ducnguyen4993/-Dispersing-Chemical-Liquids/78160_1459436697335_PF.jpg

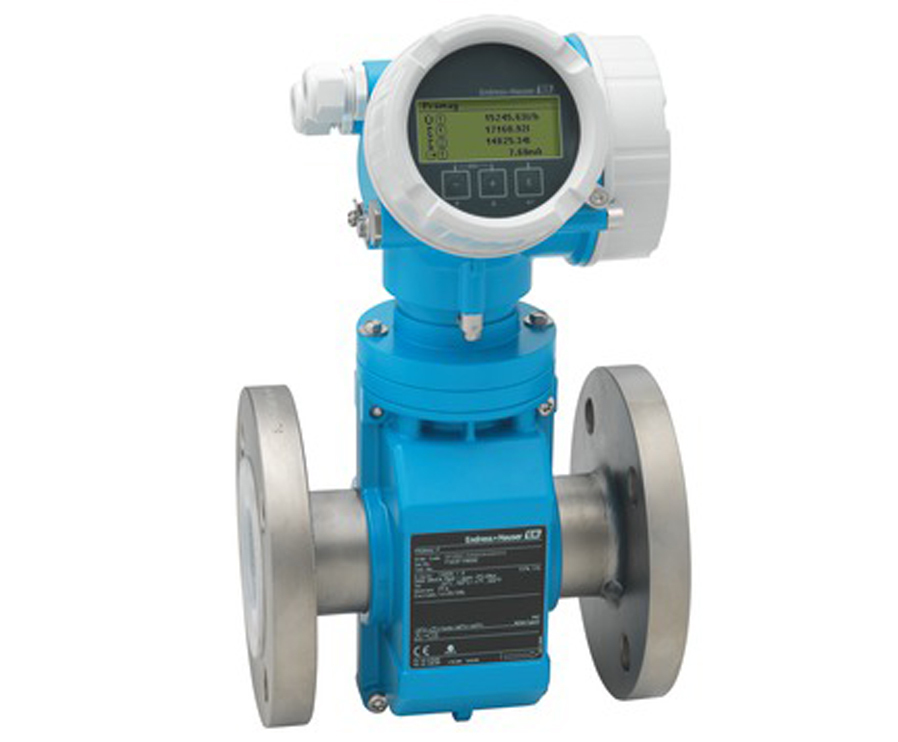
78160_1459436697335_PF.jpg
