ducnguyen4993/-Dispersing-Chemical-Liquids/axss1.jpg

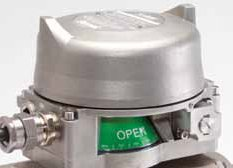
axss1.jpg
