ducnguyen4993/-Dispersing-Chemical-Liquids/IOtable.pdf

# I/O LOOP LIST

INSTRUMENTATION
PRELIMINARY
Date | Name | Change | Rev.
| Group 8: Duc Nguyen & Hieu Nguyen
Loop Tag | Loop Desc 1 | Loop Desc 2 | # | Device Tag | DCS Range | DCS Unit | Device Name | FBC slot | Card | I/O Address | AAI | AI | AO | BI | BO | Signal | Supply | Remarks | Rev.
HS-511 | MIXING TANK | NaOH VALVE | 1 | ZSO_511 | - | | OPEN LIMIT | 2 | 0 | 2.0.0.0 | | | | 1 | | NO
HS-511 | MIXING TANK | NaOH VALVE | 2 | ZSC_511 | - | | CLOSED LIMIT | 2 | 0 | 2.0.0.1 | | | | 1 | | NO
HS-511 | MIXING TANK | NaOH VALVE | 3 | GSV_511 | - | | SOLENOID VALVE | 2 | 3 | 2.0.3.0 | | | | | 1 | | 6 Bar
HS-510 | MIXING TANK | WATER VALVE | 1 | ZSO_510 | - | | OPEN LIMIT | 2 | 0 | 2.0.0.2 | | | | 1 | | NO
HS-510 | MIXING TANK | WATER VALVE | 2 | ZSC_510 | - | | CLOSED LIMIT | 2 | 0 | 2.0.0.3 | | | | 1 | | NO
HS-510 | MIXING TANK | WATER VALVE | 3 | GSV_510 | - | | SOLENOID VALVE | 2 | 3 | 2.0.3.1 | | | | | 1 | | 6 Bar
LI-512 | MIXING TANK | LEVEL | 1 | LT-512 | 0-2000 | mm | LEVEL SENSOR | 3 | 0 | 3.0.0.0 | | 1 | | | | 4-20mA
TI-517 | MIXING TANK | TEMPERATURE | 1 | TT-517 | 0-100 | °C | TEMPERATURE SENSOR | 3 | 0 | 3.0.0.1 | | 1 | | | | 4-20mA
HS-514 | STORAGE TANK | MIXING TANK | 1 | ZSO_514 | - | | OPEN LIMIT | 2 | 0 | 2.0.0.4 | | | | 1 | | NO
HS-514 | STORAGE TANK | MIXING TANK | 2 | ZSC_514 | - | | CLOSED LIMIT | 2 | 0 | 2.0.0.5 | | | | 1 | | NO
HS-514 | STORAGE TANK | MIXING TANK | 3 | GSV_514 | - | | SOLENOID VALVE | 2 | 3 | 2.0.3.2 | | | | | 1 | | 6 Bar
TI-518 | STORAGE TANK | TEMPERATURE | 1 | TT-518 | 0-100 | °C | TEMPERATURE SENSOR | 3 | 0 | 3.0.0.2 | | 1 | | | | 4-20mA
LI-515 | STORAGE TANK | LEVEL | 1 | LT-515 | 0-5000 | mm | LEVEL SENSOR | 3 | 0 | 3.0.0.3 | | 1 | | | | 4-20mA
LSA-513 | POWDER TANK | LEVEL | 1 | LT-513 | 0-100 | % | LEVEL SENSOR | 3 | 0 | 3.0.0.4 | | 1 | | | | 4-20mA
LSA-513 | POWDER TANK | LEVEL | 2 | LA-513 | - | - | LOW LEVEL ALARM | 2 | 2 | 2.0.2.0 | | | | 1 | | NO
HS-519 | PROCESS | PUMP | 1 | ZSO_519 | - | | OPEN LIMIT | 2 | 0 | 2.0.0.6 | | | | 1 | | NO
HS-519 | PROCESS | PUMP | 2 | ZSC_519 | - | | CLOSED LIMIT | 2 | 0 | 2.0.0.7 | | | | 1 | | NO
HS-519 | PROCESS | PUMP | 3 | GSV_519 | - | | SOLENOID VALVE | 2 | 3 | 2.0.3.3 | | | | | 1 | | 6 Bar
FIC-516 | PUMP | FLOW | 1 | FT-516 | 0.01-10 | m/s | FLOW SENSOR | 3 | 0 | 3.0.0.5 | | 1 | | | | 4-20mA
HIV-521 | STORAGE TANK | PUMP | 1 | CV_521 | 0-100 | % | CONTROL VALVE | 3 | 1 | 3.0.1.0 | | | 1 | | | 4-20mA
HIV-521 | STORAGE TANK | PUMP | 2 | PF_521 | 0-100 | % | POSITION FEEDBACK | 3 | 0 | 3.0.0.6 | | 1 | | | | 4-20mA
HIV-521 | STORAGE TANK | PUMP | 3 | ZSO_521 | - | | OPEN LIMIT | 2 | 1 | 2.0.1.0 | | | | 1 | | NO
HIV-521 | STORAGE TANK | PUMP | 4 | ZSC_521 | - | | CLOSED LIMIT | 2 | 1 | 2.0.1.1 | | | | 1 | | NO
HIV-521 | STORAGE TANK | PUMP | 5 | GSV_521 | - | | SOLENOID VALVE | 2 | 3 | 2.0.3.4 | | | | | 1 | | 6 Bar
M001 | MIXING TANK | POWDER FEED | 1 | M001_ST | | | M001 START | 2 | 3 | 2.0.3.6 | | | | | 1
Printed 5/5/2018 | IOtable.xlsx | 1 (1)
