ducnguyen4993/-Dispersing-Chemical-Liquids/projectwork.pdf

## PROJECT WORK

Dispersing Unit Design

Bachelor’s thesis

Valkeakoski Campus
Electrical and Automation Engineering

2018

Hieu Nguyen
Duc Nguyen

ABSTRACT

Electrical and Automation Engineering
Valkeakoski
Author | Nguyen Trung Hieu, Nguyen Quang Duc | Year 2018
Subject | Dispersing Unit Design
Supervisor(s) | Timo Väisänen

ABSTRACT

Based on the P&I diagram which was given by the supervisor, the objective of the project is to identify the symbols of components in the drawing and select the most suitable devices for the system of the project. In addition, the purpose of the project was also to design the cabinet for the control room, the wiring system, cable connection and software for PLC.

In the beginning, this project was instructed by the supervisor with the explanation and the plan to do the project. There are the computer tools supporting the project work which were taught and applied by the supervisor and other HAMK teachers. These tools were mainly for designing the system and software for PLC. Furthermore, the questions emerging during working on the project were answered or suggested by the supervisor. Other sources were electrical and automation manufacturers’ websites. These websites were used to choose the suitable devices and motors for the system.

In total, the project work was accomplished with fourteen types of documents such as the system drawings, cabinet layout, cable list, motor list, instruments list, etc. The design of the system met the requirement of the project and 95% of the project work could be used to build the real system in real life.

The project instructs and helps students to get familiar with real work in a professional environment and it is necessary to promote the students’ skills. These skills are suggested to be reinforced and tested more exactly by adding one more part to the project. That is to have a sample of a real system to test the students’ work in real life.
Keywords | Dispersing Unit Design, P&I diagram, cabinet, system design.
Pages | 37 pages including appendices 1 pages

CONTENTS

Appendices
Appendix 1 Name of appendix

1 INTRODUCTION

The project work’s purpose is to help students to get familiar and started with basic steps and ways of working in professional environment when implementing a small plant like an automation system and making its technical documentation. With the P&I diagram given from the supervisor, the project work was done with following documentation:
Hieu Nguyen:
- Motor list
- I/O list
- Circuit diagrams
- Cable list
- Description of circuit operation
- Definition of control circuit
- Cabinet layout
Duc Nguyen:
- Instrument list
- Loop Programming charts
- Description of Process operation
- Description of application software
- Hook-up drawings
- Table of name plates

2 TECHNICAL DOCUMENTATION

2.1 Pipe and Instrumentation diagram

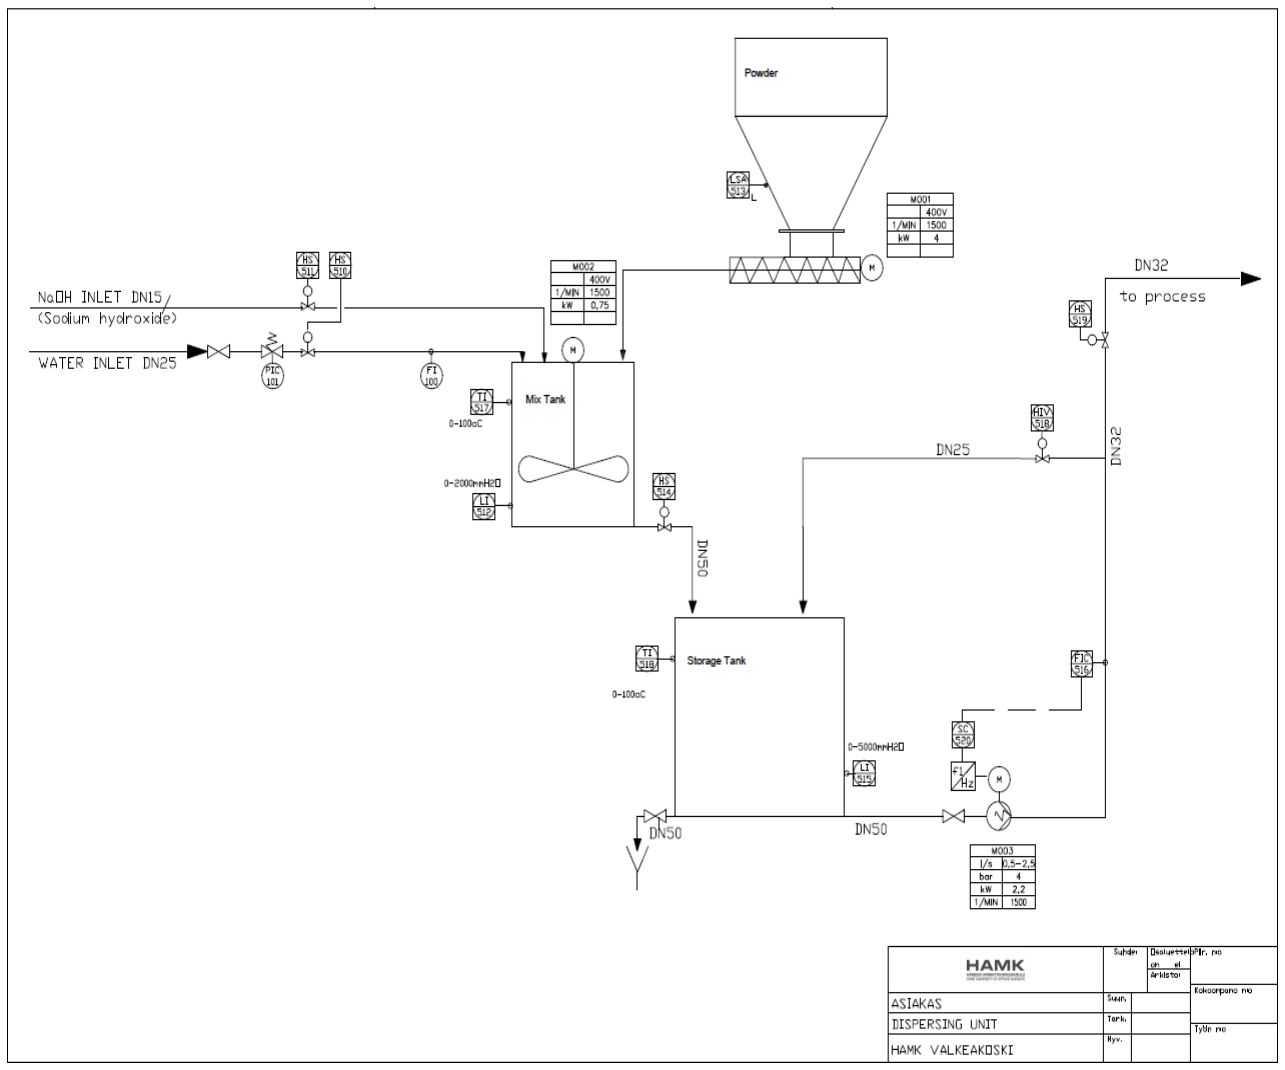
[picture p44: figure]

Figure 1. P&I diagram

2.2 Description of process operation

The operation of the dispersing unit process:
There are 4 main parts in this process:
- 1 powder distributing tank with the conveyor motor
- 1 mixing tank with the stirring motor
- 1 storage tank
- 1 pump with the speed drive

At the beginning, both the NaOH liquid and the water are conducted into the mixing tank simultaneously through the DN15 and DN25 alternately. To control the flow rate in each pipe, there are two hand valve HS-511 and HS-510 corresponded to DN15 and DN25 which are also managed in the control room. Besides that, the pressure relief valve with the pressure indicator PIC-101 and flow meter FI-100 are located on the pipe DN25 controlling on the field individually.

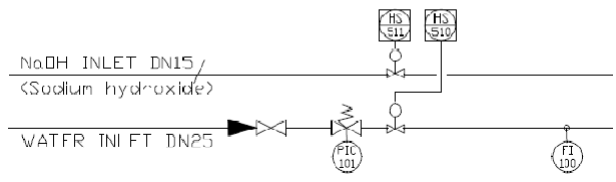
[picture p45: figure]

Figure 2. Beginning of the process

Concurrently the powder from the powder tank is dispatched by the conveyor motor MO-01 with the mixing liquid NaOH and water into the mixing tank. On the side of the power tank, the low-level switch alarm LSA-513 is adjusted for operating the powder level.

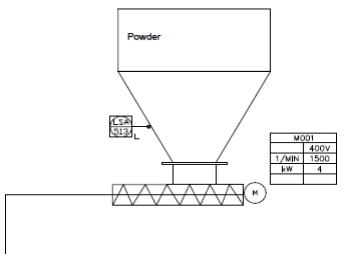
[picture p46: figure]

Figure 3. Powder tank with dispatching conveyor

The following stage of the process is all the materials is leaded into the mixing tank and stirred by the stirring motor MO-02. The temperature transmitter TI-517 for the set point range 0-100℃and the hydrostatic low-level transmitter LI-512 for the set point range 0-2000mmH2O are merged on the side of the tank indicating the temperature and level of the mixed liquid to the control room.

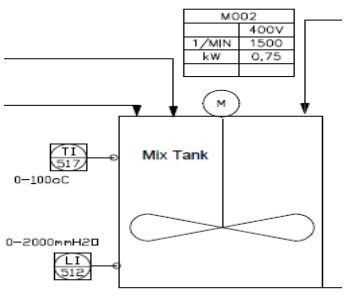
[picture p47: figure]

Figure 4. Mix tank with stirring motor

After the mixing stage, the result liquid is released into the storage tank via the pipe DN50 with the control of the hand valve HS-514. Concerning the storage tank, also the temperature transmitter for the set point range 0-100℃ TI-518 and hydrostatic low-level transmitter LI-515 for the set point range 0-5000mmH2O are attached on the side of the tank indicating the temperature and level of the liquid mixture to the control room.

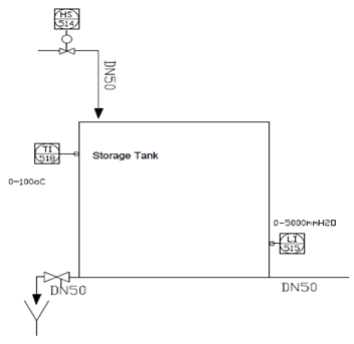
[picture p48: figure]

Figure 5. Storage tank

There is the pump motor MO-03 connected with the speed drive SC-520 drains the liquid mixture from the storage tank through the pipe DN50 to the pipe DN32. Based on the database signal from the FIC-516 flow transmitter measures the flow rate in the pipe DN32 indicating to the control room, the speed drive is adjusted to control the pump motor speed reasonably.

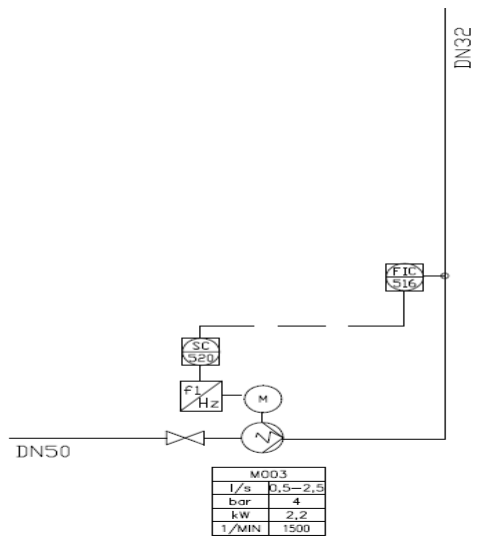
[picture p49: figure]

Figure 6. Pump motor with speed drive control

On the pipe DN32 to the next stage, the hand valve HS-519 commanded from the control room is combined. Another direction flow is the displacement of liquid back to the storage tank via the pipe DN25 and operated by the hand valve HIV-518.

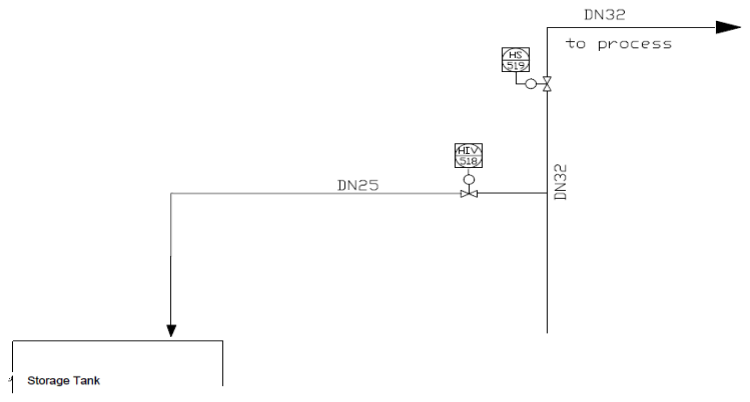
[picture p50: figure]

Figure 7. Mixture direction

2.3 Description of circuit operation

There are two main parts in the circuit operation: main power distribution circuit diagram (sheet 1, 2) and control circuit diagram (sheet 3, 4, 5). The first circuit supports power for the second circuit. The first circuit operates with a three-phase load with protection devices. Main power distribution circuit also has two power supply for 24VDC. The second circuit operates with 24VDC. The first 24VDC power supply gives power for PLC, all I/O cards and other instruments except sensors with the limit current not exceeding 5A. The other one gives power for all sensors.

2.4 Definition of control system

2.4.1 Transformer

These Schneider transformers (ABL8REM24030 and ABL8REM24050) from the manufacturer are designed for basic use in industrial applications. They provide a 24VDC power supply with different current (3A and 5A) for multiple purposes, especially when the PLC requires minimum 4A. With the input voltage from 100 to 240 V AC single phase, the transformers supply the output voltage 24VDC. Another advantage of these transformer is integrated fuse for more protection. Despite that advantage, two circuit breakers are also used to protect these transformers.

2.4.2 Protection circuit breaker

The Siemens protection devices (5SJ4108-7HG40) are miniature circuit breaker with current limiting. There are two different tripping mechanisms in these devices, the delayed thermal tripping mechanism for overload protection and the electro mechanic tripping mechanism for short circuit protection. The breaking capacity is up to 14kA at 230/400 VAC and rated currents up to 8A.

2.4.3 PLC CX5010

The PLC are Embedded PCs from the CX5000 series with Intel® Atom™ processors and differ only by the CPU version from Beckhoff manufacturer. With the installed TwinCAT runtime environment, the CX5010 can be programmed for implementation of PLC or Automation projects. With large program memory, the PLC satisfies demanding requirements:
1. For multisector automation tasks in the construction of series machines, special machines and plants.

2. Used as a central controller on production lines with central and distributed I/O.
3. High processing performance in binary and floating-point arithmetic.
4. PROFIBUS DP master/slave interface.
5. For extensive I/O configurations.
6. For setting up distributed I/O structures.
7. Comprehensive integrated system diagnosis.

2.4.4 Digital input EL1808

Manufacturer: Beckhoff
1. Digital input
2. 500V isolation
3. 8 inputs
4. 24VDC
5. Direct plug-in technique
6. IP20 protection class

2.4.5 Digital output EL2808

Manufacturer: Beckhoff
1. Digital output
2. 500V isolation
3. 8 outputs
4. 0.5 A max output current
5. 24VDC
6. Direct plug-in technique
7. IP20 protection class

2.4.6 Analog input EL3058

Manufacturer: Beckhoff
1. Analog input
2. 500V isolation
3. 8 inputs
4. 4…20 mA signal current
5. 24VDC
6. 1.25 ms
7. 12 bits resolution (16 bits including signal)
8. IP20 protection class

2.4.7 Analog Output EL4028

Manufacturer: Beckhoff
1. Analog output

2. 500V isolation
3. 8 outputs
4. 4…20 mA signal current
5. 24VDC
6. 400 µs
7. IP20 protection class

2.4.8 Motor 1: 3GAA112320-ADJ

Manufacturer: ABB
1. Power: 4kW at 400V/415V/690V 50 Hz
2. In: 8.6 A
3. Speed: 1451 rpm
4. Mounting: IM B3
5. Protection device Schneider: circuit breaker GV2-ME14, contactor LC1D09BD
a. 4 kW at 440 V AC 50/60 Hz, 4...5.5 kW at 500 V AC 50/60 Hz, 3...4 kW at 400/415 V AC 50/60 Hz
b. Magnetic Protection Adjustment Range (138 A).
c. Thermal Protection Adjustment Range (6…10 A).
d. Rated Breaking Capacity (Iq 50 kA at 400/415 V conforming to IEC60947-4-1, Iq 6 kA at 500 V conforming to IEC60947-4-1, Iq 15 kA at 440 V conforming to IEC60947-4-1).

2.4.9 Motor 2: 3GAA082614-BSJ

Manufacturer: ABB
1. Power: 0.75kW at 400V/415V/230V 50 Hz
2. In: 1.9 A
3. Speed: 1437 rpm
4. Mounting: IM V1
5. Protection device Schneider: circuit breaker GV2-ME10, contactor LC1D09BL
a. 2.2…3 kW at 440 V AC 50/60 Hz, 3 kW at 500 V AC 50/60 Hz, 2.2 kW at 400/415 V AC 50/60 Hz
b. Magnetic Protection Adjustment Range (78 A).
c. Thermal Protection Adjustment Range (4…6.3 A).
d. Rated Breaking Capacity (Iq 50 kA at 400/415 V conforming to IEC60947-4-1, Iq 50 kA at 500 V conforming to IEC60947-4-1, Iq 50 kA at 440 V conforming to IEC60947-4-1).

2.4.10 Motor 3: 3GAA102530-ASJ

Manufacturer: ABB
1. Power: 2.2kW at 400V/415V/230V 50 Hz

2. In: 4.6 A
3. Speed: 1455 rpm
4. Mounting: IM B3
5. Protection device Schneider: circuit breaker GV2-ME10, contactor LC1D09BL
a. 2.2…3 kW at 440 V AC 50/60 Hz, 3 kW at 500 V AC 50/60 Hz, 2.2 kW at 400/415 V AC 50/60 Hz
b. Magnetic Protection Adjustment Range (78 A).
c. Thermal Protection Adjustment Range (4…6.3 A).
d. Rated Breaking Capacity (Iq 50 kA at 400/415 V conforming to IEC60947-4-1, Iq 50 kA at 500 V conforming to IEC60947-4-1, Iq 50 kA at 440 V conforming to IEC60947-4-1).

2.4.11 Solenoid valve

NITRA pneumatic directional control solenoid valve, 5-port (4-way), 2-position, spool valve with aluminium body, optional manifold mounting, 1/8-inch NPT female ports, Cv=0.67, 24VDC double solenoid, 9.4mm DIN style wiring connector with LED indication

2.5 Description of application software

The process programs are designed for 2 level indicators, 2 temperature indicators, 1 flow indicator, 1 level switch alarm, 1 conveyor motor, 1 stirring motor, 1 pump motor, 1 speed drive and 4 hand valves.

Level indicators and temperature indicators measure the value via the hydrostatic level transmitter and the temperature transmitter thus shown on the screen in the control room. The program illustrates 1 analog input signal which is the measurement value.

The electro-magnetic flow transmitter adjusts the value which is also represented in the control room and simultaneously based on that to control speed drive. There is 1 analog input signal which is shown as the measurement value from the flow transmitter. Program gets 1 output into the speed drive and 1 output for the positioning state. Besides that, there is the binary signal for controlling mode.

The speed drive manages the pump motor frequency. It receives the binary input as the frequency unit on/off and another binary input is to set mode as manual/auto. The program obtains 1 binary output signal to adjust the start/stop of the speed drive.

The level switch alarm which has a level transmitter checks the level value inside the powder tank and alarm in case of lower level limit. The input signal is as the level value, 1 output signal for setting alarm off whenever the switch alarm is triggered and 1 output signal for positioning state.

Each hand valve controls the flow rate in its pipe. The open limit state and close limit state are displayed in the control room. The program reads 2 binary input signals as the state being used and 1 output to control the valve.

The control valve has a sensor in the field for characterizing and representing the state position of the valve to the control room. There is 1 input signal into the program as the sensing value of position, 1 output for managing the valve and 1 output for the position feedback.

The conveyor motor shifts the powder from the powder tank to the mixing tank, otherwise the stirring motor blends the mixture. There is 1 input as the run state and 1 input as the electric centre fault. Program sets 1 output to control motor and 1 output for manual/auto mode.

The pump motor is governed by the motor drive. There is also 1 input as the run state and 1 input as the electric centre fault. The other is the input of frequency from motor drive for operating motor speed.

2.6 Instrument list

Table 1. Valve list

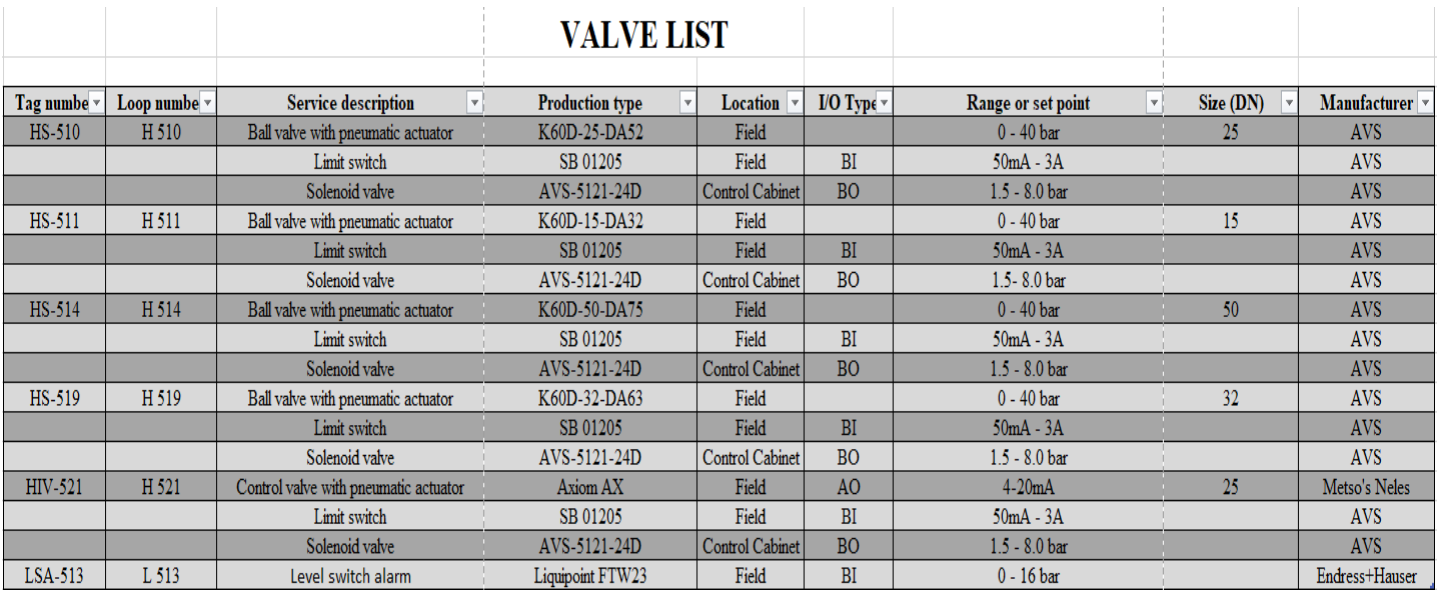
[picture p51: figure]
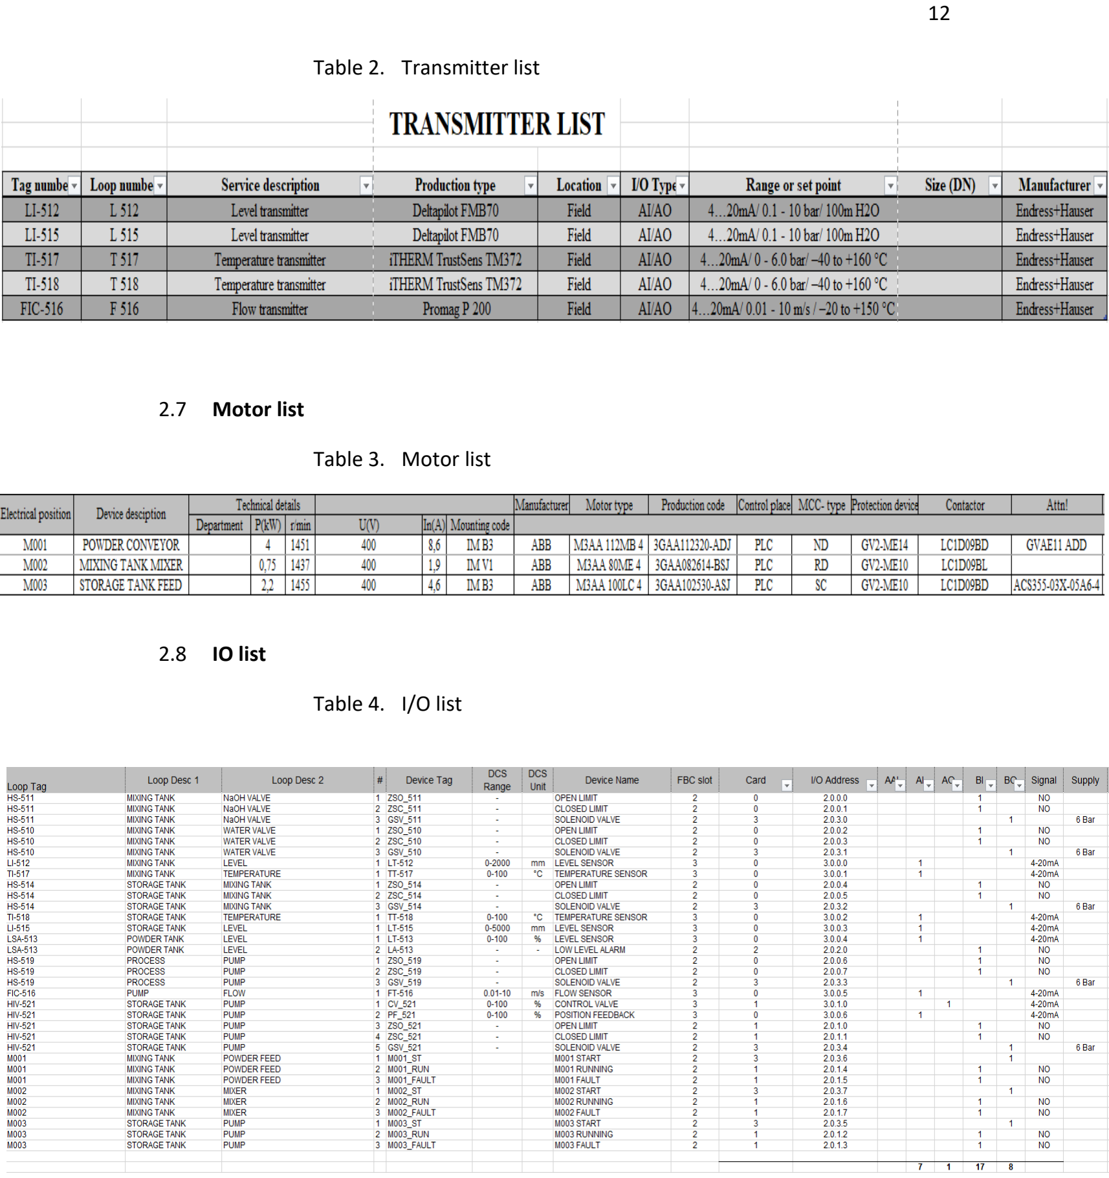
[picture p52: page 15]

Table 2. Transmitter list

2.7 Motor list

Table 3. Motor list

2.8 IO list

Table 4. I/O list

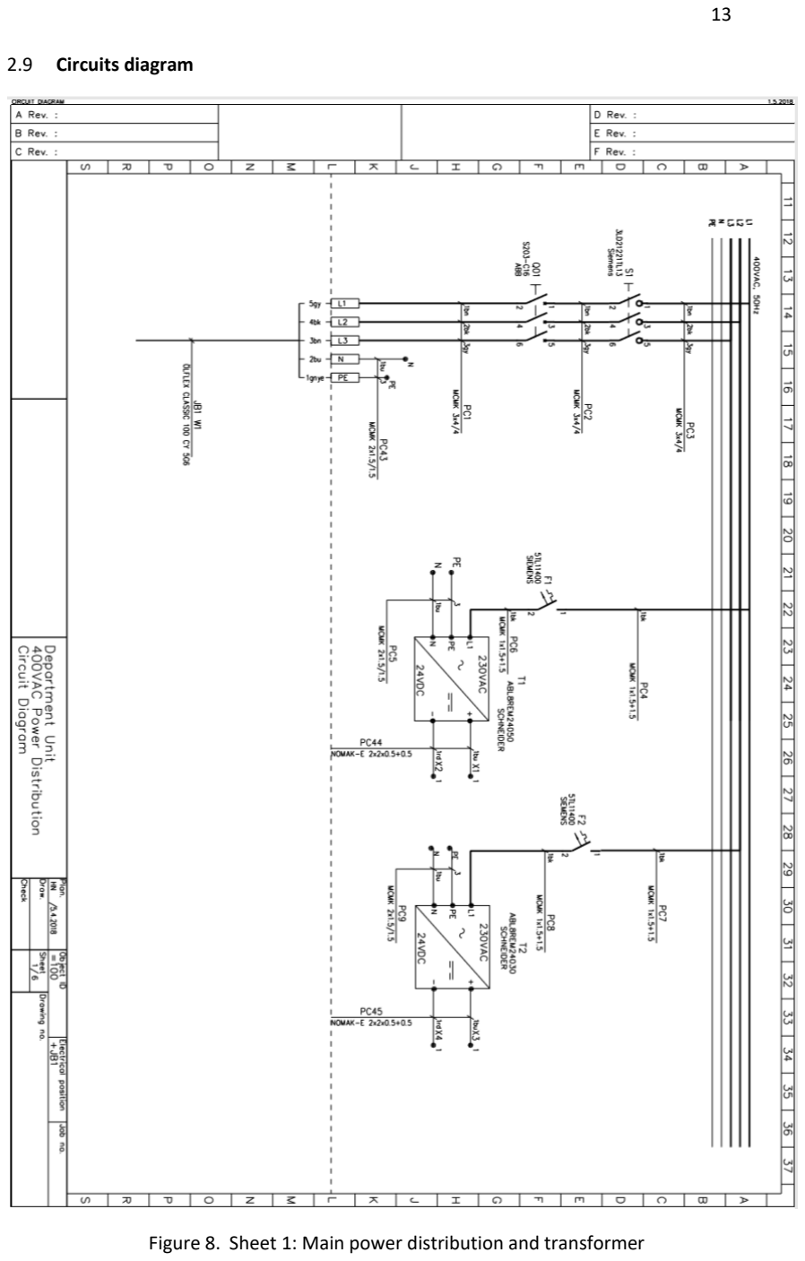
[picture p53: page 16]

2.9 Circuits diagram

Figure 8. Sheet 1: Main power distribution and transformer

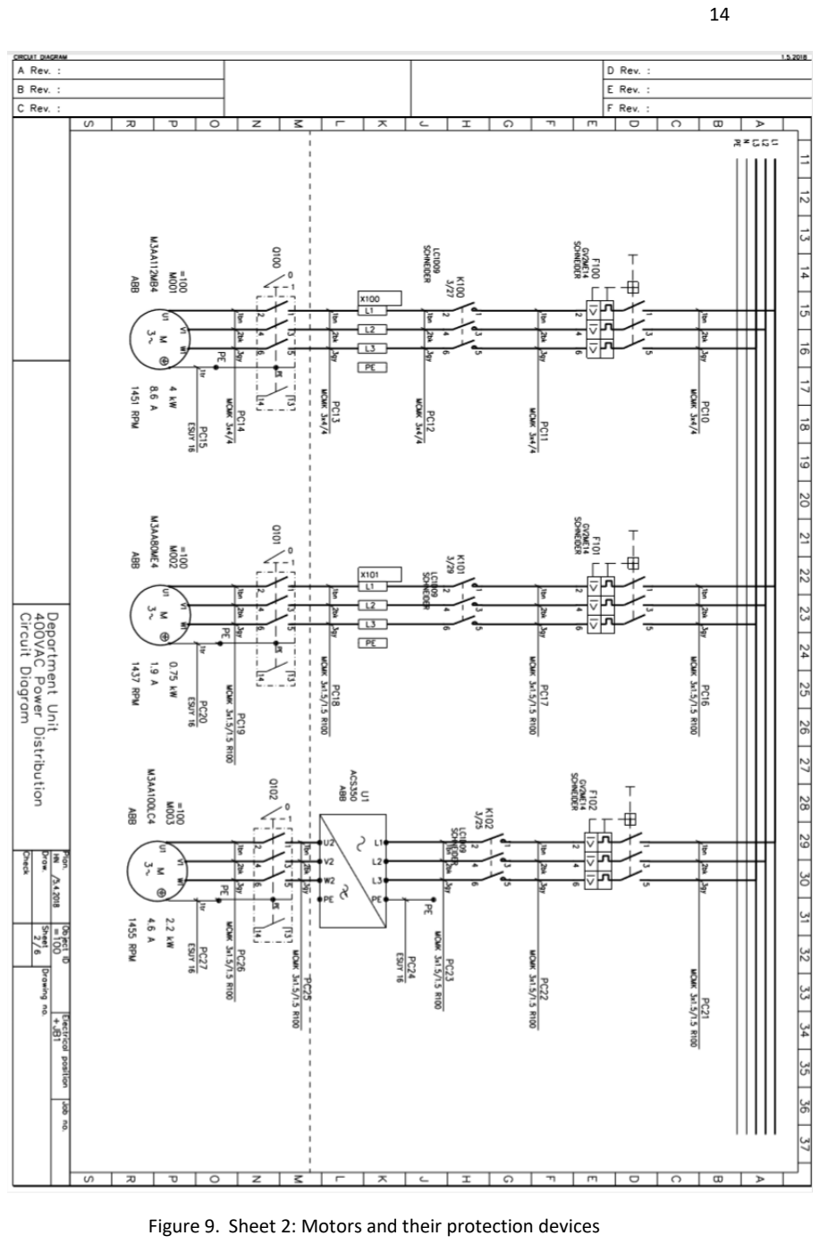
[picture p54: page 17]

Figure 9. Sheet 2: Motors and their protection devices

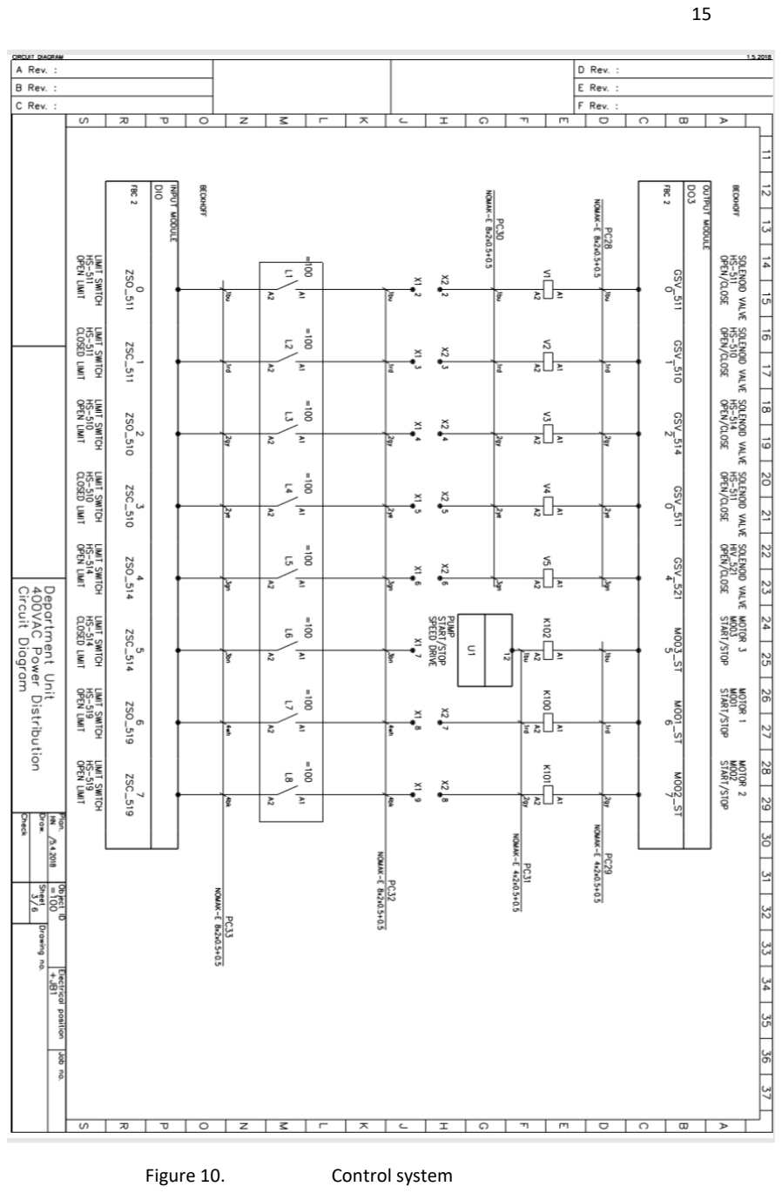
[picture p55: page 18]

Figure 10. | Control system

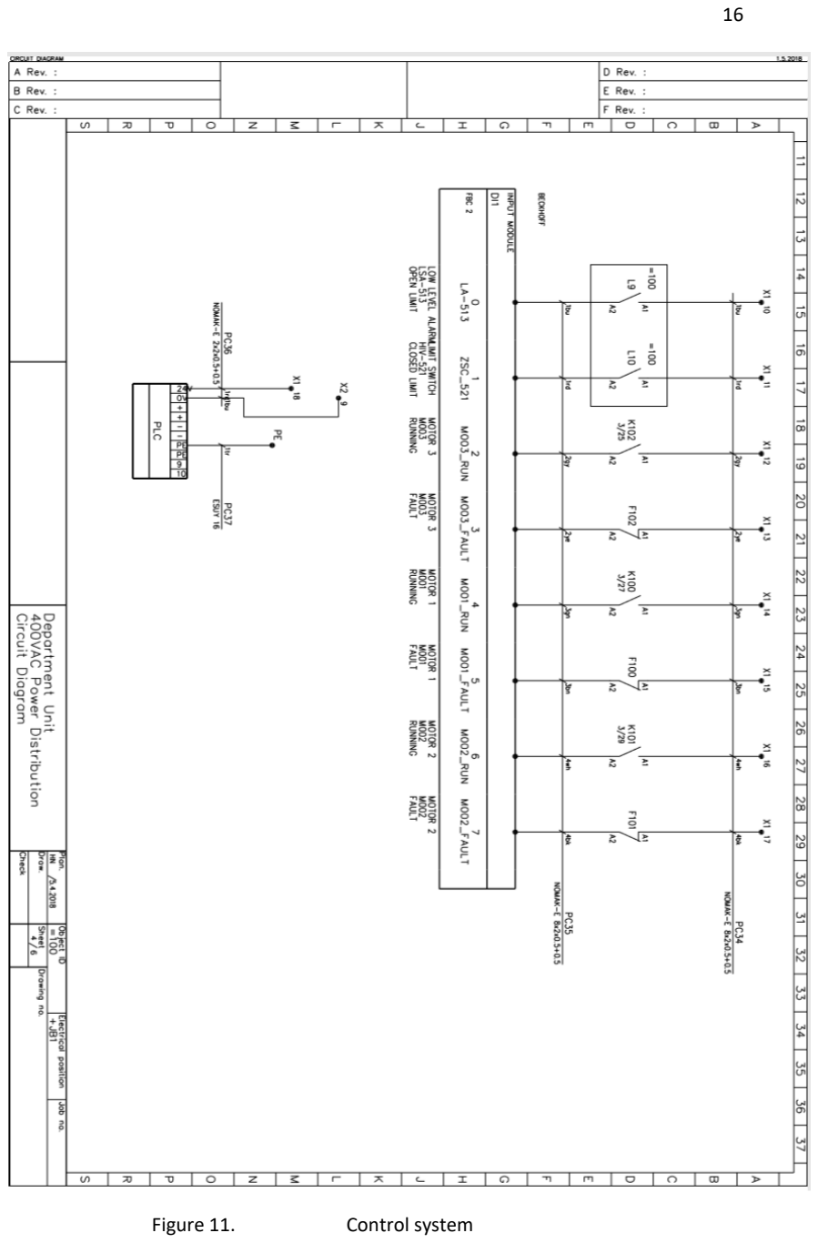
[picture p56: page 19]

Figure 11. | Control system

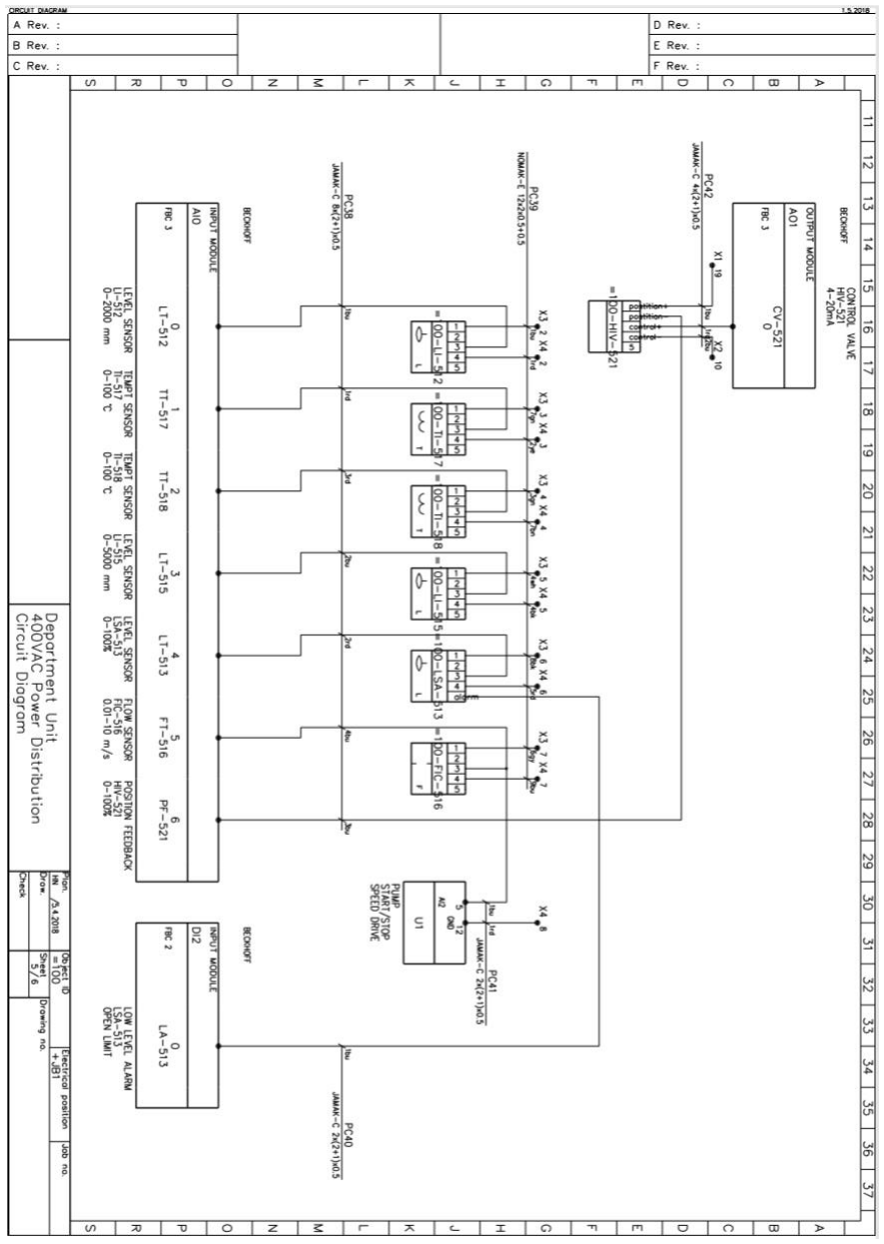
[picture p57: figure]

Figure 12. | Sensors

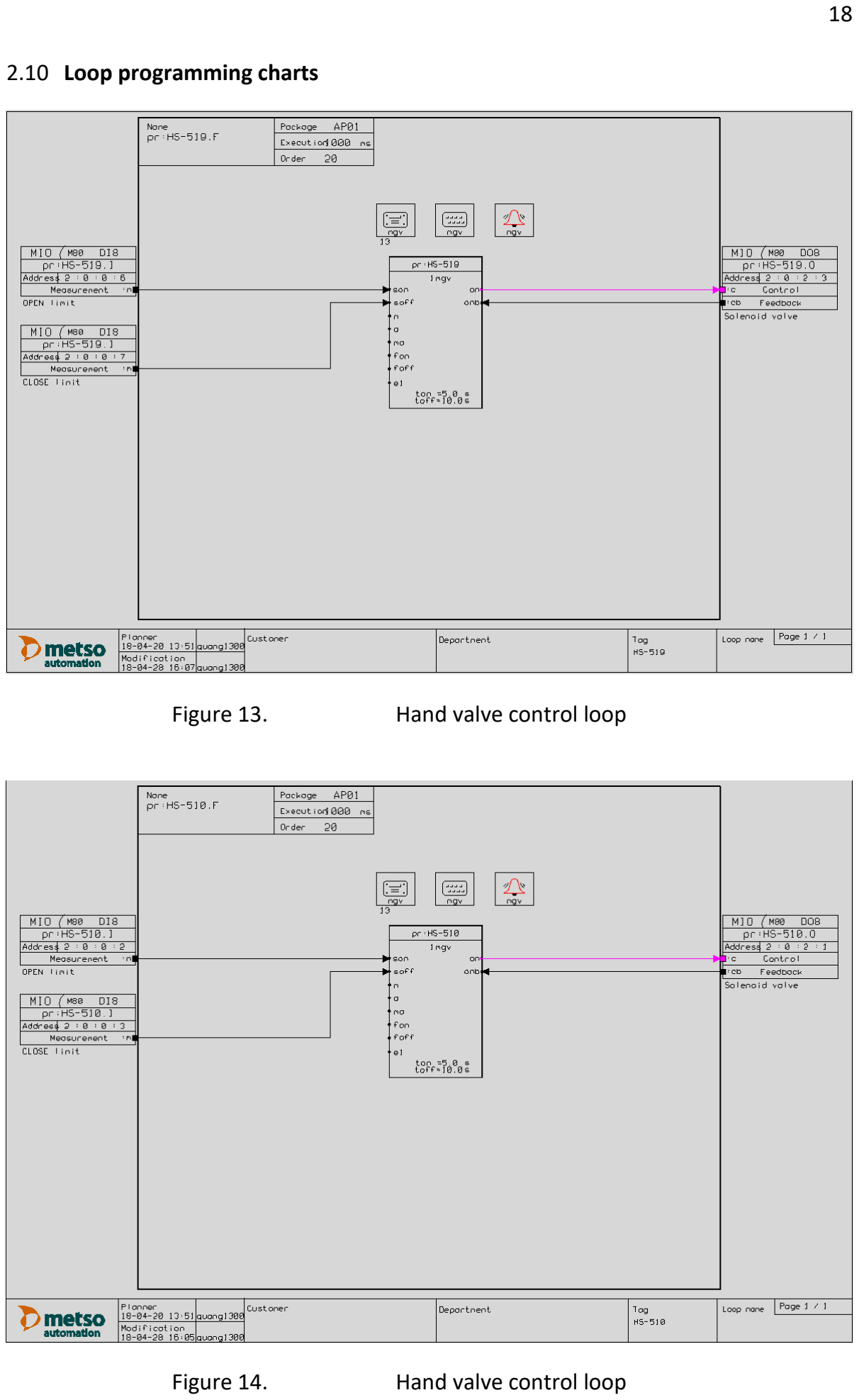
[picture p58: page 21]

2.10 Loop programming charts

Figure 13. | Hand valve control loop
Figure 14. | Hand valve control loop

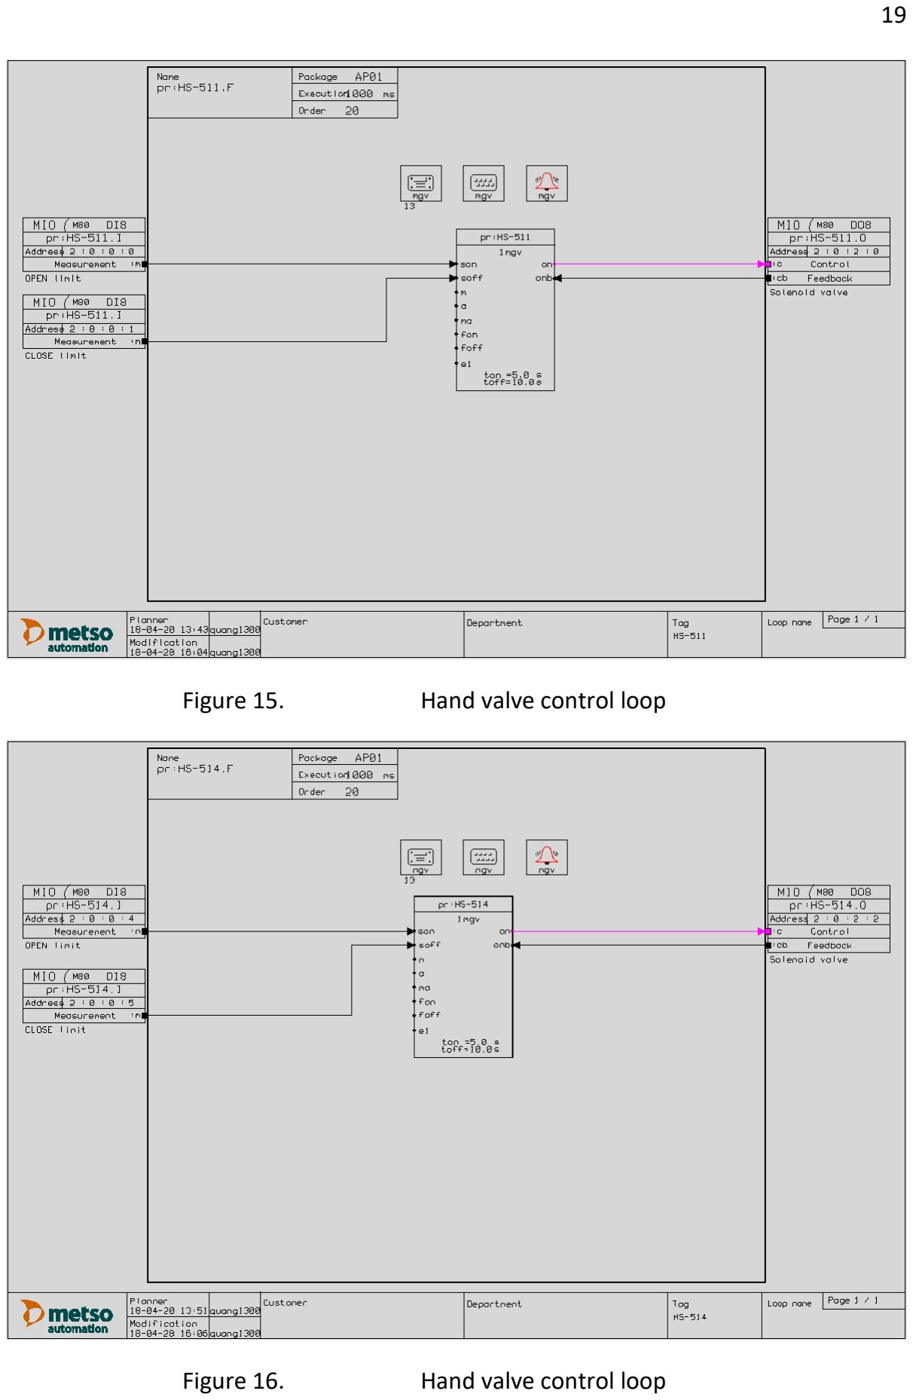
[picture p59: page 22]

Figure 15. | Hand valve control loop
Figure 16. | Hand valve control loop

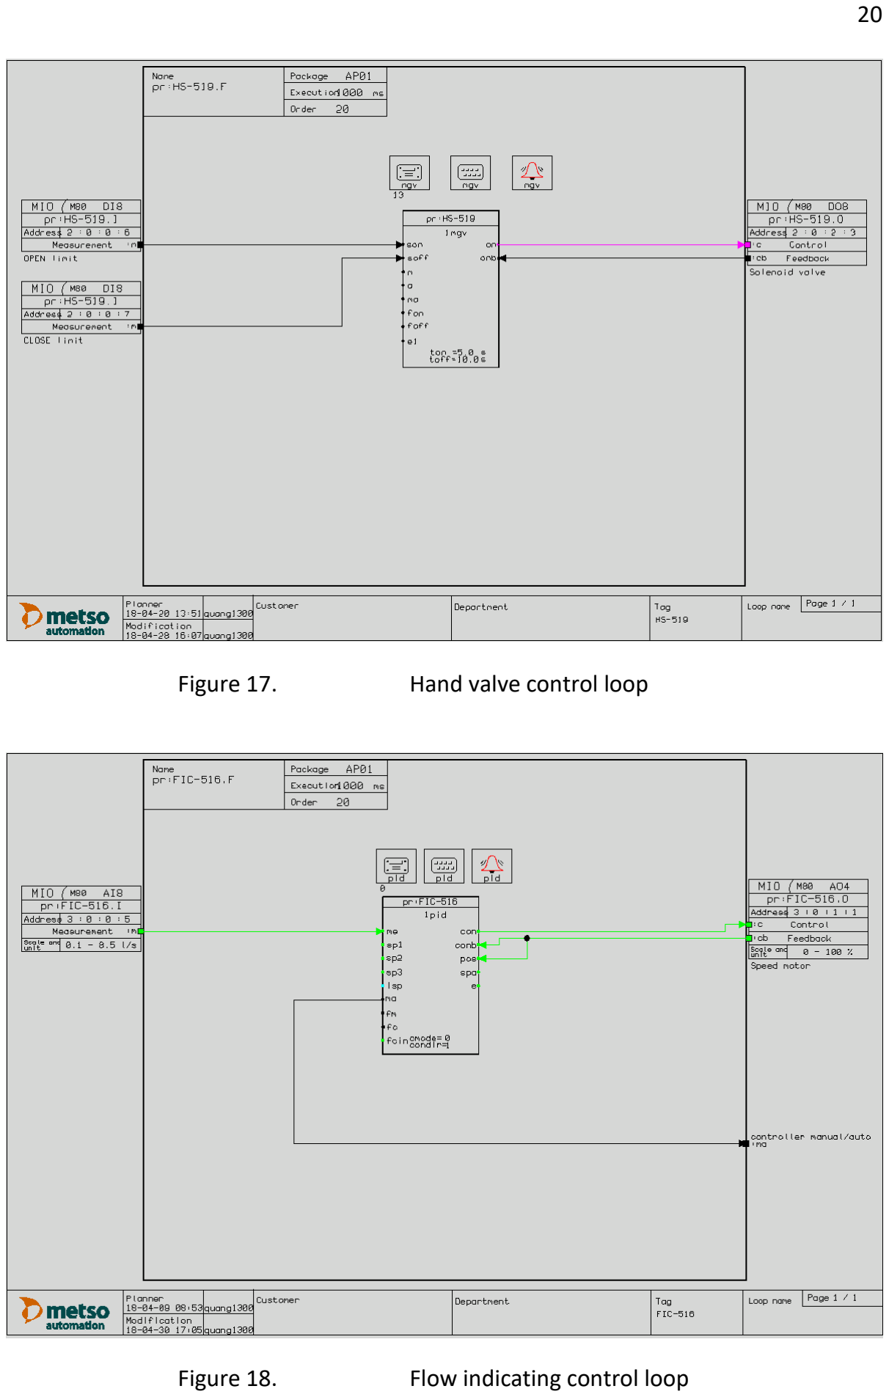
[picture p60: page 23]

Figure 17. | Hand valve control loop
Figure 18. | Flow indicating control loop

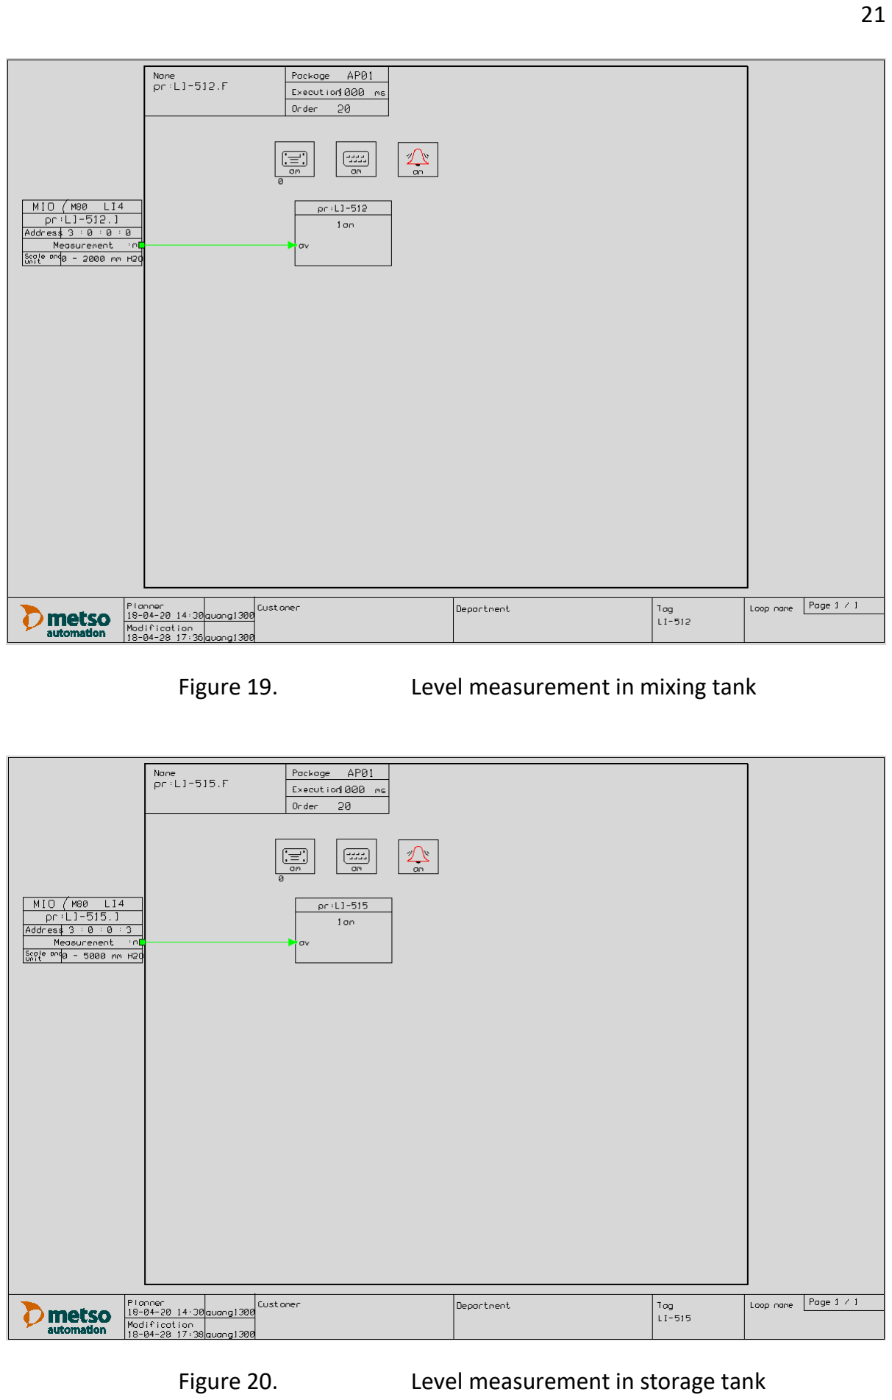
[picture p61: page 24]

Figure 19. | Level measurement in mixing tank
Figure 20. | Level measurement in storage tank

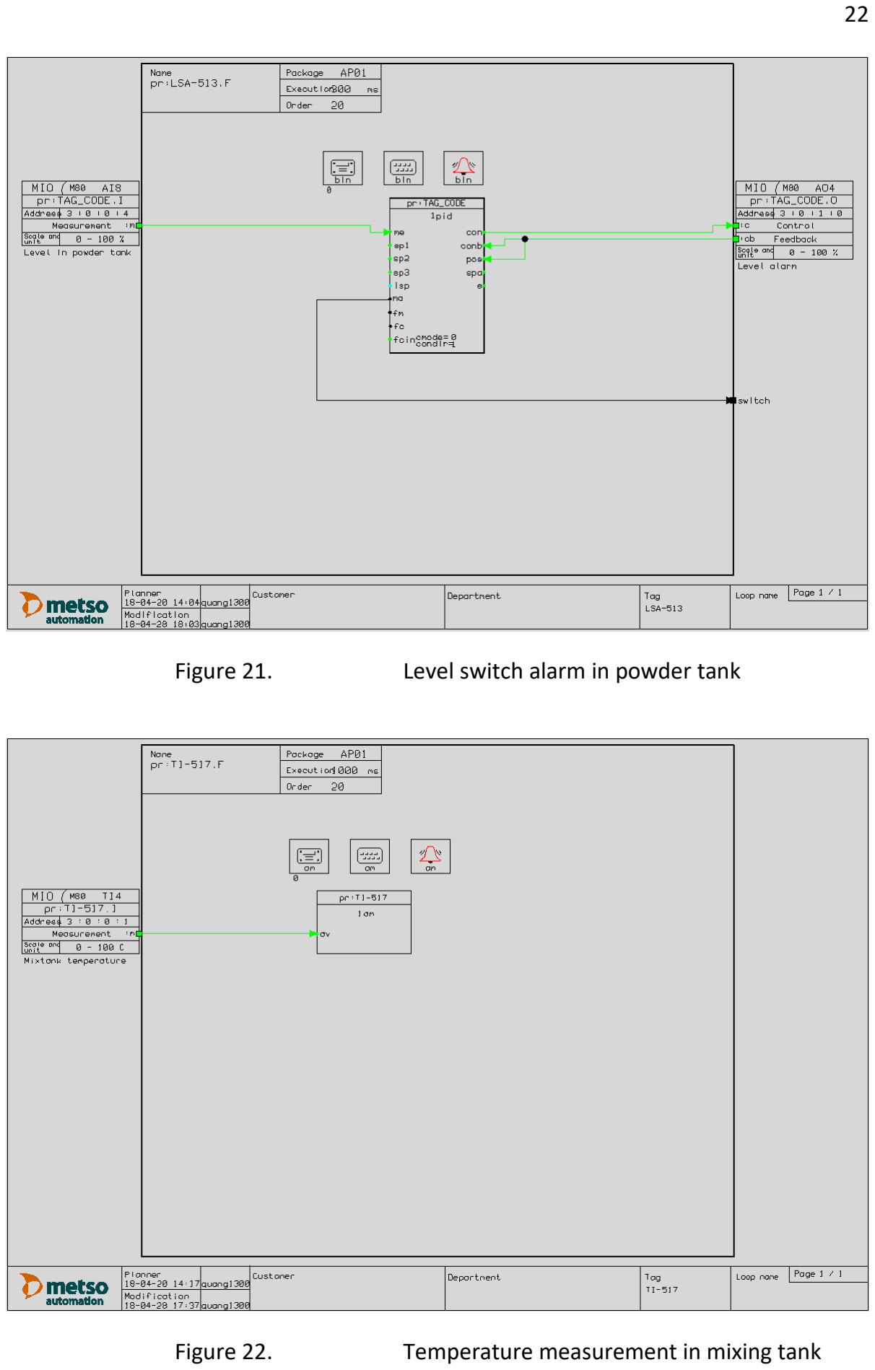
[picture p62: page 25]

Figure 21. | Level switch alarm in powder tank
Figure 22. | Temperature measurement in mixing tank

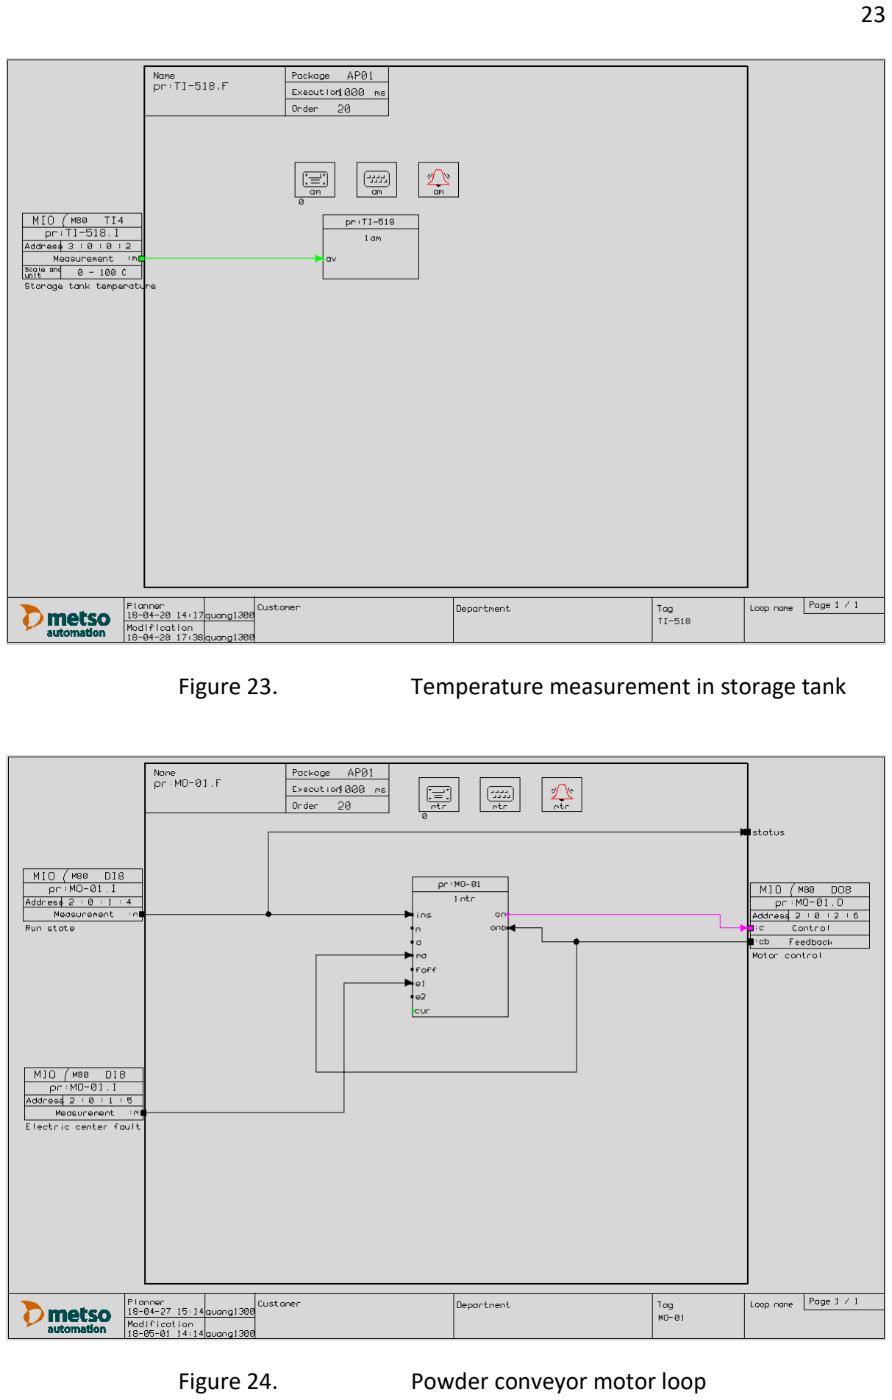
[picture p63: page 26]

Figure 23. | Temperature measurement in storage tank
Figure 24. | Powder conveyor motor loop

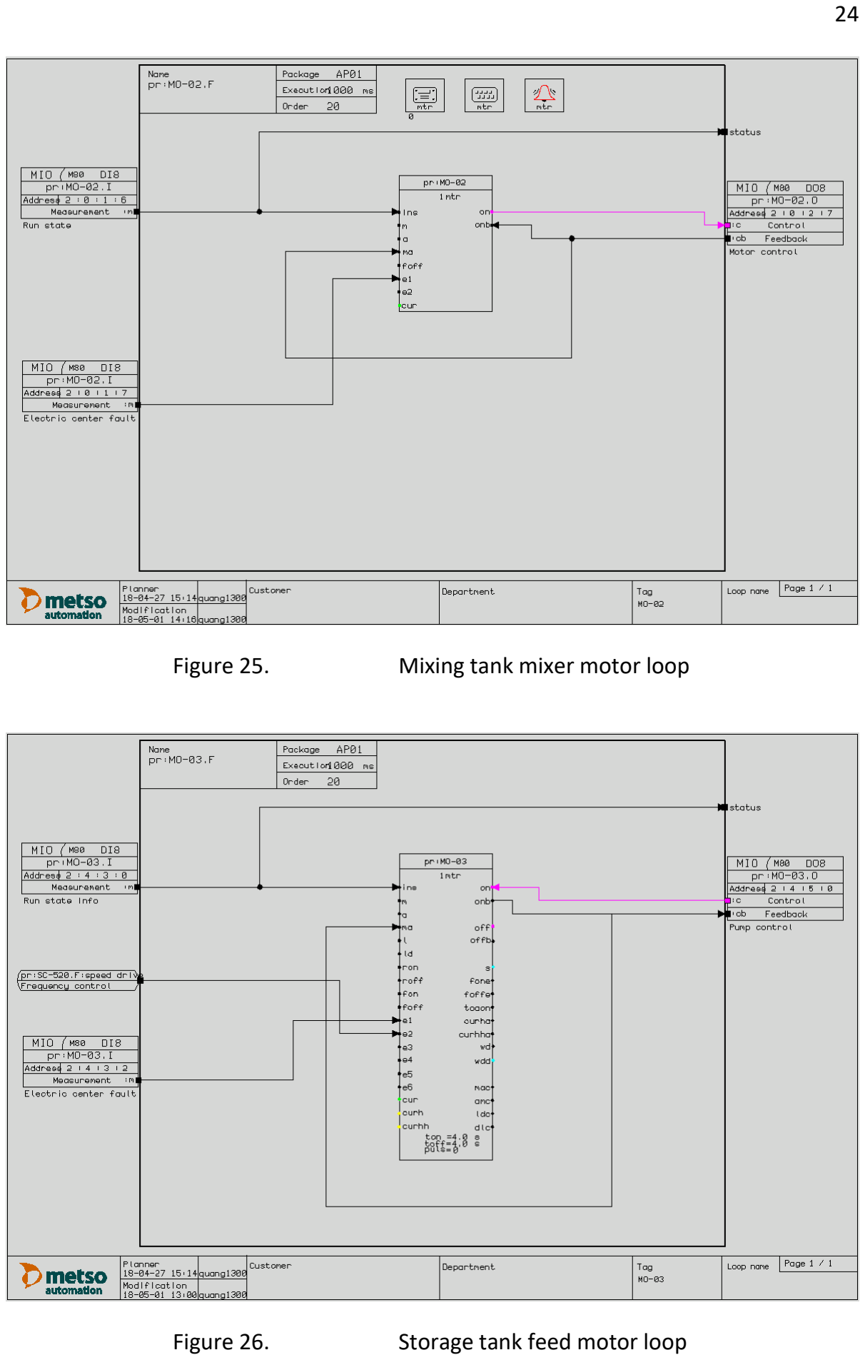
[picture p64: page 27]

Figure 25. | Mixing tank mixer motor loop
Figure 26. | Storage tank feed motor loop

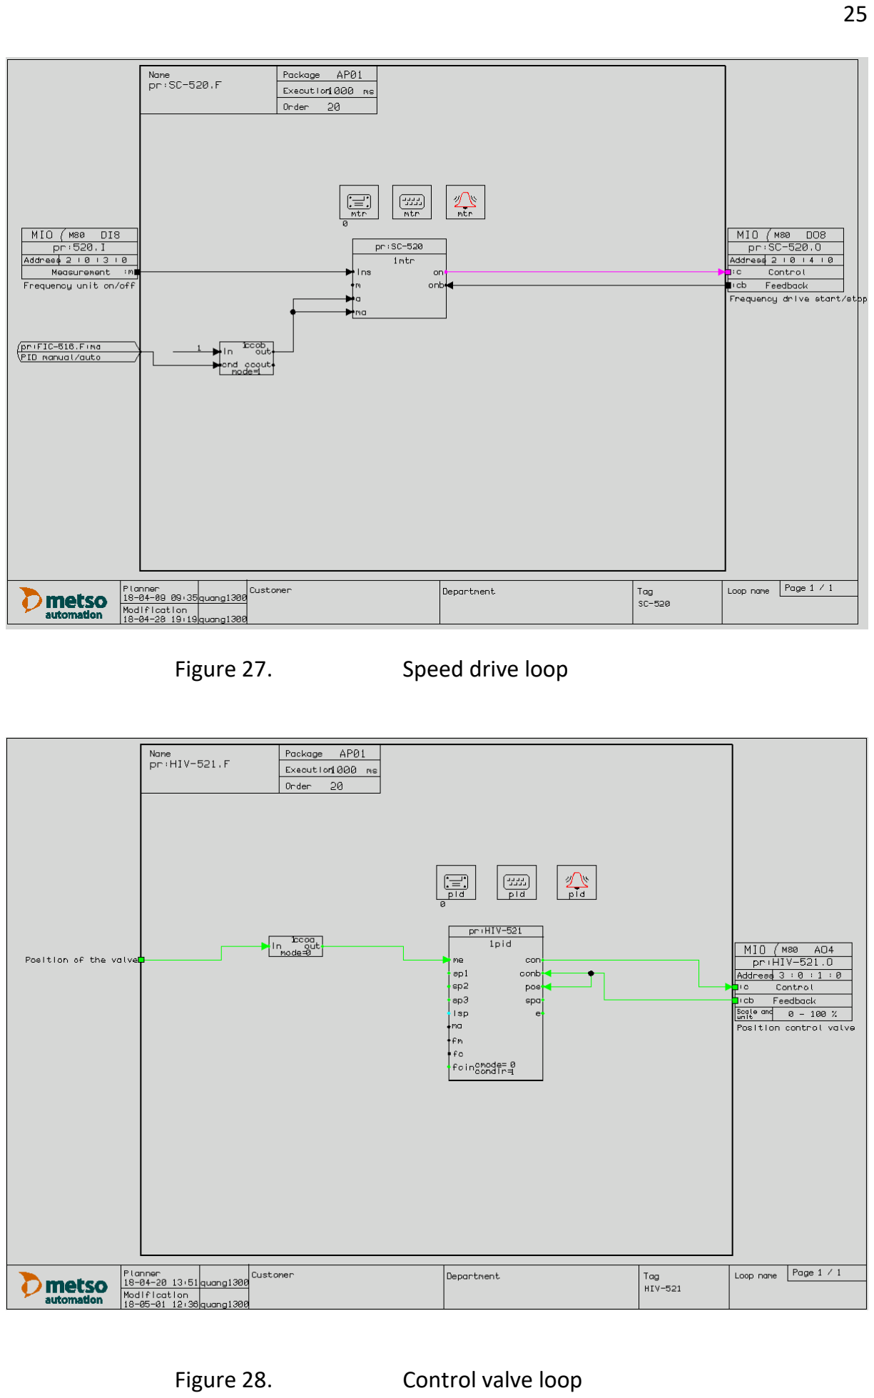
[picture p65: page 28]

Figure 27. | Speed drive loop
Figure 28. | Control valve loop

2.11 Cabinet layout image

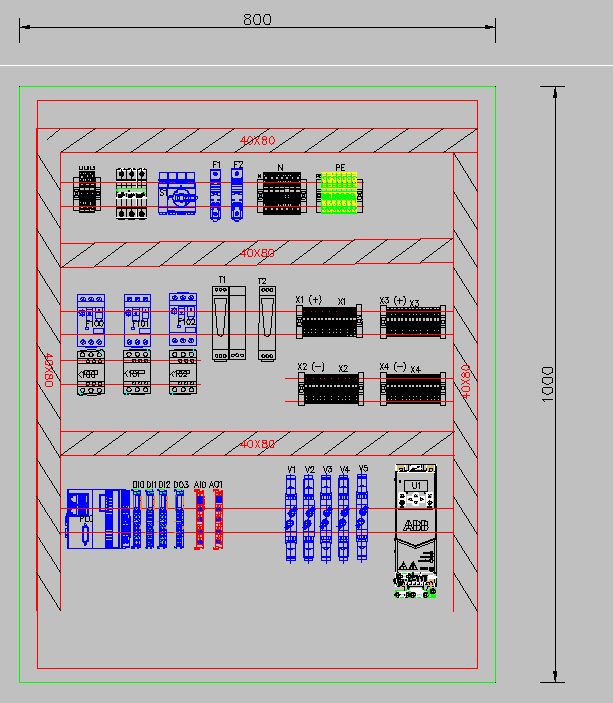
[picture p66: figure]

Figure 29. | Cabinet layout

2.12 Hook up drawings


Figure 30. | Level measurement with flanged transmitter


Figure 31. | Level measurement, level switch


Figure 32. | On/off valve with solenoid valve and limit
switch


Figure 33. | Temperature measurement flanged process
connection


Figure 34. | Flow measurement electro-magnetic flow
transmitter

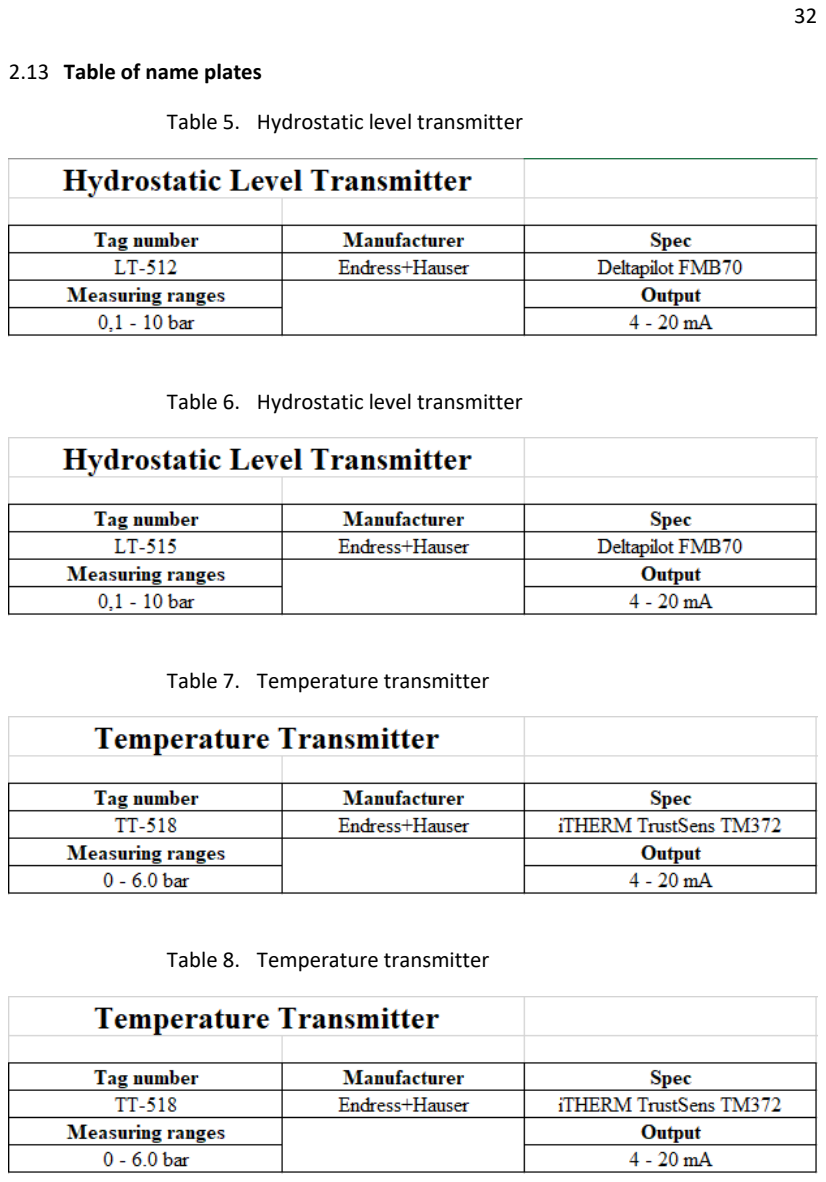
[picture p67: page 35]

2.13 Table of name plates

Table 5. Hydrostatic level transmitter

Table 6. Hydrostatic level transmitter

Table 7. Temperature transmitter

Table 8. Temperature transmitter

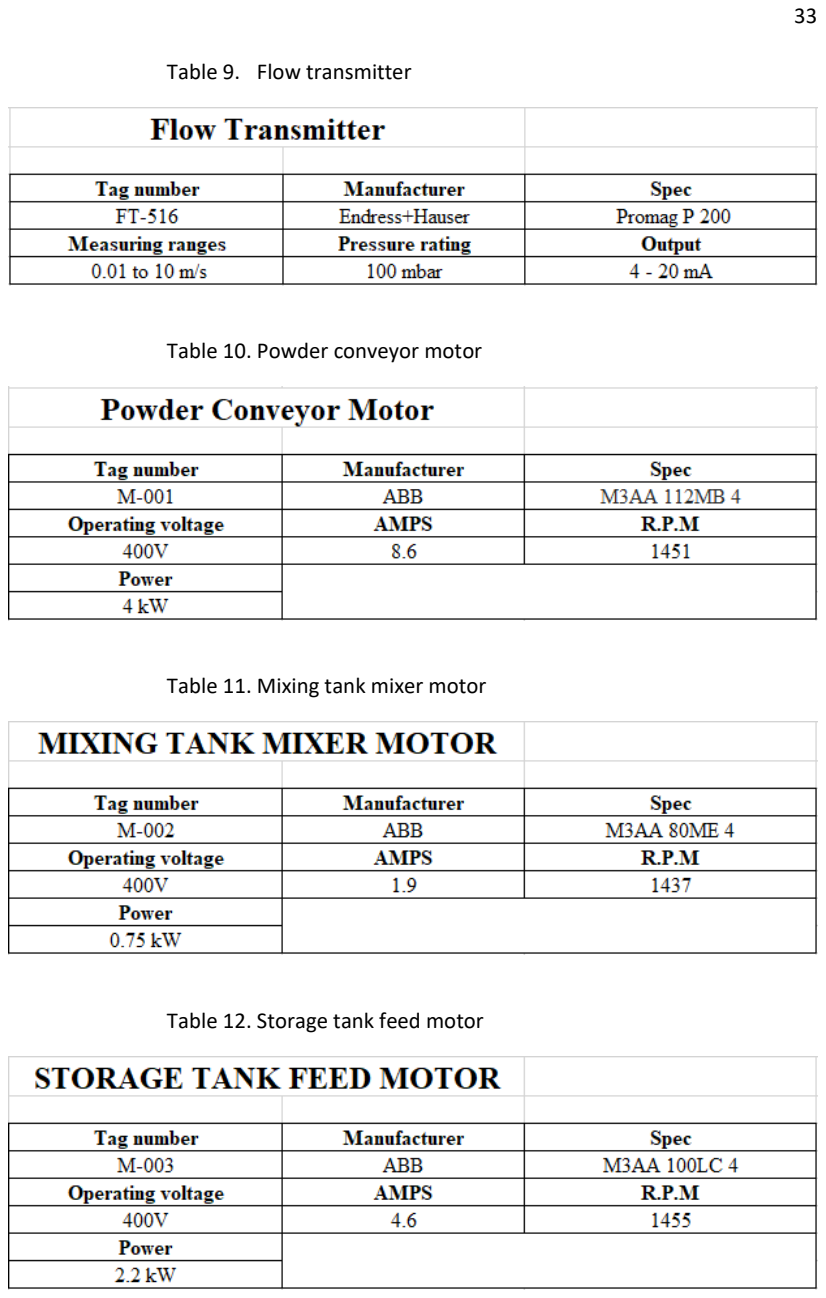
[picture p68: page 36]

Table 9. Flow transmitter

Table 10. Powder conveyor motor

Table 11. Mixing tank mixer motor

Table 12. Storage tank feed motor

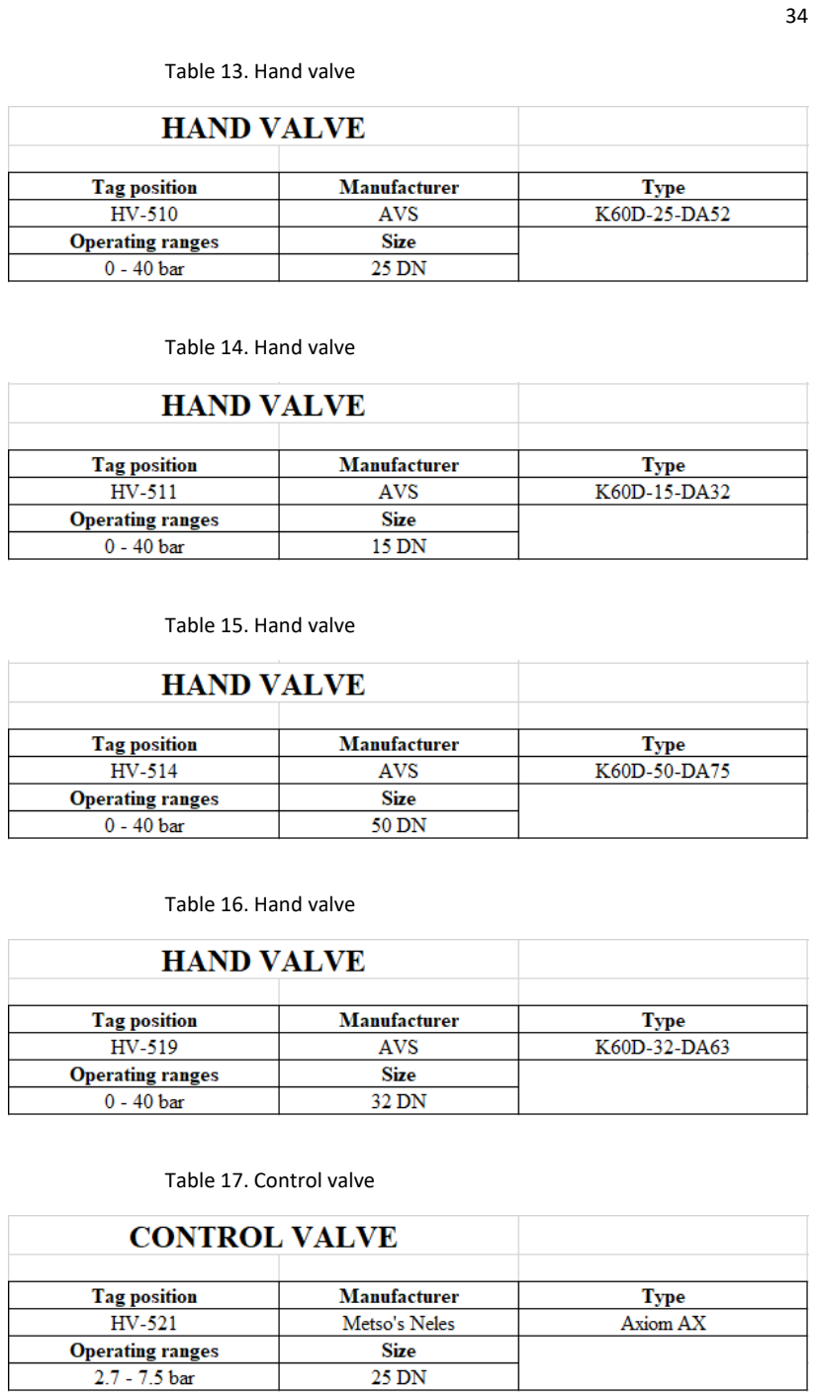
[picture p69: page 37]

Table 13. Hand valve

Table 14. Hand valve

Table 15. Hand valve

Table 16. Hand valve

Table 17. Control valve

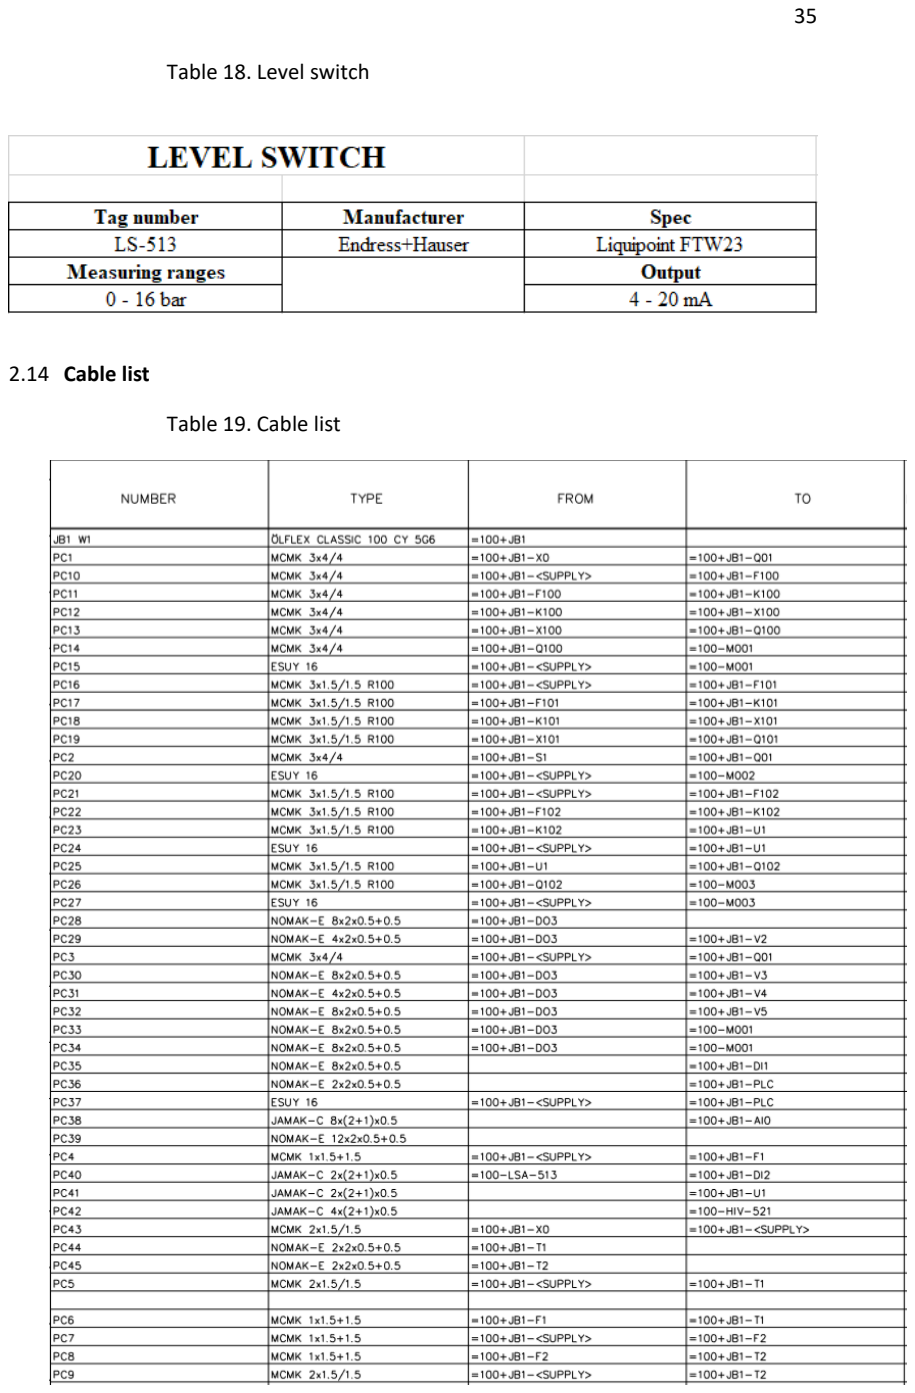
[picture p70: page 38]

Table 18. Level switch

2.14 Cable list

Table 19. Cable list

3 CONCLUSION

In conclusion, the project work prepares students skills and knowledges for doing a plant in real world. From understanding the requirement of the plant to searching for suitable instruments and devices makes students to know more intimately and how the process works. With all documentations from hardware selection to software programming, the project is like an assignment for an engineering in professional environment.

Appendix 1
APPENDIX HEADING
