ducnguyen4993/-Dispersing-Chemical-Liquids/loopdiagram/a2.png

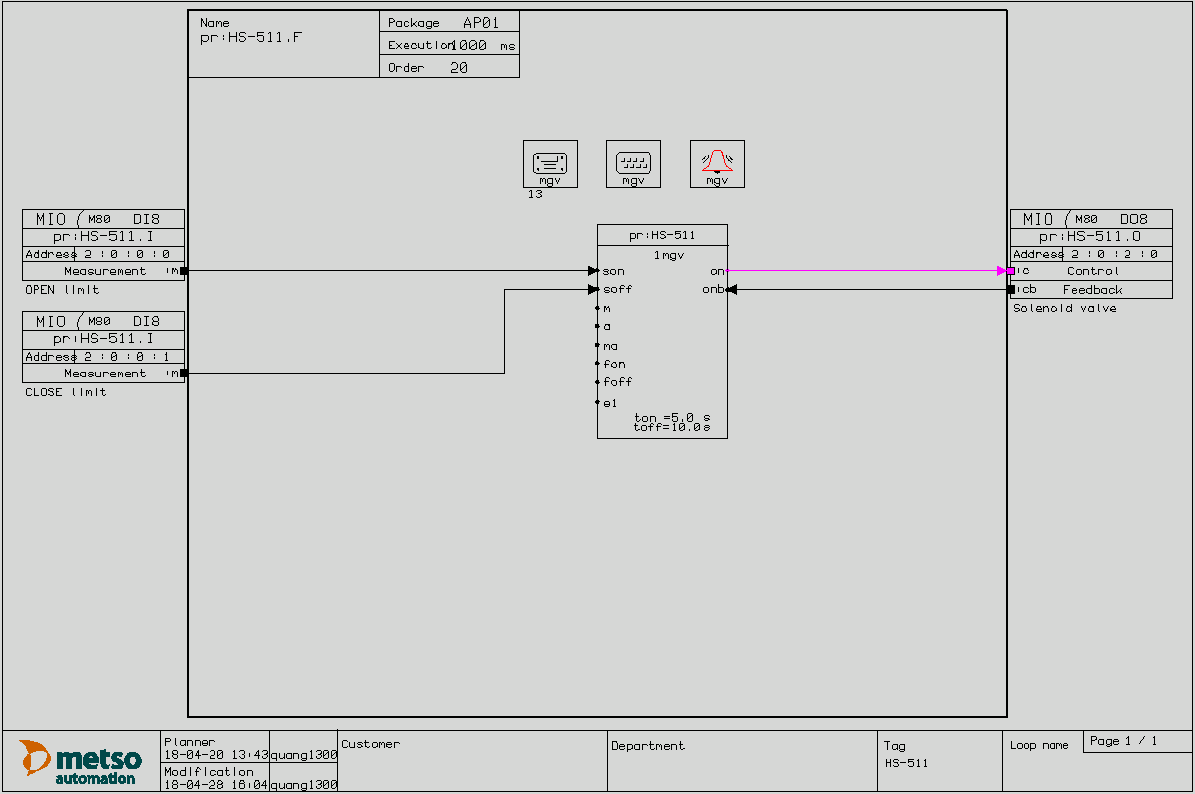
loopdiagram/a2.png
