ducnguyen4993/-Dispersing-Chemical-Liquids/software/6.PNG

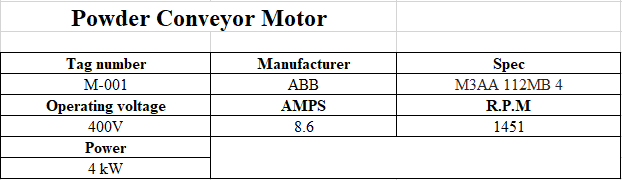
software/6.PNG
