ducnguyen4993/-Dispersing-Chemical-Liquids/software/7.PNG

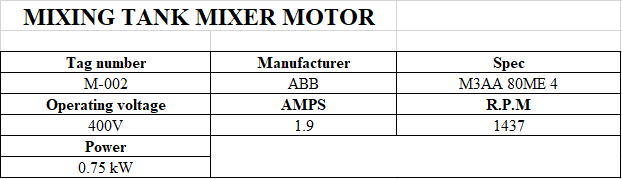
software/7.PNG
