ducnguyen4993/-Dispersing-Chemical-Liquids/instrumentlist.xlsx

Group 8: Duc Nguyen & Hieu Nguyen
 |  |  | VALVE LIST
Tag number | Loop number | Service description | Production type | Location | I/O Type | Range or set point | Size (DN) | Manufacturer
HS-510 | H 510 | Ball valve with pneumatic actuator | K60D-25-DA52 | Field |  | 0 - 40 bar | 25 | AVS
 |  | Limit switch | SB 01205 | Field | BI | 50mA - 3A |  | AVS
 |  | Solenoid valve | AVS-5121-24D | Control Cabinet | BO | 1.5 - 8.0 bar |  | AVS
HS-511 | H 511 | Ball valve with pneumatic actuator | K60D-15-DA32 | Field |  | 0 - 40 bar | 15 | AVS
 |  | Limit switch | SB 01205 | Field | BI | 50mA - 3A |  | AVS
 |  | Solenoid valve | AVS-5121-24D | Control Cabinet | BO | 1.5- 8.0 bar |  | AVS
HS-514 | H 514 | Ball valve with pneumatic actuator | K60D-50-DA75 | Field |  | 0 - 40 bar | 50 | AVS
 |  | Limit switch | SB 01205 | Field | BI | 50mA - 3A |  | AVS
 |  | Solenoid valve | AVS-5121-24D | Control Cabinet | BO | 1.5 - 8.0 bar |  | AVS
HS-519 | H 519 | Ball valve with pneumatic actuator | K60D-32-DA63 | Field |  | 0 - 40 bar | 32 | AVS
 |  | Limit switch | SB 01205 | Field | BI | 50mA - 3A |  | AVS
 |  | Solenoid valve | AVS-5121-24D | Control Cabinet | BO | 1.5 - 8.0 bar |  | AVS
HIV-521 | H 521 | Control valve with pneumatic actuator | Axiom AX | Field | AO | 4-20mA | 25 | Metso's Neles
 |  | Limit switch | SB 01205 | Field | BI | 50mA - 3A |  | AVS
 |  | Solenoid valve | AVS-5121-24D | Control Cabinet | BO | 1.5 - 8.0 bar |  | AVS
LSA-513 | L 513 | Level switch alarm | Liquipoint FTW23 | Field | BI | 0 - 16 bar |  | Endress+Hauser
 |  |  | TRANSMITTER LIST
Tag number | Loop number | Service description | Production type | Location | I/O Type | Range or set point | Size (DN) | Manufacturer
LI-512 | L 512 | Level transmitter | Deltapilot FMB70 | Field | AI/AO | 4…20mA/ 0.1 - 10 bar/ 100m H2O |  | Endress+Hauser
LI-515 | L 515 | Level transmitter | Deltapilot FMB70 | Field | AI/AO | 4…20mA/ 0.1 - 10 bar/ 100m H2O |  | Endress+Hauser
TI-517 | T 517 | Temperature transmitter | iTHERM TrustSens TM372 | Field | AI/AO | 4…20mA/ 0 - 6.0 bar/ –40 to +160 °C |  | Endress+Hauser
TI-518 | T 518 | Temperature transmitter | iTHERM TrustSens TM372 | Field | AI/AO | 4…20mA/ 0 - 6.0 bar/ –40 to +160 °C |  | Endress+Hauser
FIC-516 | F 516 | Flow transmitter | Promag P 200 | Field | AI/AO | 4…20mA/ 0.01 - 10 m/s / –20 to +150 °C |  | Endress+Hauser
