ducnguyen4993/-Dispersing-Chemical-Liquids/loopdiagram/FIC-516.dxf

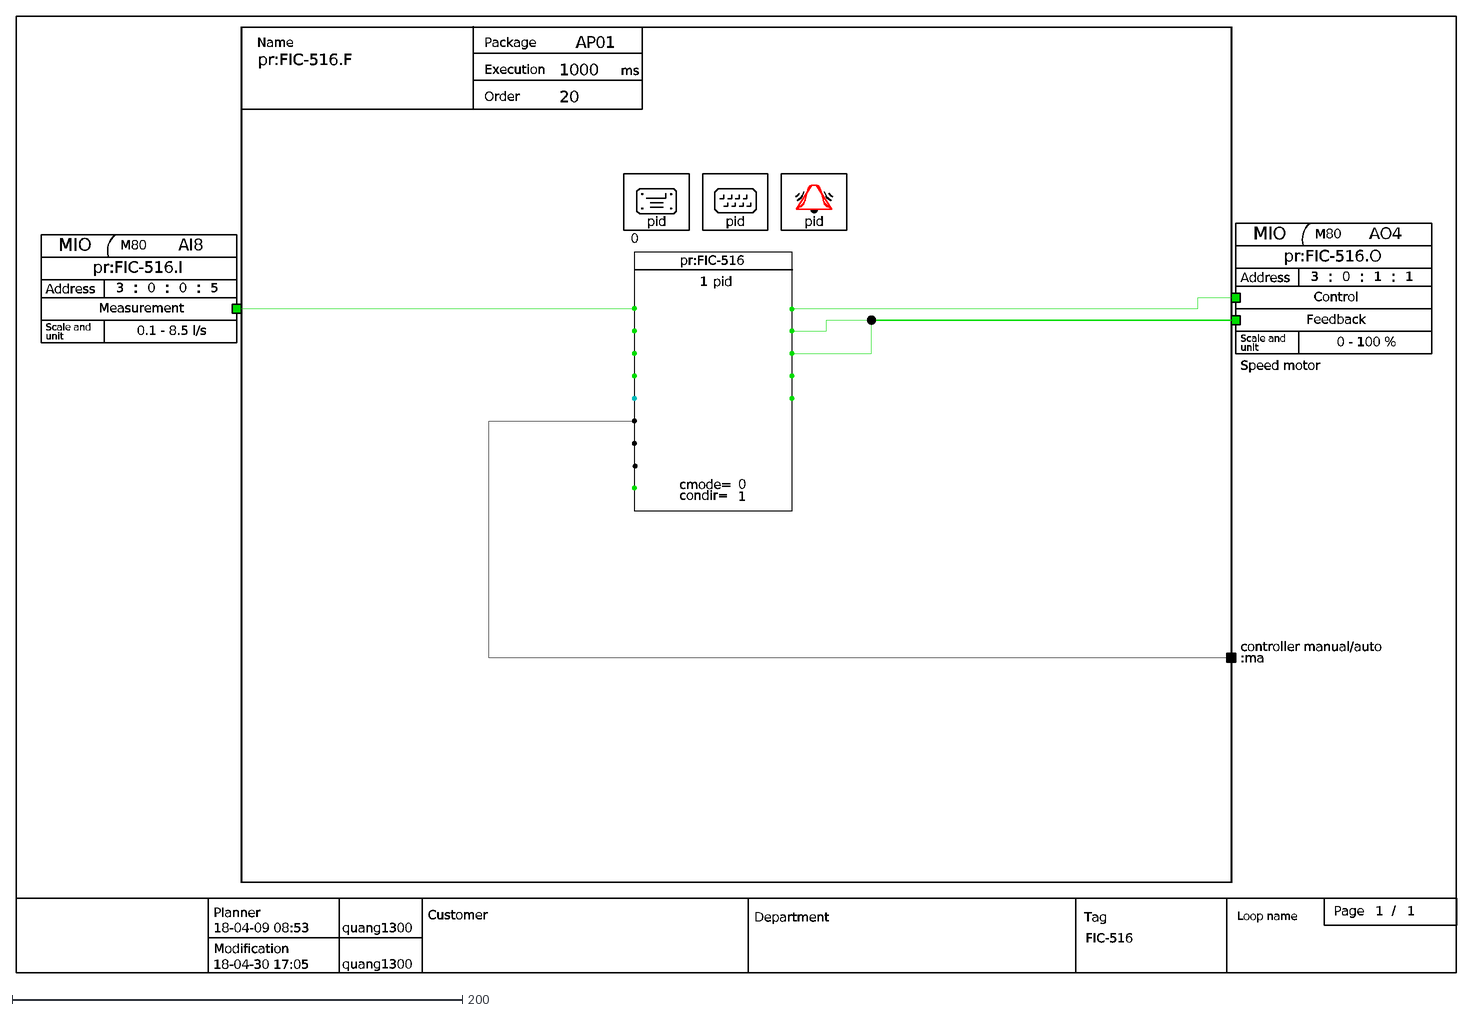
[picture p74: CAD file, 2020-09-22]
loopdiagram/FIC-516.dxf
1
normal
/
Page
FIC-516
complete
quang1300
18-04-09 08:53
18-04-30 17:05
Loop name
Tag
Department
Customer
Planner
Modification
pr:FIC-516.F
AP01
1000
20
Order
Name
Package
Execution
ms
pr:FIC-516
0
2
140
0.1
8.5
0.0
100.0
1.0
0,0.75
0,30.0
0,0.0
0,100.0
2.5
-100.0
cmode=
condir=
pid
pr:FIC-516.I
AI8
3
5
&mi
&ma
""
4
0.1 - 8.5 l/s
DefSimGroup
60
Flow Speed
Scale and
unit
MIO
M80
Address
: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
