ducnguyen4993/-Dispersing-Chemical-Liquids/loopdiagram/MO-03.dxf

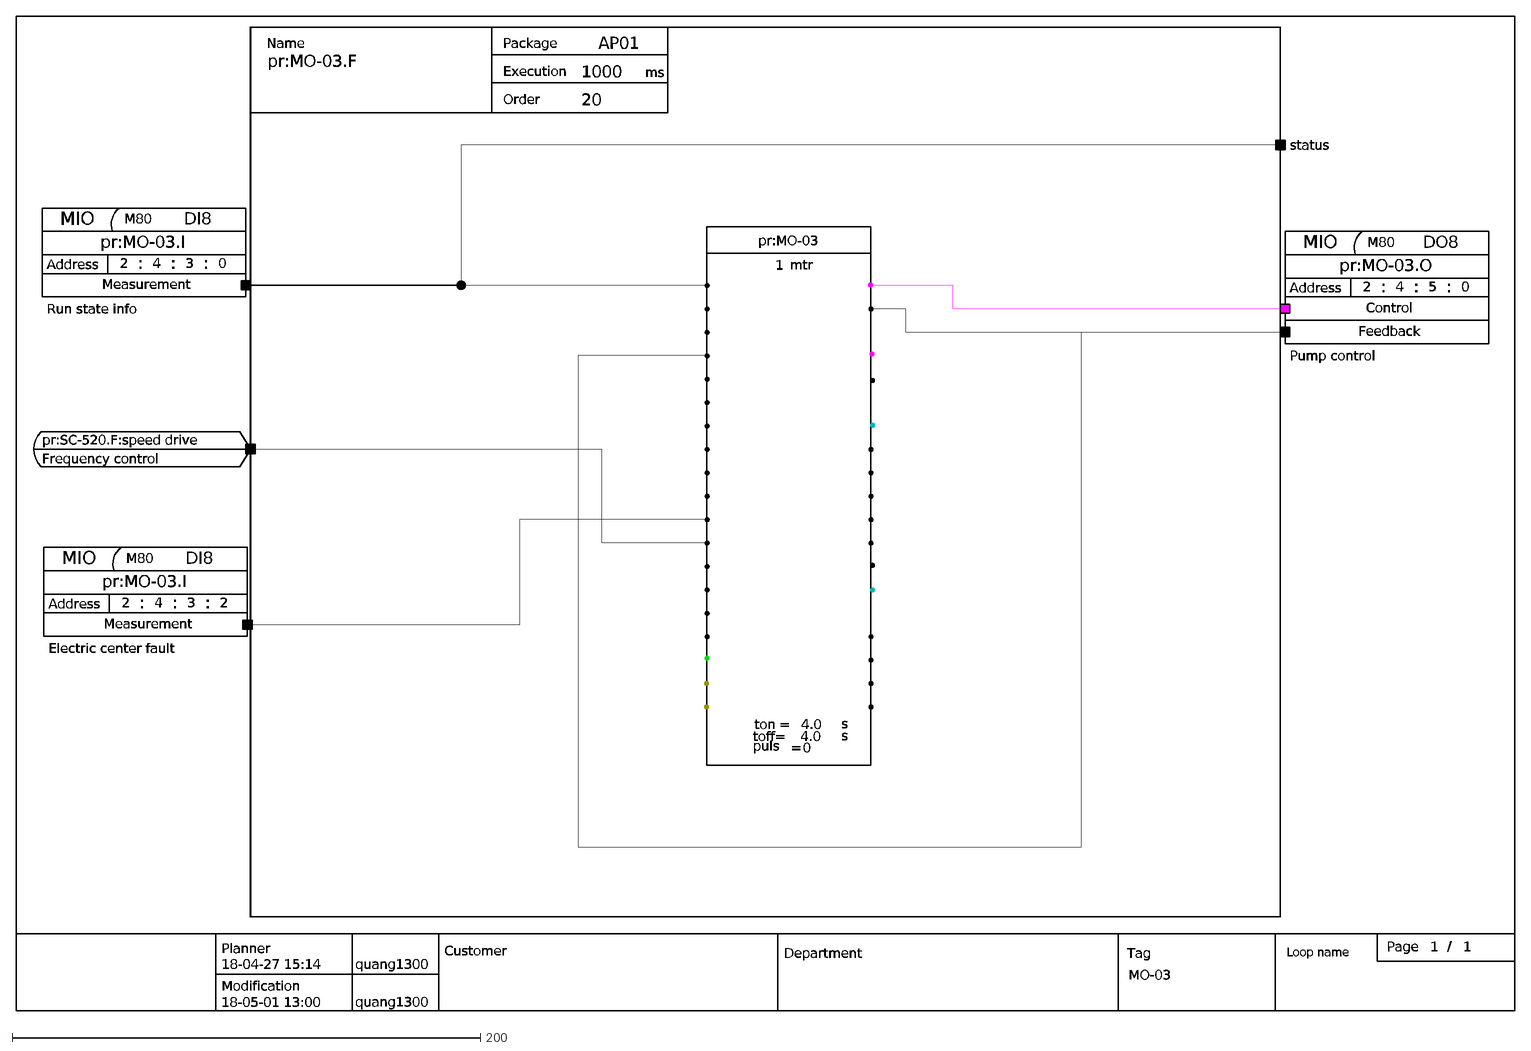
[picture p75: CAD file, 2020-09-22]
loopdiagram/MO-03.dxf
1
normal
/
Page
MO-03
complete
quang1300
18-04-27 15:14
18-05-01 13:00
Loop name
Tag
Department
Customer
Planner
Modification
pr:MO-03.F
AP01
1000
20
Order
Name
Package
Execution
ms
pr:MO-03
4.0
0
5.0
2
1.0
0.0
=
puls
s
toff=
ton =
mtr
pr:MO-03.I
DI8
4
3
13
12
""
Run state info
DefSimGroup
60
MIO
M80
Address
:
Measurement
Electric center fault
pr:MO-03.O
DO8
5
Pump control
Control
Feedback
status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
