ducnguyen4993/-Dispersing-Chemical-Liquids/loopdiagram/TI-517.dxf

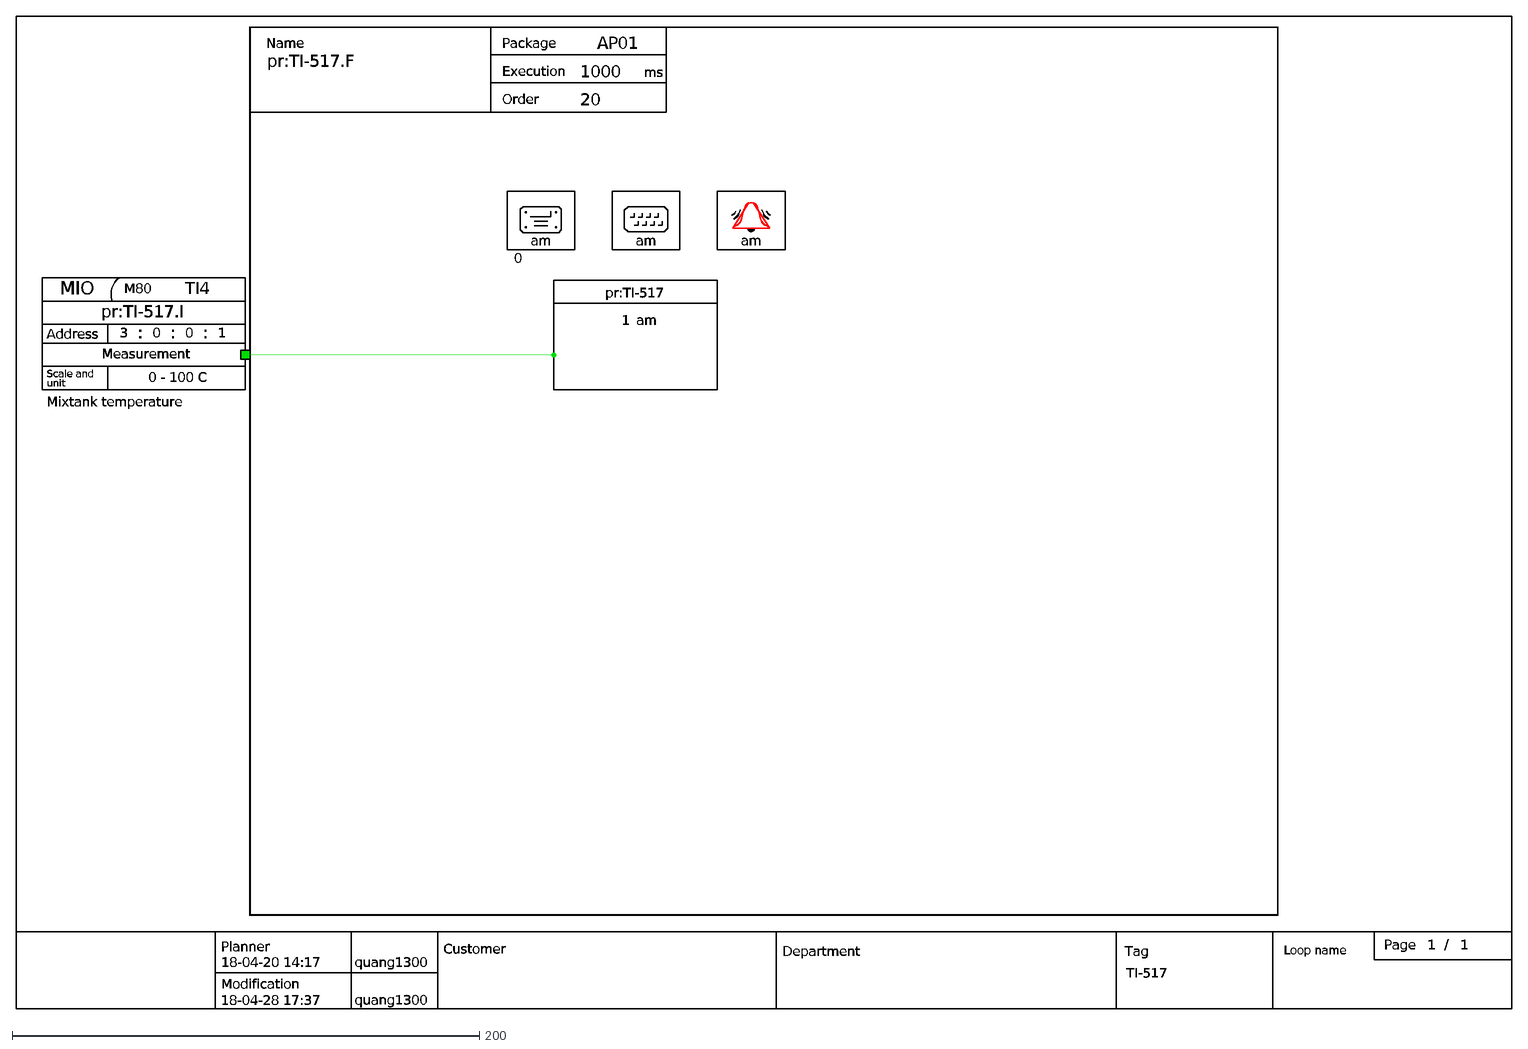
[picture p76: CAD file, 2020-09-22]
loopdiagram/TI-517.dxf
1
normal
/
Page
TI-517
complete
quang1300
18-04-20 14:17
18-04-28 17:37
Loop name
Tag
Department
Customer
Planner
Modification
pr:TI-517.F
AP01
1000
20
Order
Name
Package
Execution
ms
pr:TI-517.I
TI4
3
0
&mi
&ma
7
""
4
0 - 100 C
Mixtank temperature
DefSimGroup
60
2
Scale and
unit
MIO
M80
Address
:
Measurement
pr:TI-517
100.0
0.0
am
A1
100
%
pr
