ducnguyen4993/-Dispersing-Chemical-Liquids/loopdiagram/MO-01.dxf

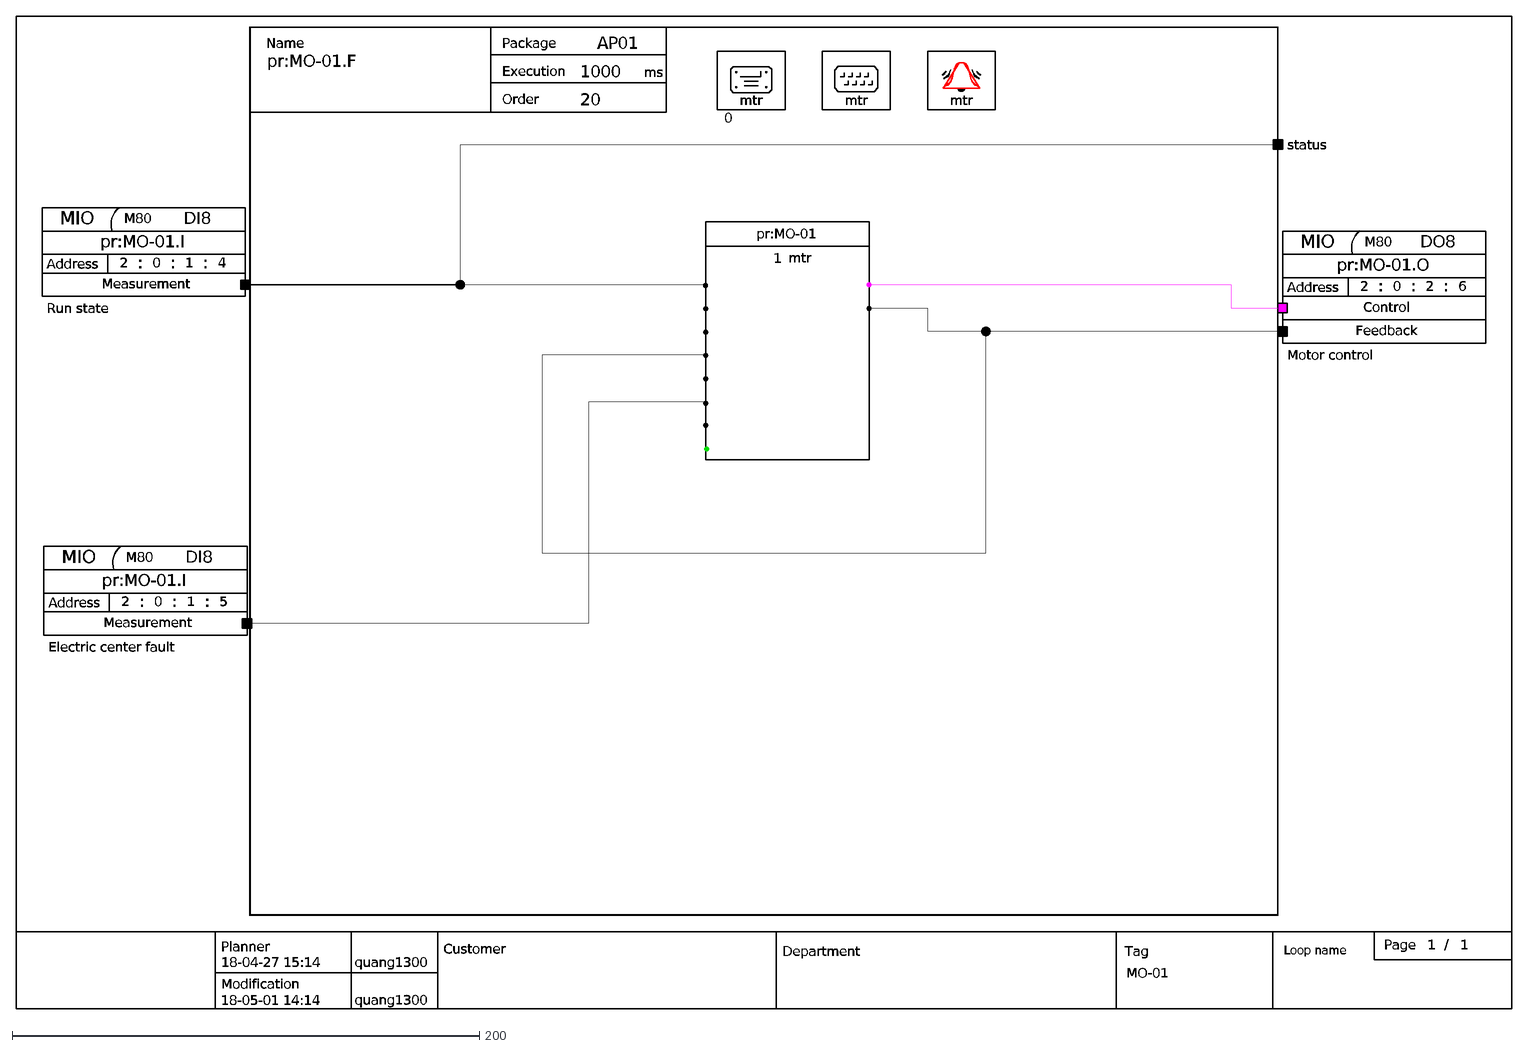
[picture p77: CAD file, 2020-09-22]
loopdiagram/MO-01.dxf
1
normal
/
Page
MO-01
complete
quang1300
18-04-27 15:14
18-05-01 14:14
Loop name
Tag
Department
Customer
Planner
Modification
pr:MO-01.F
AP01
1000
20
Order
Name
Package
Execution
ms
pr:MO-01.I
DI8
2
0
4
13
12
""
Run state
DefSimGroup
60
MIO
M80
Address
:
Measurement
5
Electric center fault
pr:MO-01.O
DO8
6
Motor control
Control
Feedback
status
pr:MO-01
4.0
5.0
1.0
100.0
mtr
A1
%
SK
THERM REL
THERM RELAY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
