ducnguyen4993/-Dispersing-Chemical-Liquids/loopdiagram/HS-510.dxf

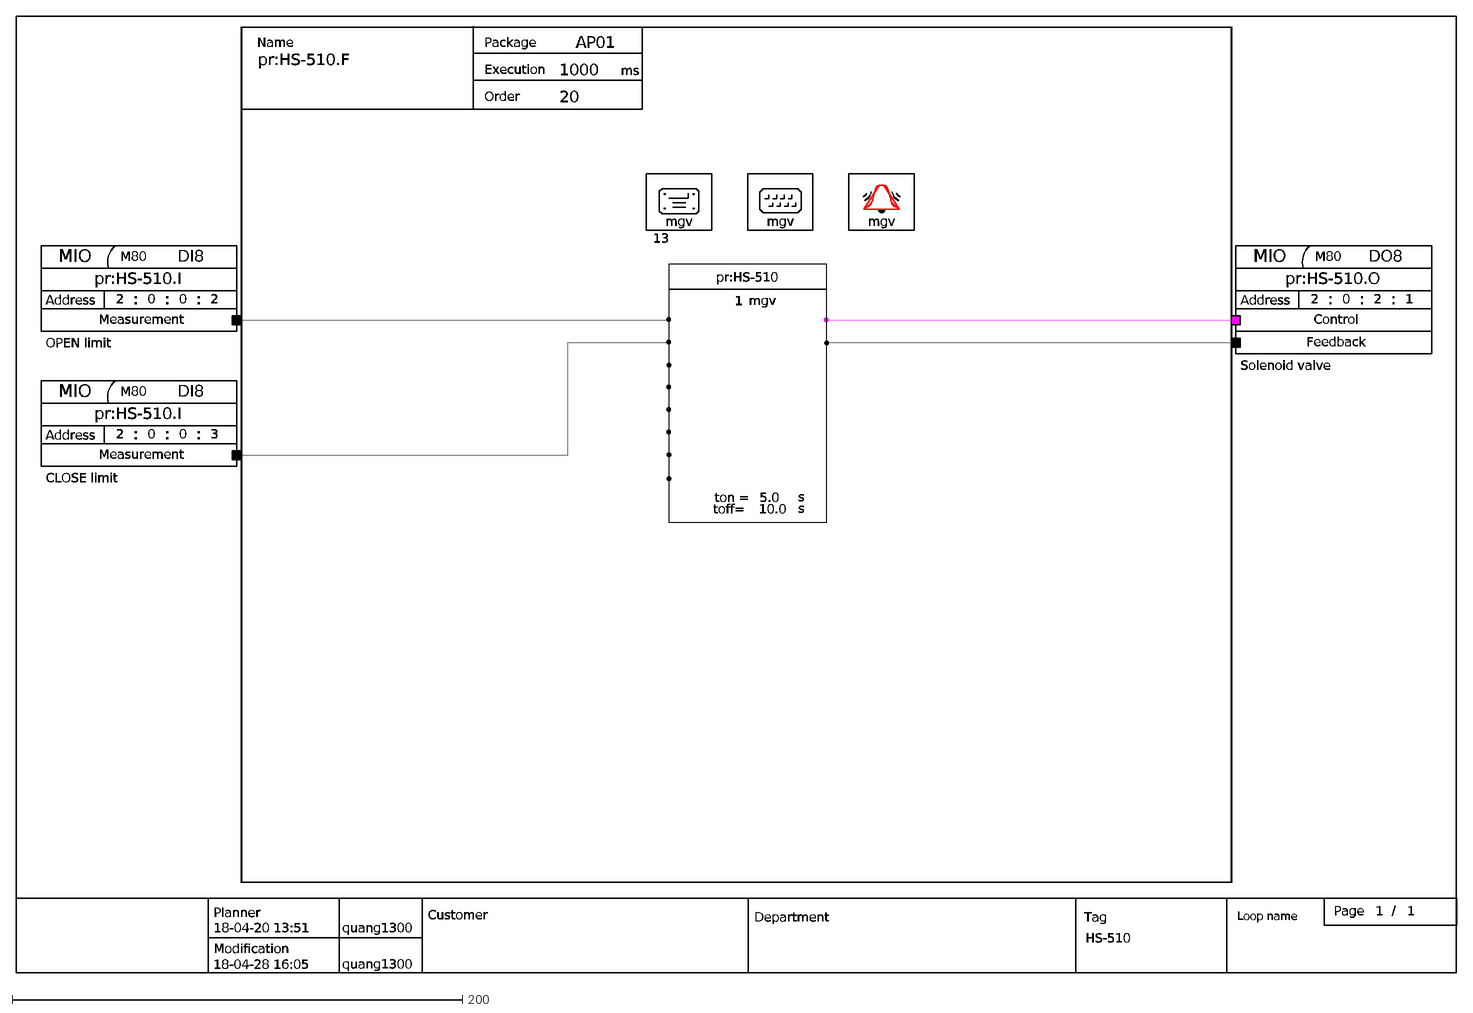
[picture p78: CAD file, 2020-09-22]
loopdiagram/HS-510.dxf
1
normal
/
Page
HS-510
complete
quang1300
18-04-20 13:51
18-04-28 16:05
Loop name
Tag
Department
Customer
Planner
Modification
pr:HS-510.F
AP01
1000
20
Order
Name
Package
Execution
ms
pr:HS-510
5.0
10.0
0
2
mgv
ton =
toff=
s
pr:HS-510.O
DO8
""
Solenoid valve
DefSimGroup
60
MIO
M80
Address
:
Control
Feedback
pr:HS-510.I
DI8
13
12
OPEN limit
Measurement
3
CLOSE limit
TAG_CODE
A1
pr
4
