ducnguyen4993/-Dispersing-Chemical-Liquids/loopdiagram/LI-515.dxf

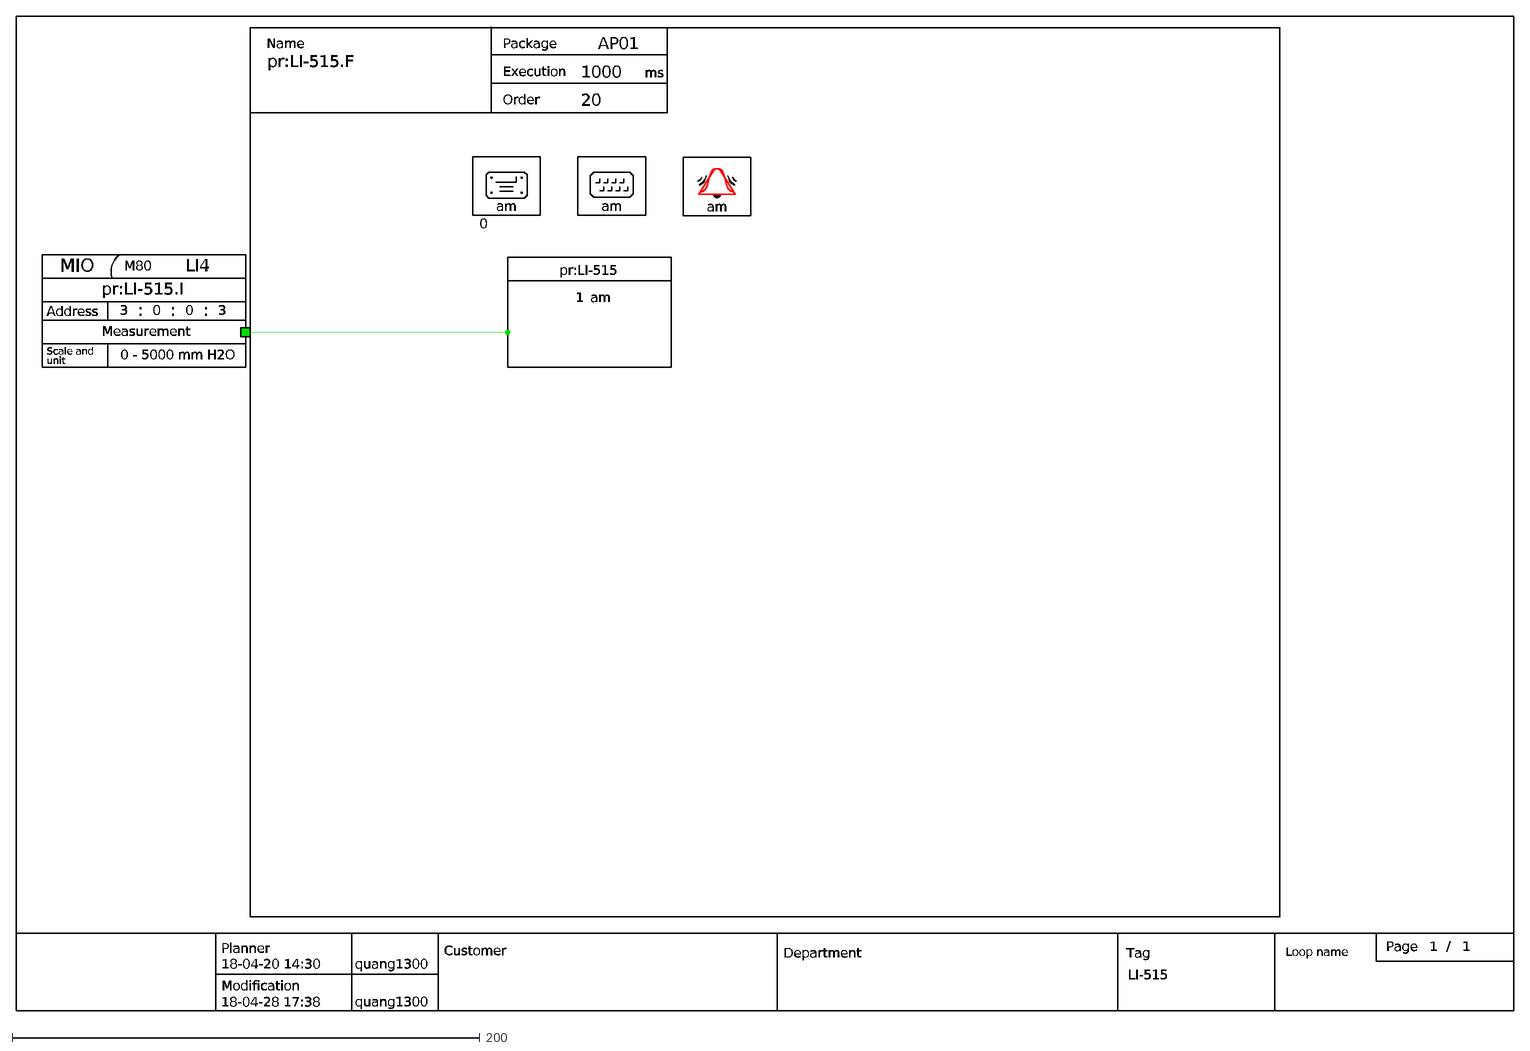
[picture p79: CAD file, 2020-09-22]
loopdiagram/LI-515.dxf
1
normal
/
Page
LI-515
complete
quang1300
18-04-20 14:30
18-04-28 17:38
Loop name
Tag
Department
Customer
Planner
Modification
pr:LI-515.F
AP01
1000
20
Order
Name
Package
Execution
ms
pr:LI-515.I
LI4
3
0
&mi
&ma
7
""
4
0 - 5000 mm H2O
DefSimGroup
60
2
Scale and
unit
MIO
M80
Address
:
Measurement
pr:LI-515
2000.0
0.0
am
A1
100
%
pr
