ducnguyen4993/-Dispersing-Chemical-Liquids/loopdiagram/HIV-521.dxf

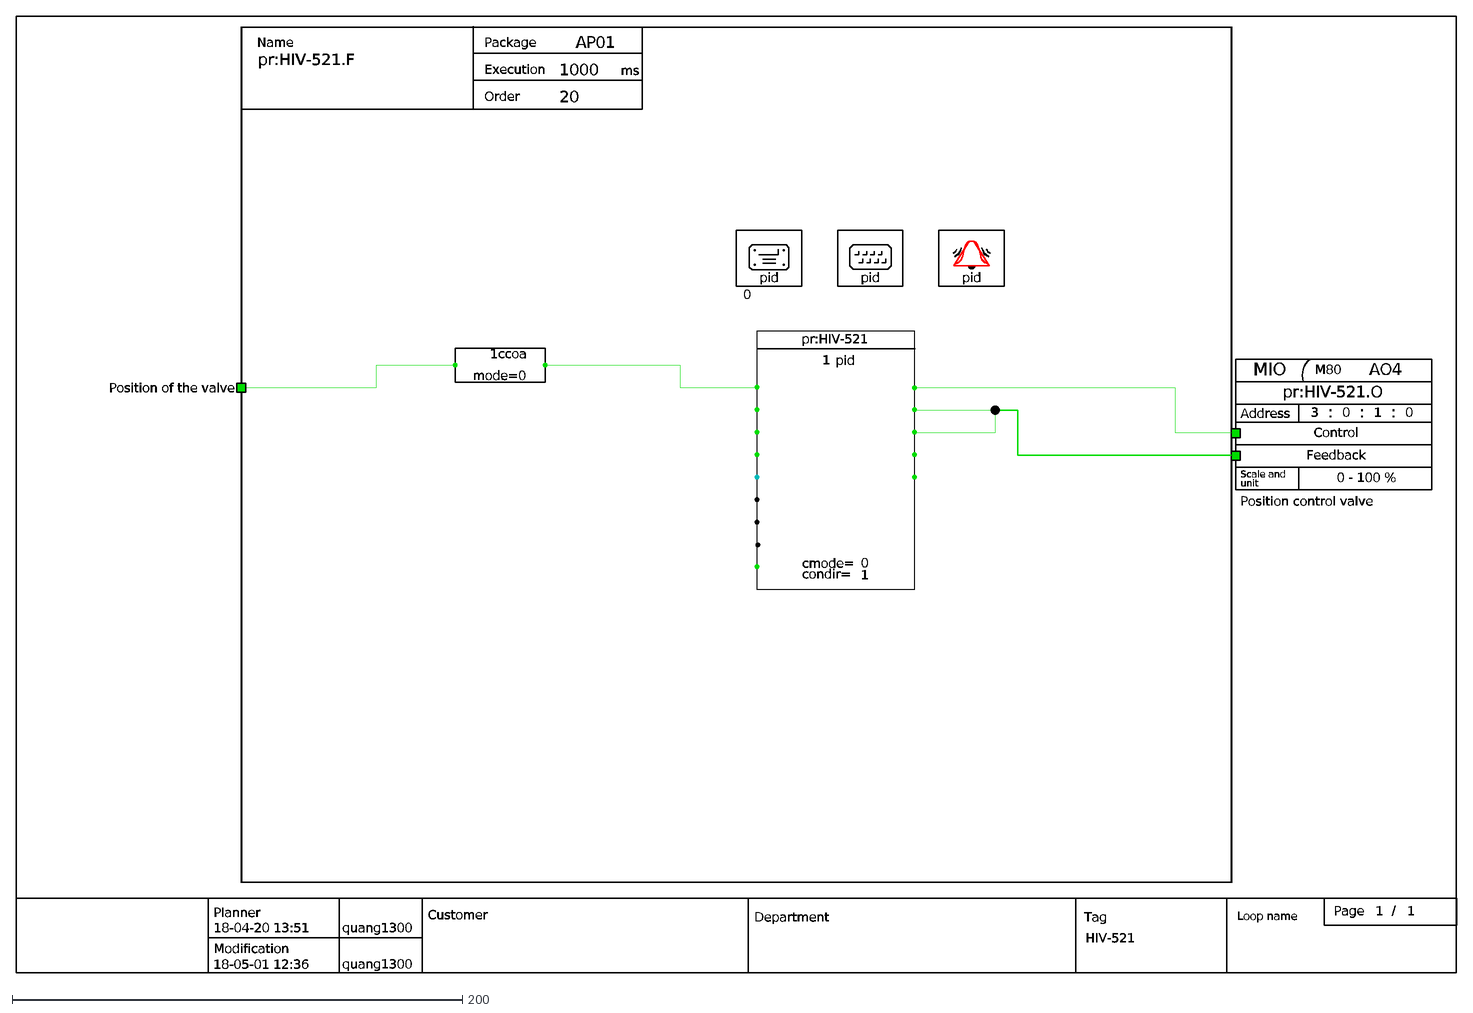
[picture p80: CAD file, 2020-09-22]
loopdiagram/HIV-521.dxf
1
normal
/
Page
HIV-521
complete
quang1300
18-04-20 13:51
18-05-01 12:36
Loop name
Tag
Department
Customer
Planner
Modification
pr:HIV-521.F
AP01
1000
20
Order
Name
Package
Execution
ms
pr:HIV-521.O
AO4
3
0
&mi
&ma
25
""
0 - 100 %
Position control valve
DefSimGroup
60
2
Scale and
unit
MIO
M80
Address
:
Control
Feedback
pr:HIV-521
140
0.0
100.0
1.0
0,0.75
0,30.0
0,0.0
0,100.0
-100.0
cmode=
condir=
pid
A1
100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
