ducnguyen4993/-Dispersing-Chemical-Liquids/loopdiagram/HS-519.dxf

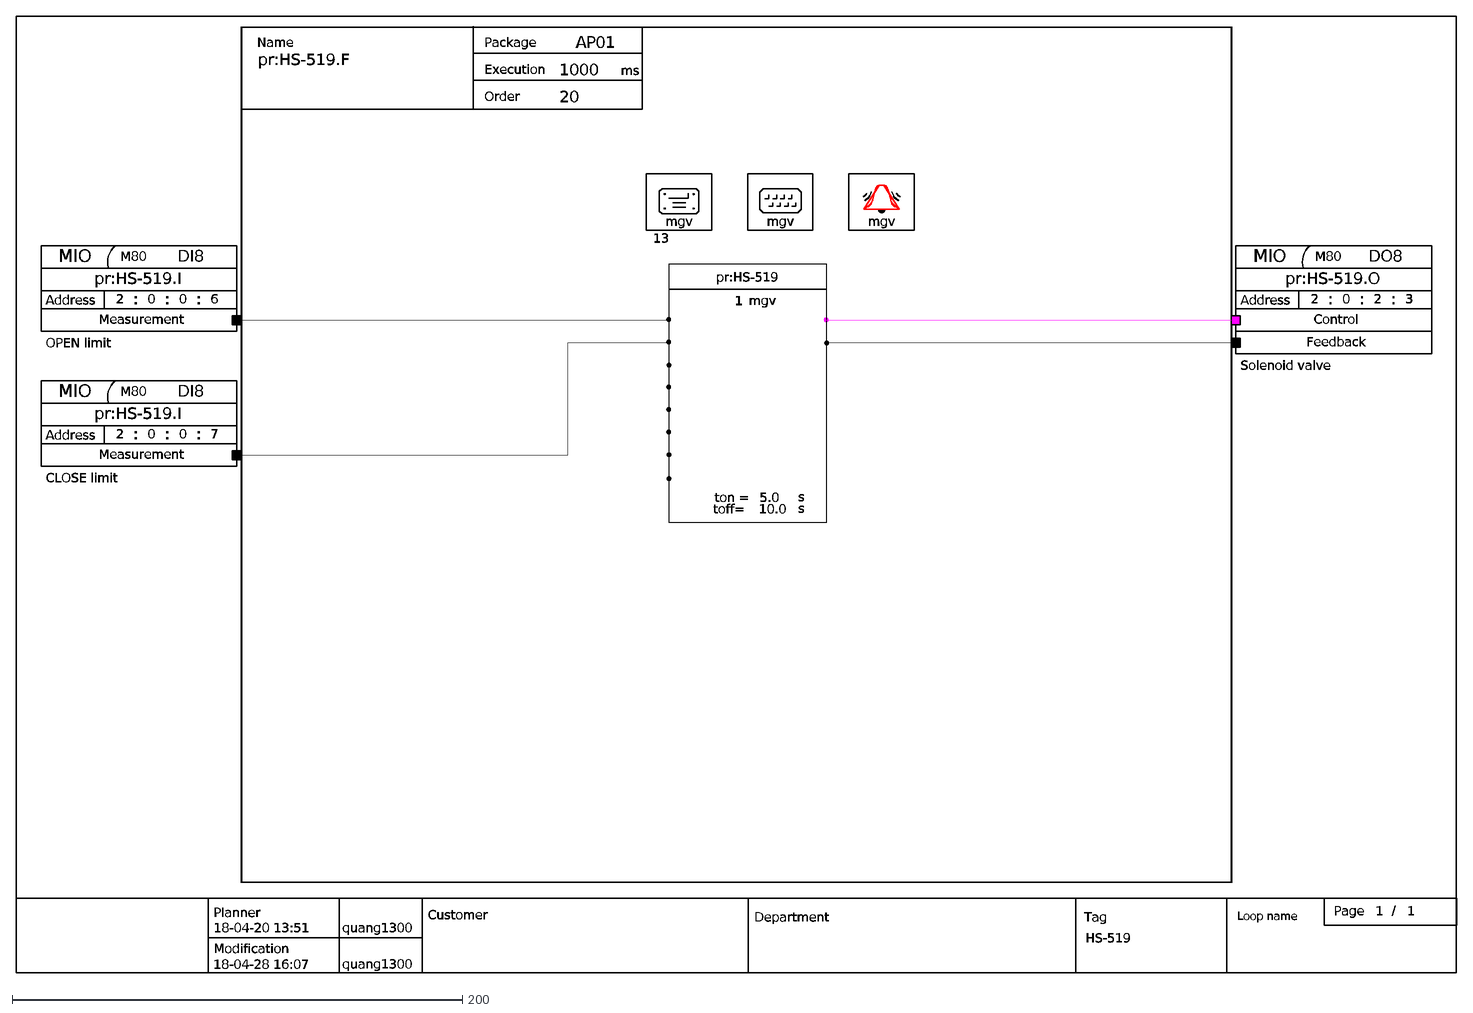
[picture p81: CAD file, 2020-09-22]
loopdiagram/HS-519.dxf
1
normal
/
Page
HS-519
complete
quang1300
18-04-20 13:51
18-04-28 16:07
Loop name
Tag
Department
Customer
Planner
Modification
pr:HS-519.F
AP01
1000
20
Order
Name
Package
Execution
ms
pr:HS-519
5.0
10.0
0
2
mgv
ton =
toff=
s
pr:HS-519.O
DO8
3
""
Solenoid valve
DefSimGroup
60
MIO
M80
Address
:
Control
Feedback
pr:HS-519.I
DI8
6
13
12
OPEN limit
Measurement
7
CLOSE limit
TAG_CODE
A1
pr
4
