ducnguyen4993/-Dispersing-Chemical-Liquids/loopdiagram/SC-520.dxf

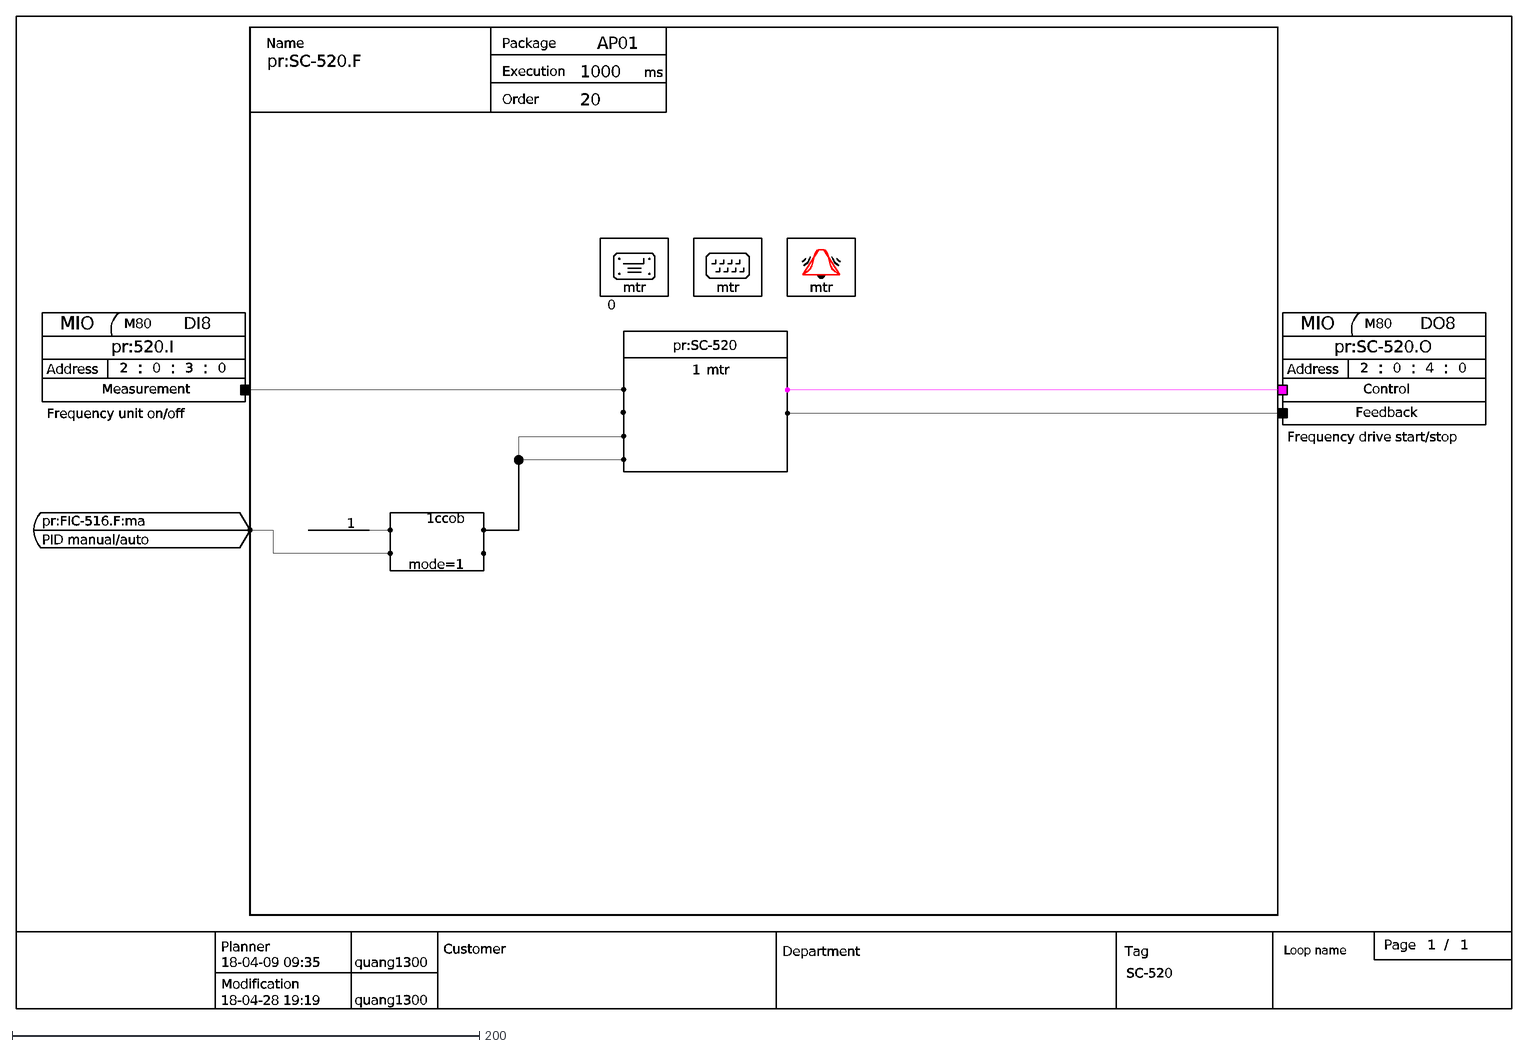
[picture p82: CAD file, 2020-09-22]
loopdiagram/SC-520.dxf
1
normal
/
Page
SC-520
complete
quang1300
18-04-09 09:35
18-04-28 19:19
Loop name
Tag
Department
Customer
Planner
Modification
pr:SC-520.F
AP01
1000
20
Order
Name
Package
Execution
ms
pr:SC-520
4.0
mtr
pr:SC-520.O
DO8
2
0
4
""
Frequency drive start/stop
DefSimGroup
60
MIO
M80
Address
:
Control
Feedback
A1
%
SK
THERM REL
THERM RELAY
TK
SAFETY SW
SAFETY SWITCH
pr
3
pr:520.I
DI8
13
12
Frequency unit on/off
Measurement
pr:FIC-516.F:ma
PID manual/auto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
