ducnguyen4993/-Dispersing-Chemical-Liquids/loopdiagram/TI-518.dxf

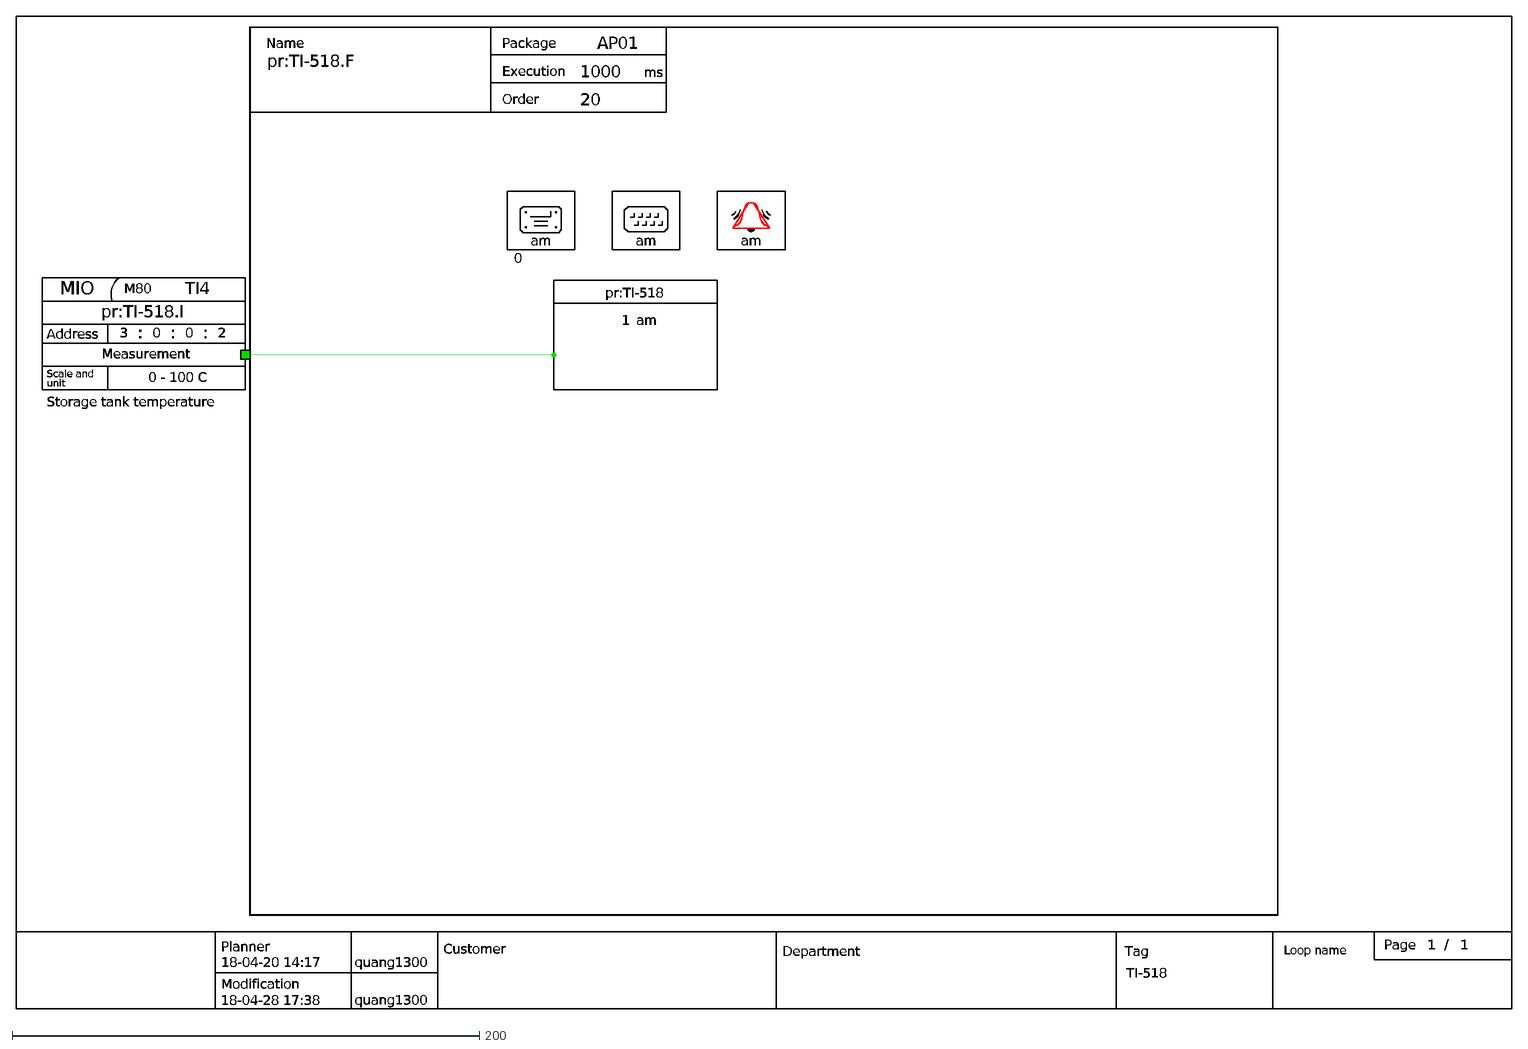
[picture p83: CAD file, 2020-09-22]
loopdiagram/TI-518.dxf
1
normal
/
Page
TI-518
complete
quang1300
18-04-20 14:17
18-04-28 17:38
Loop name
Tag
Department
Customer
Planner
Modification
pr:TI-518.F
AP01
1000
20
Order
Name
Package
Execution
ms
pr:TI-518.I
TI4
3
0
2
&mi
&ma
7
""
4
0 - 100 C
Storage tank temperature
DefSimGroup
60
Scale and
unit
MIO
M80
Address
:
Measurement
pr:TI-518
100.0
0.0
am
A1
100
%
pr
