ducnguyen4993/-Dispersing-Chemical-Liquids/loopdiagram/LSA-513.dxf

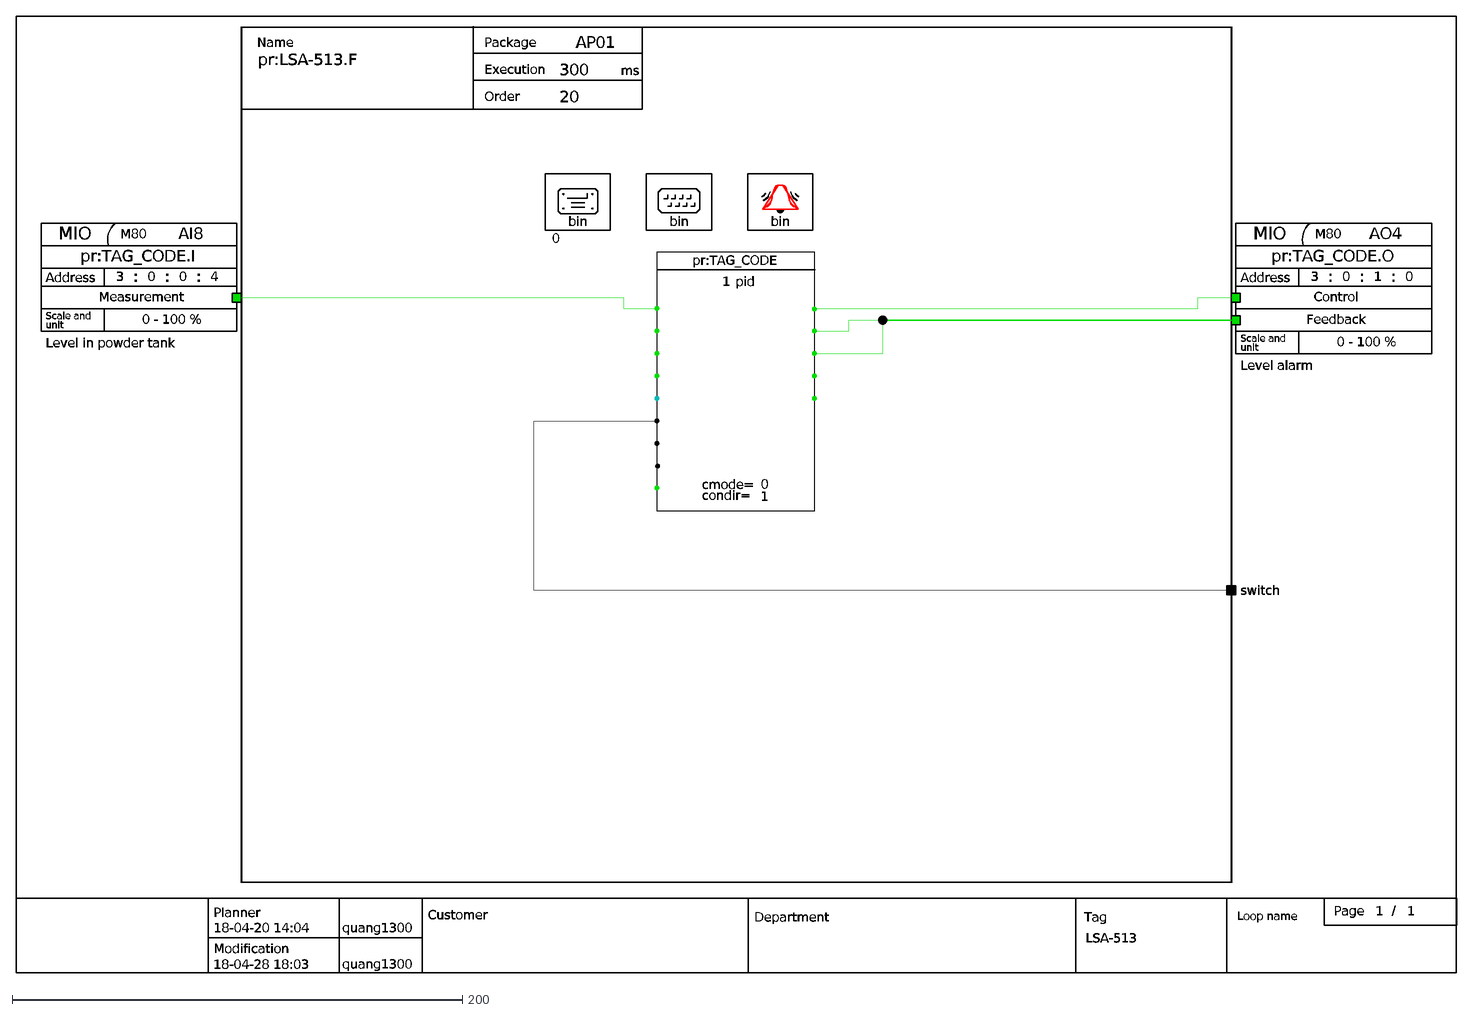
[picture p84: CAD file, 2020-09-22]
loopdiagram/LSA-513.dxf
1
normal
/
Page
LSA-513
complete
quang1300
18-04-20 14:04
18-04-28 18:03
Loop name
Tag
Department
Customer
Planner
Modification
pr:LSA-513.F
AP01
300
20
Order
Name
Package
Execution
ms
A1
0
STATE 0
STATE 1
bin
pr
3
4
7
2
pr:TAG_CODE.O
AO4
&mi
&ma
25
""
0 - 100 %
Level alarm
DefSimGroup
60
Scale and
unit
MIO
M80
Address
:
Control
Feedback
pr:TAG_CODE
140
0.0
100.0
1.0
0,0.75
0,30.0
0,0.0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
