ducnguyen4993/-Dispersing-Chemical-Liquids/loopdiagram/LI-512.dxf

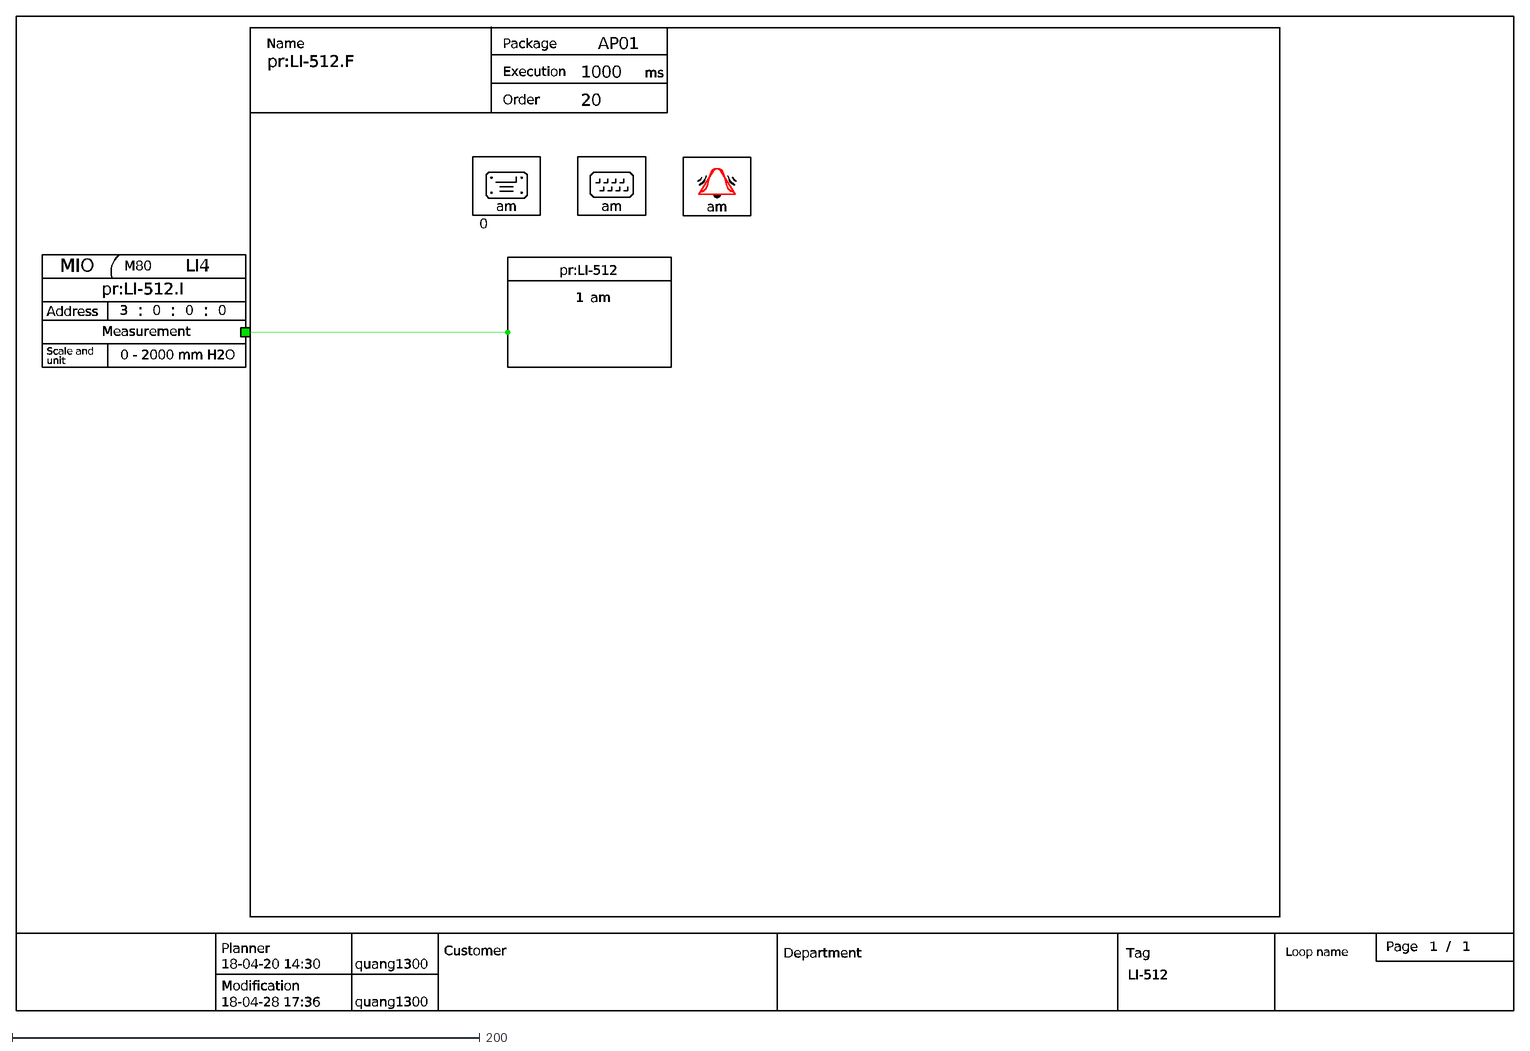
[picture p85: CAD file, 2020-09-22]
loopdiagram/LI-512.dxf
1
normal
/
Page
LI-512
complete
quang1300
18-04-20 14:30
18-04-28 17:36
Loop name
Tag
Department
Customer
Planner
Modification
pr:LI-512.F
AP01
1000
20
Order
Name
Package
Execution
ms
pr:LI-512.I
LI4
3
0
&mi
&ma
7
""
4
0 - 2000 mm H2O
DefSimGroup
60
2
Scale and
unit
MIO
M80
Address
:
Measurement
pr:LI-512
2000.0
0.0
am
A1
100
%
pr
