ducnguyen4993/-Dispersing-Chemical-Liquids/loopdiagram/MO-02.dxf

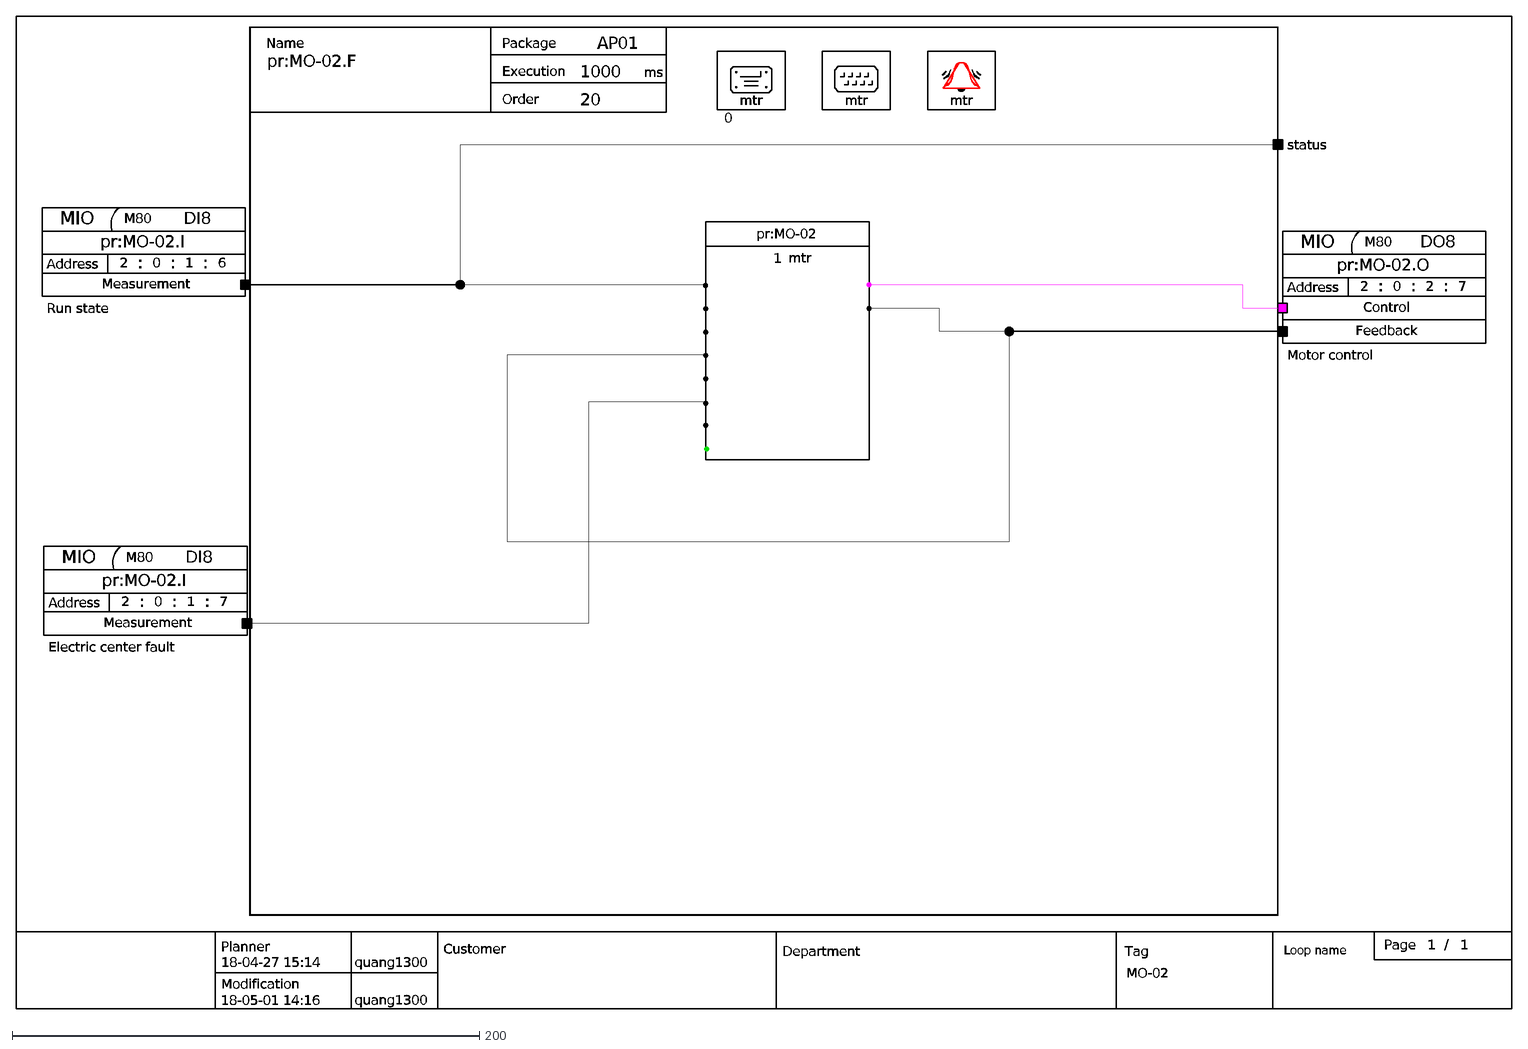
[picture p86: CAD file, 2020-09-22]
loopdiagram/MO-02.dxf
1
normal
/
Page
MO-02
complete
quang1300
18-04-27 15:14
18-05-01 14:16
Loop name
Tag
Department
Customer
Planner
Modification
pr:MO-02.F
AP01
1000
20
Order
Name
Package
Execution
ms
pr:MO-02.I
DI8
2
0
6
13
12
""
Run state
DefSimGroup
60
MIO
M80
Address
:
Measurement
7
Electric center fault
pr:MO-02.O
DO8
Motor control
Control
Feedback
status
pr:MO-02
4.0
5.0
1.0
100.0
mtr
A1
%
SK
THERM REL
THERM RELAY
TK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
