ducnguyen4993/-Dispersing-Chemical-Liquids/loopdiagram/HS-511.dxf

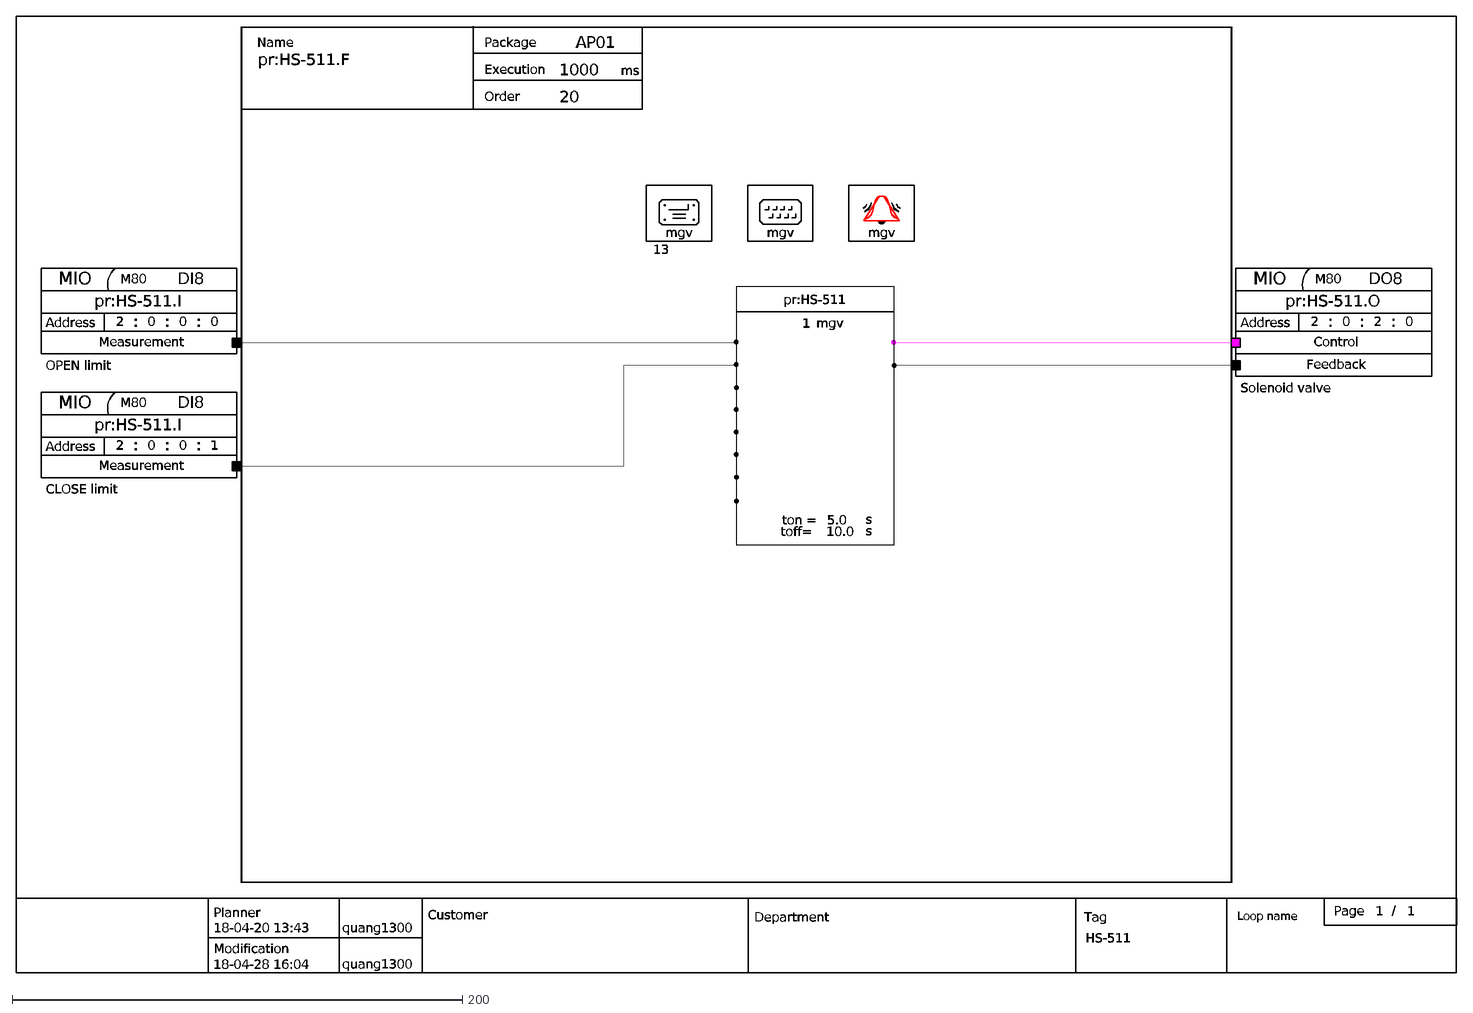
[picture p87: CAD file, 2020-09-22]
loopdiagram/HS-511.dxf
1
normal
/
Page
HS-511
complete
quang1300
18-04-20 13:43
18-04-28 16:04
Loop name
Tag
Department
Customer
Planner
Modification
pr:HS-511.F
AP01
1000
20
Order
Name
Package
Execution
ms
pr:HS-511
5.0
10.0
0
2
mgv
ton =
toff=
s
pr:HS-511.O
DO8
""
Solenoid valve
DefSimGroup
60
MIO
M80
Address
:
Control
Feedback
pr:HS-511.I
DI8
13
12
OPEN limit
Measurement
CLOSE limit
A1
pr
3
4
