ducnguyen4993/-Dispersing-Chemical-Liquids/loopdiagram/HS-514.dxf

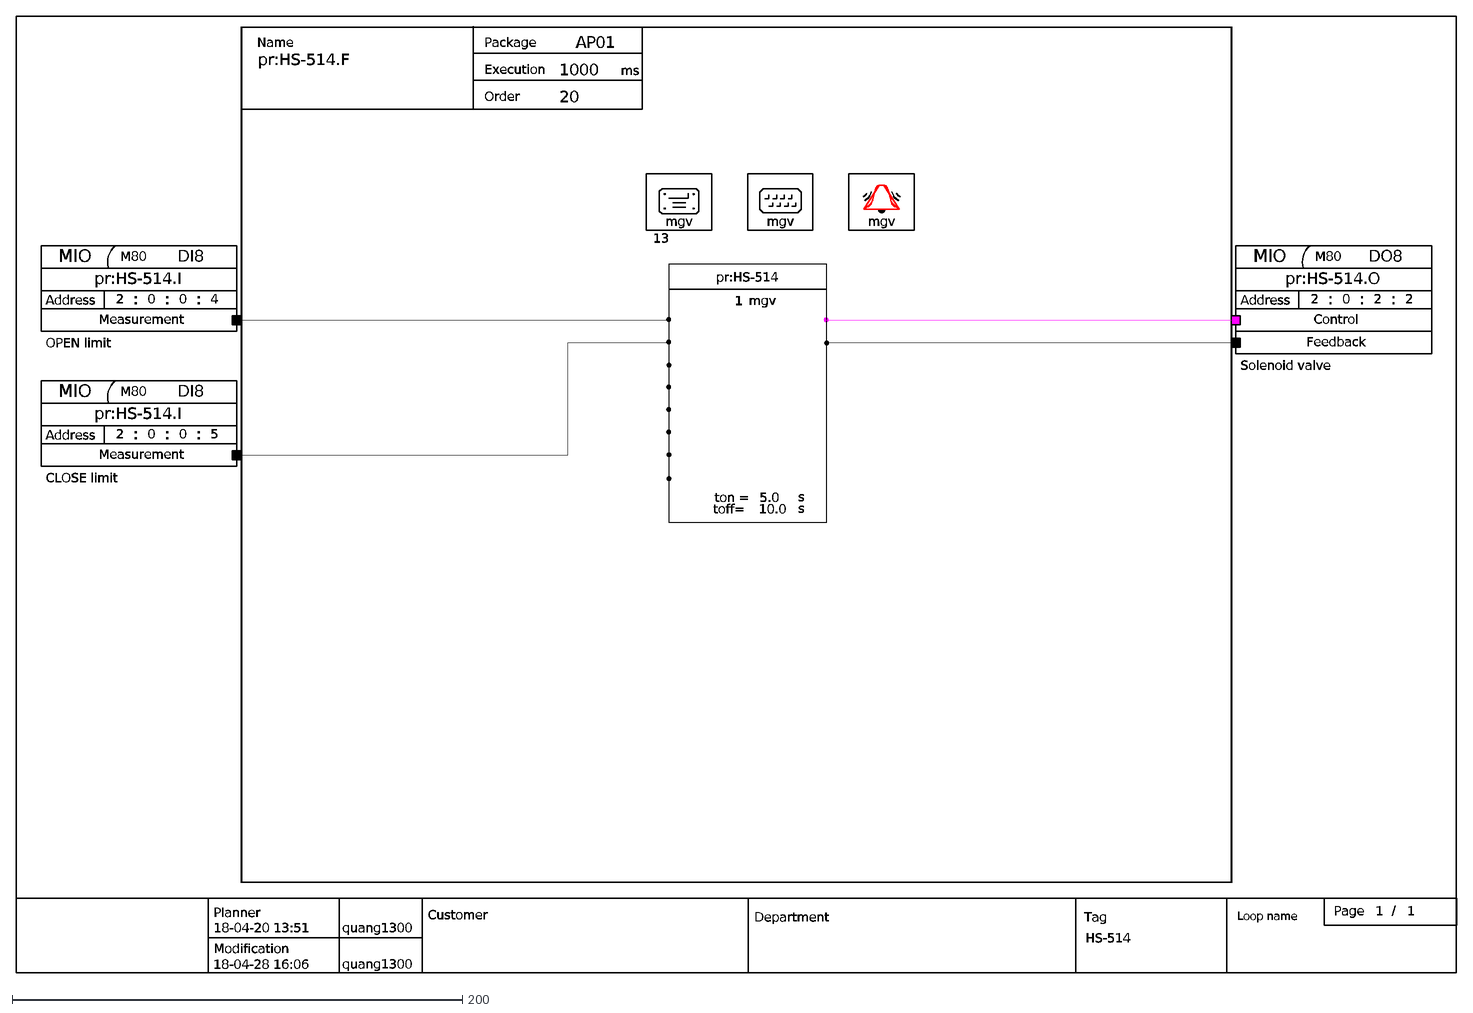
[picture p88: CAD file, 2020-09-22]
loopdiagram/HS-514.dxf
1
normal
/
Page
HS-514
complete
quang1300
18-04-20 13:51
18-04-28 16:06
Loop name
Tag
Department
Customer
Planner
Modification
pr:HS-514.F
AP01
1000
20
Order
Name
Package
Execution
ms
pr:HS-514
5.0
10.0
0
2
mgv
ton =
toff=
s
pr:HS-514.O
DO8
""
Solenoid valve
DefSimGroup
60
MIO
M80
Address
:
Control
Feedback
pr:HS-514.I
DI8
4
13
12
OPEN limit
Measurement
5
CLOSE limit
TAG_CODE
A1
pr
3
