ducnguyen4993/-Dispersing-Chemical-Liquids/hookupdrawing.pdf

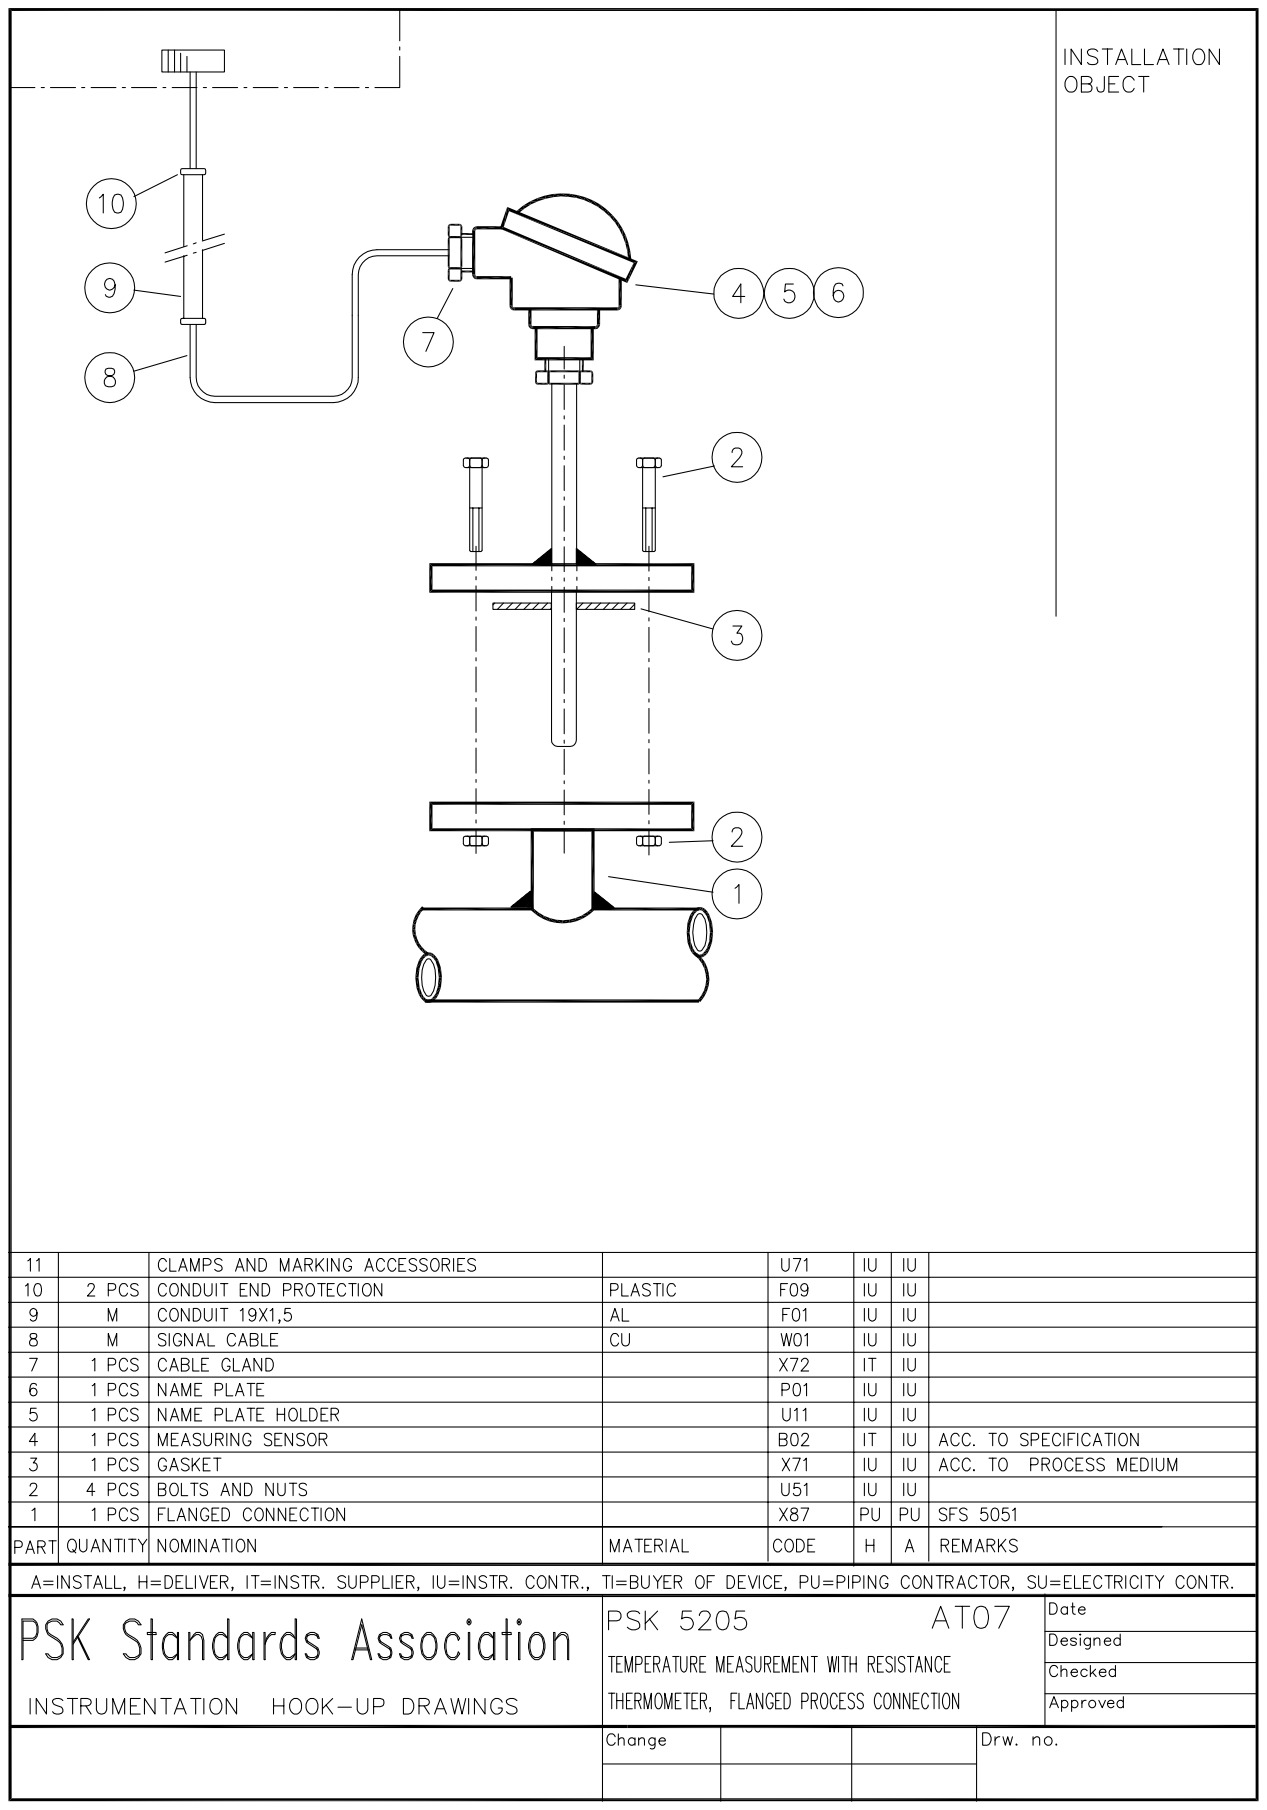
[picture p93: page 1]

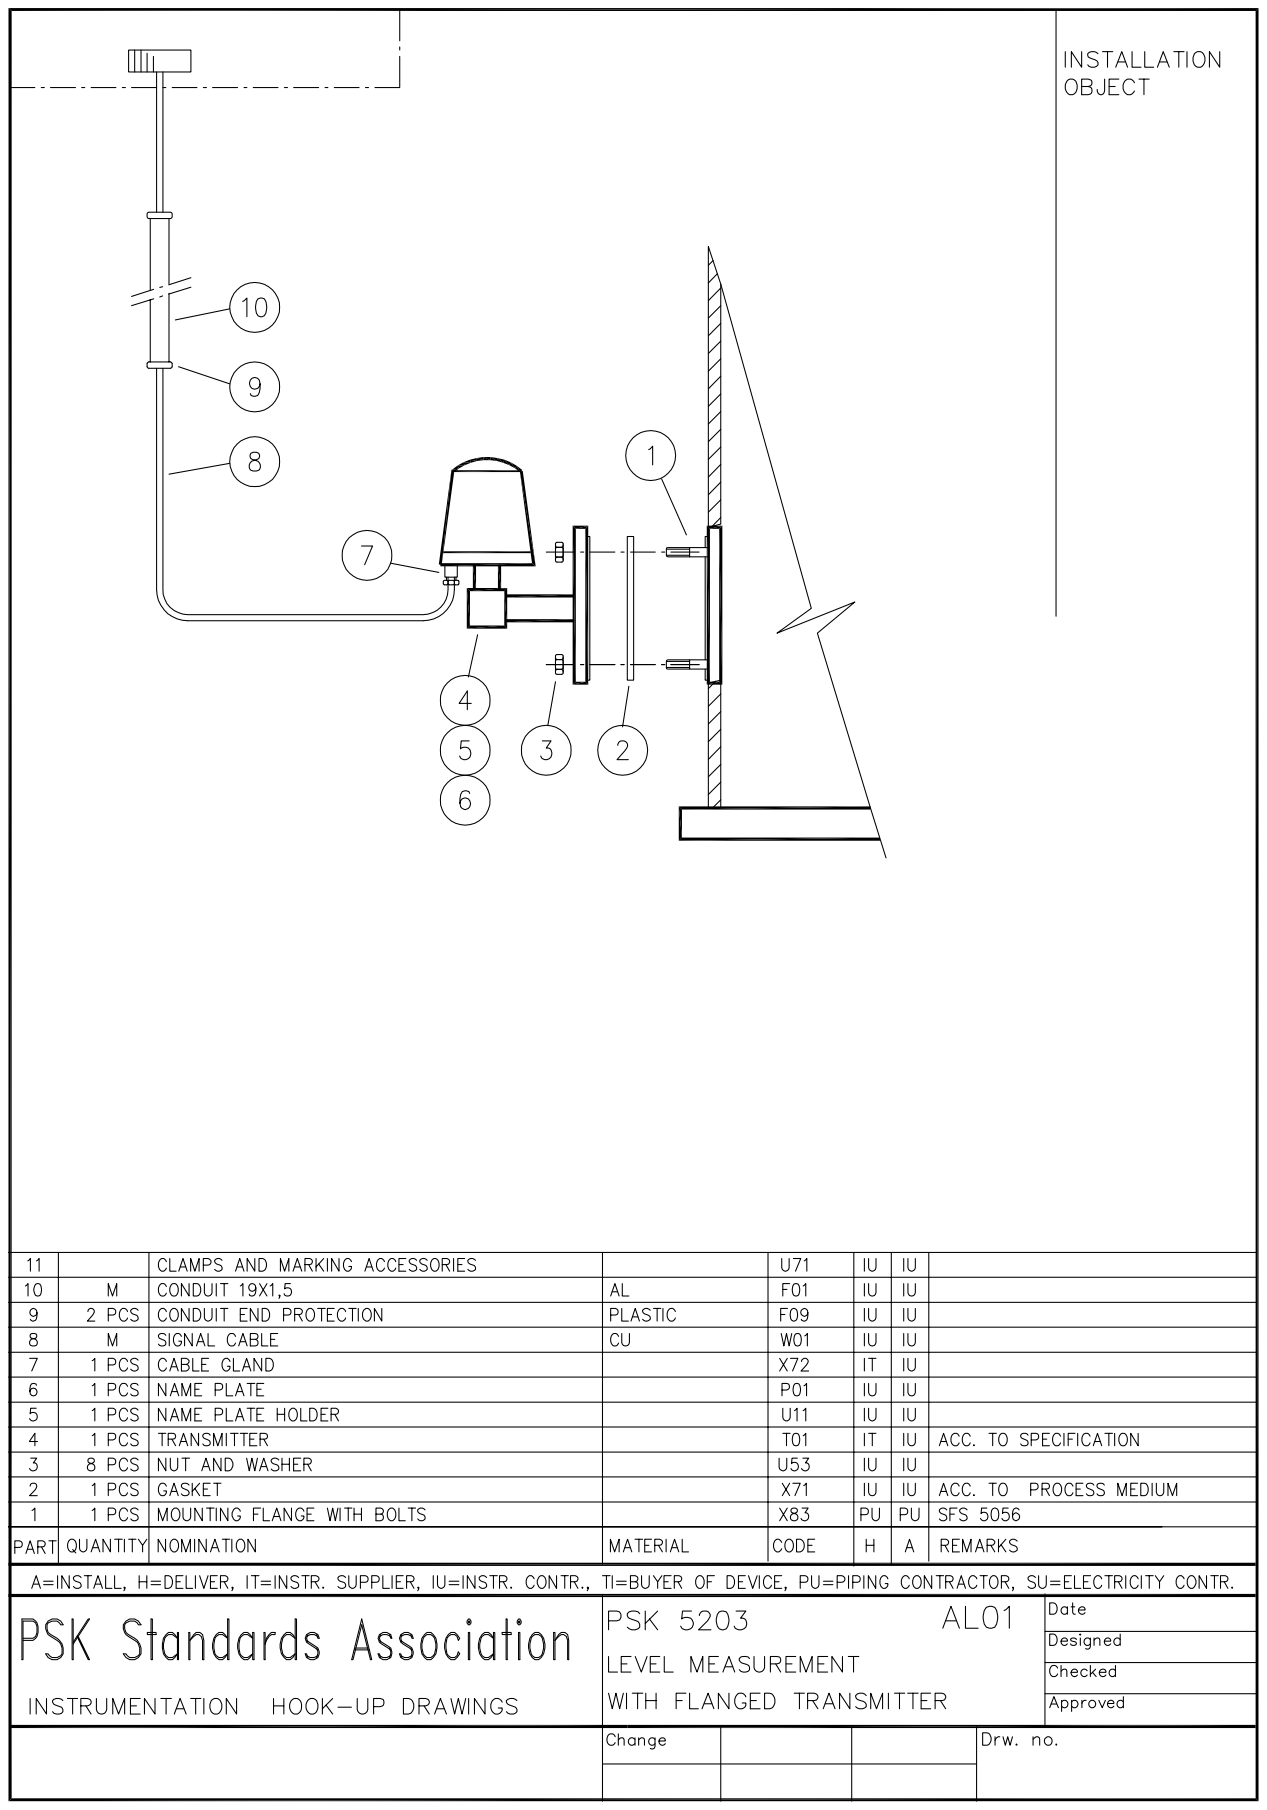
[picture p94: page 2]

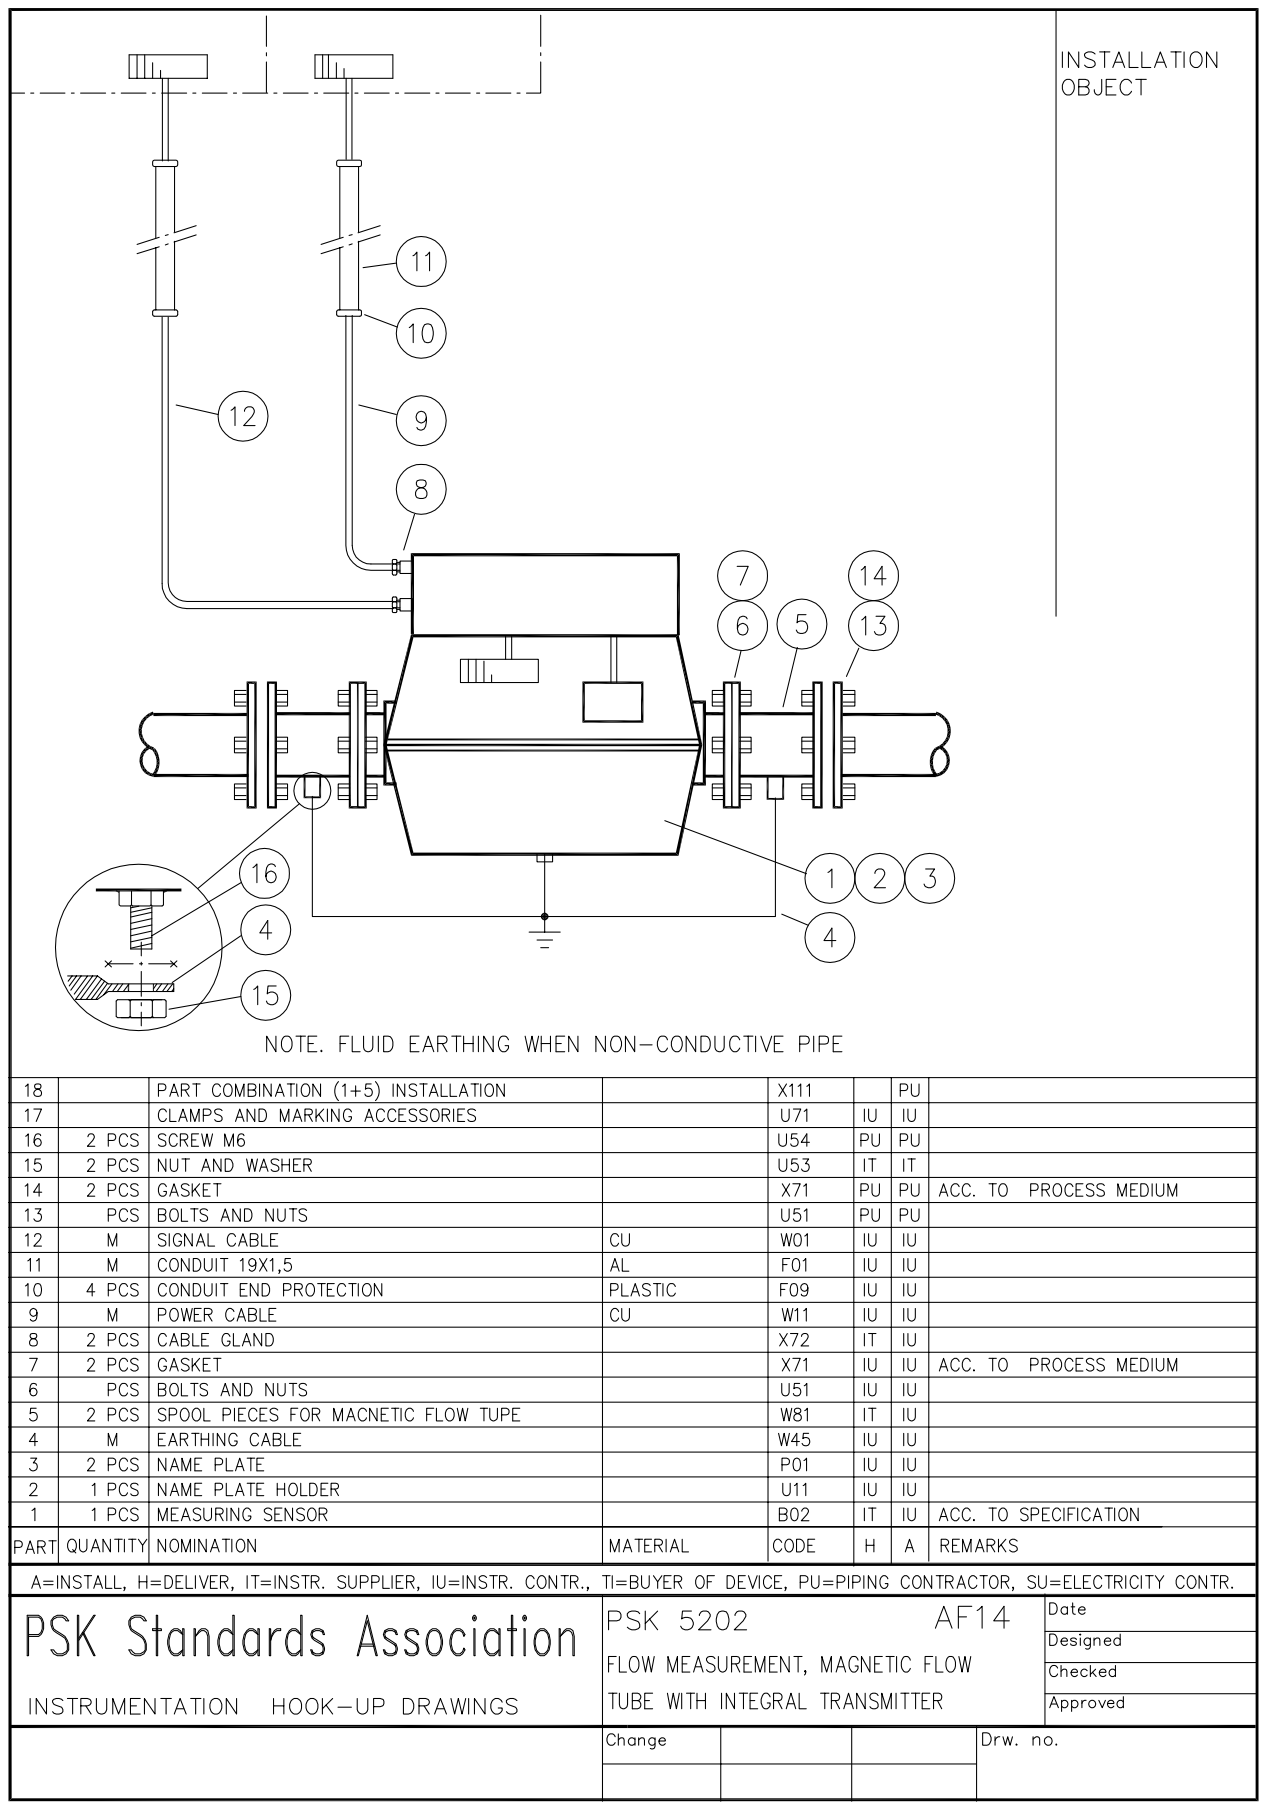
[picture p95: page 3]

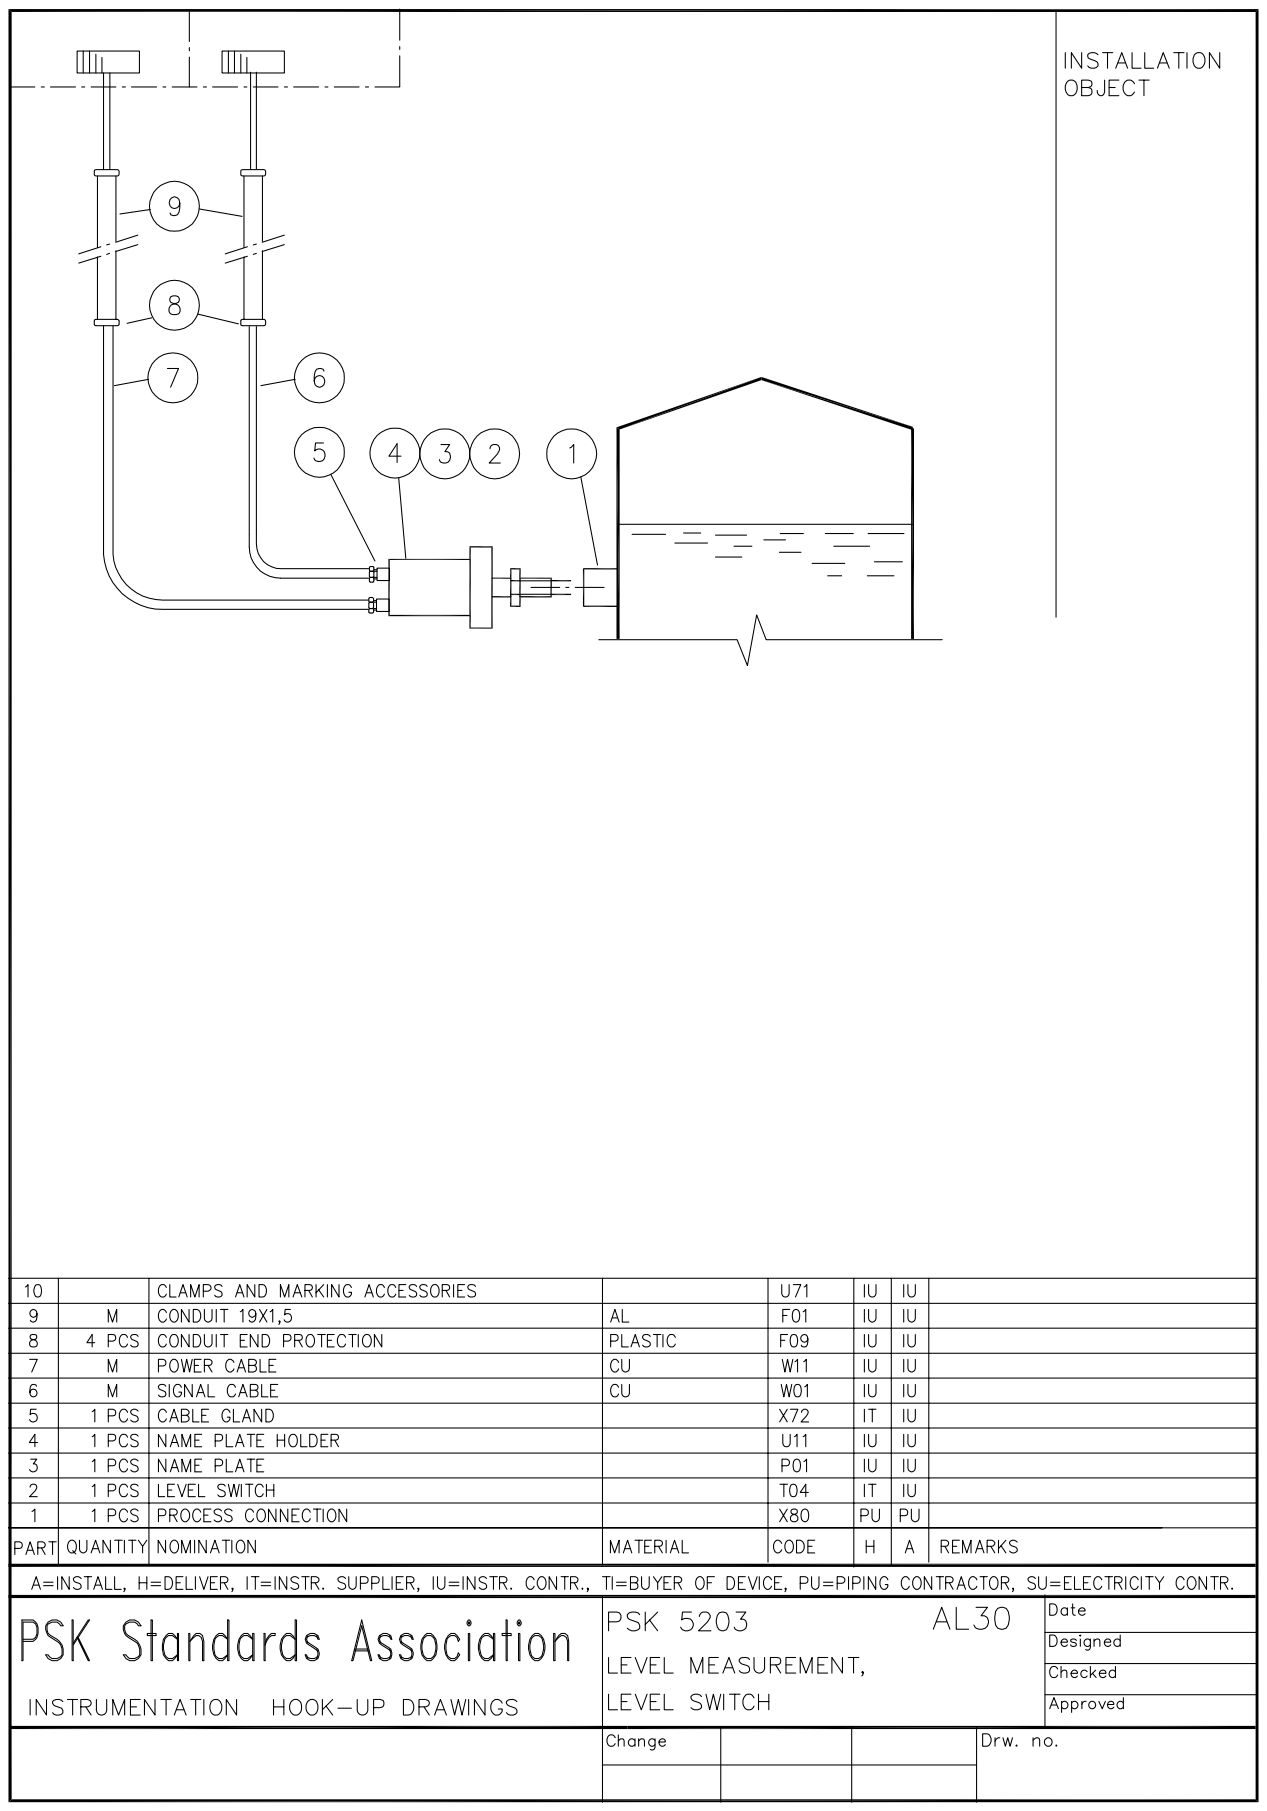
[picture p96: page 4]

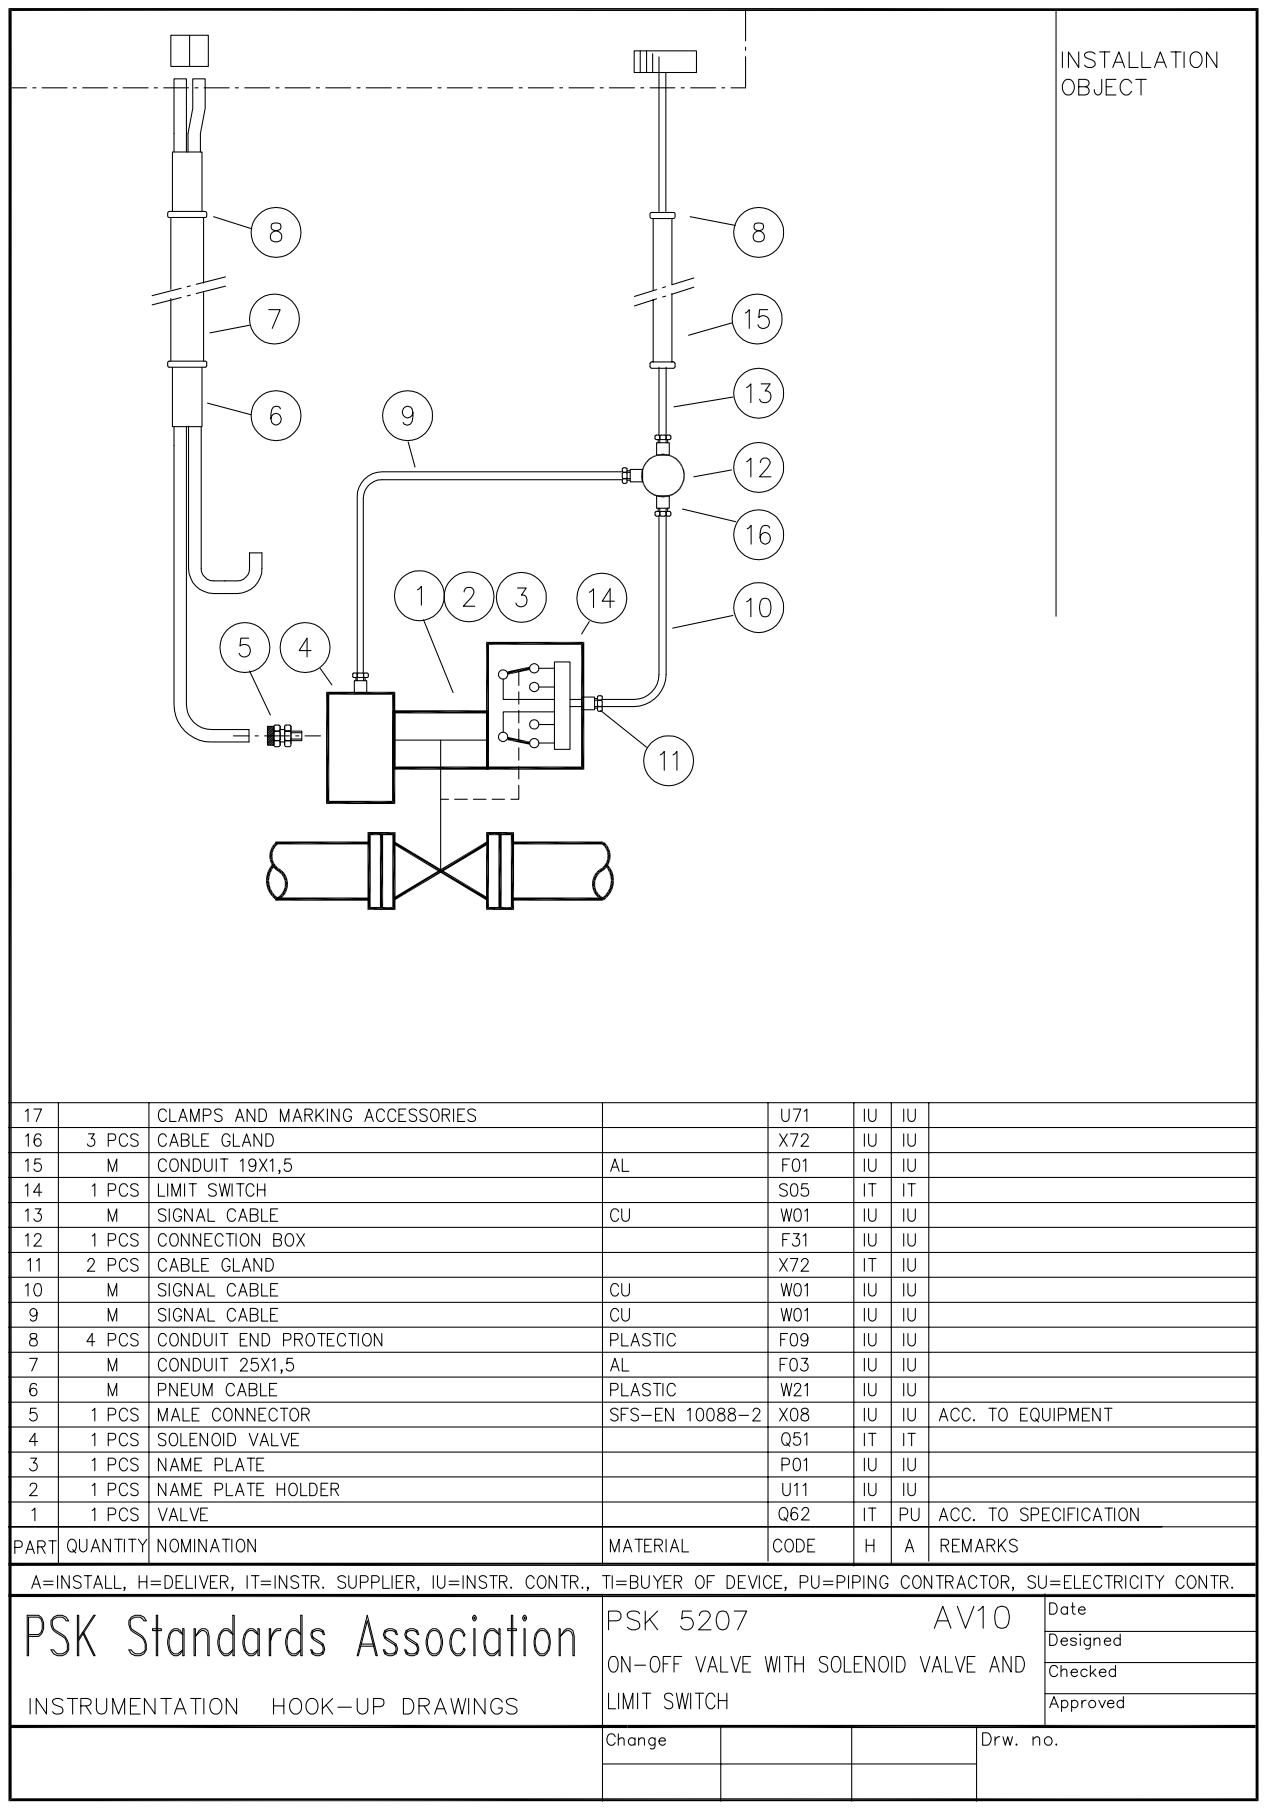
[picture p97: page 5]
