ducnguyen4993/-Dispersing-Chemical-Liquids/PI_drawing_dispersing unit.pdf

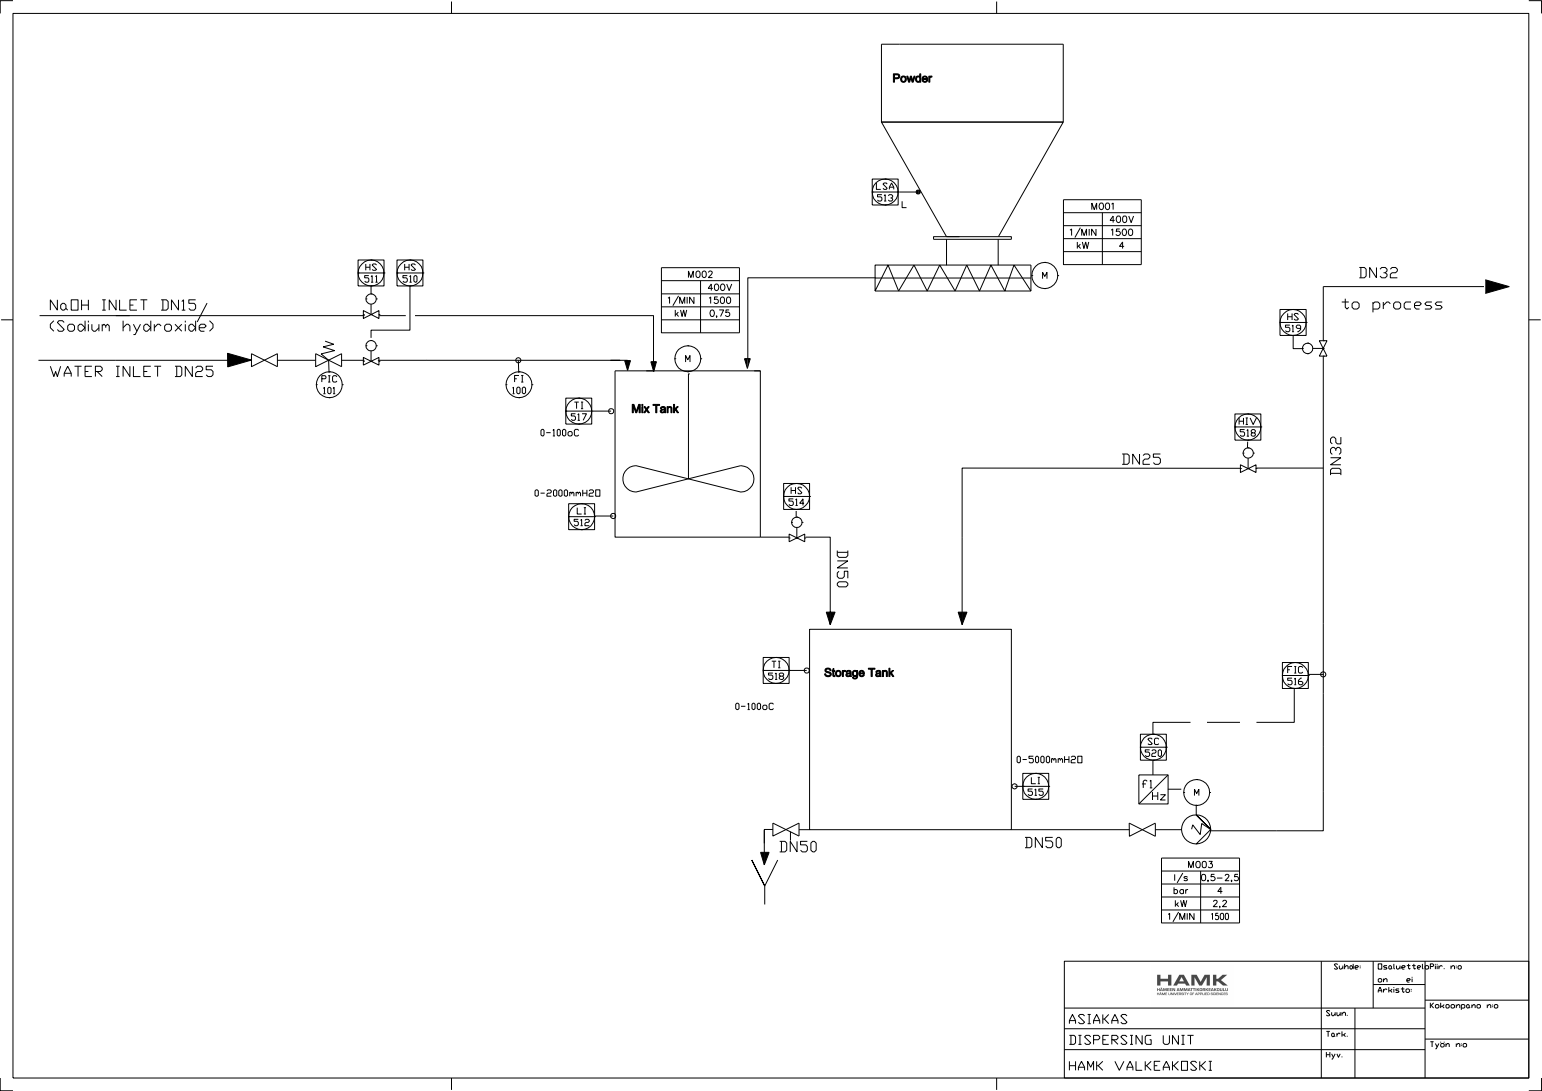
[picture p98: page 1]
Mix Tank; Powder; Storage Tank
